Rat-Rig/V-core-3/README.md

# Rat Rig V-Core-3

[Project Page](https://v-core.ratrig.com/)
