Rat-Rig/V-core-3/cad/panels/README.md

# Enclosure & Electronics panels

This subdirectory contains the source files for the various panels used on the V-Core 3.

# Formats
## DXF
For laser cutting, industry standard DXF files are provided. Both metric (millimeters) and imperial (inches) versions are available.

> **Please note:** The dimensions in the DXF files are exact. No provision for laser kerf has been provided as this varies greatly depending on the material being cut, the laser cutter being used, and / or the operator of the machine.

## STEP
For CNC routing, or CAD applications, industry standard STEP files are provided. Both metric (millimeters) and imperial (inches) versions are available.
