Rat-Rig/V-core-3/docs/src/slicer.md

---
title: Slicer
hide:
  - navigation
---

## SuperSlicer
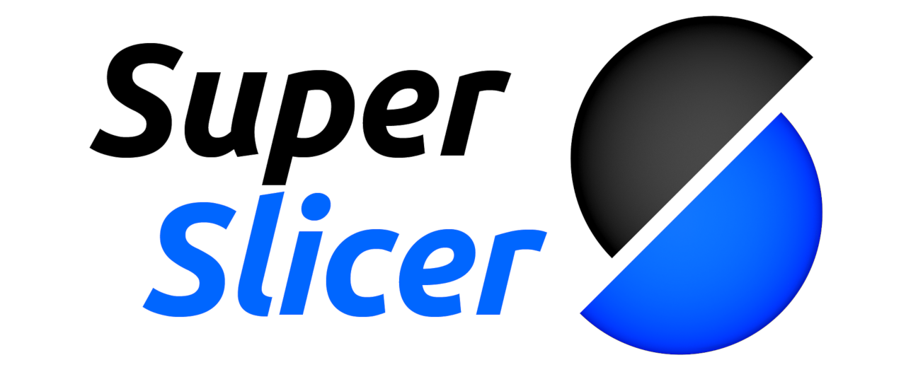
[picture p52: docs/src/assets/superslicer_logo.png]

Detlev Rackow, a member of Rat Rig's Beta/Dev team, provides SuperSlicer profiles for the V-Core 3 when running RatOS. As of version 2.3.57 these profiles are not included with SuperSlicer, and must be installed manually, but are planned to be intergrated in a future version.

### Obtaining SuperSlicer
SuperSlicer is a free and open-source project. It can be obtained directly from their [:material-github: GitHub repository](https://github.com/supermerill/SuperSlicer/releases)

### Installing the profiles in versions v2.3.57 and below
The following video shows how to manually obtain and install the profiles on SuperSlicer v2.3.57 and below:
<center><iframe width="1000" height="600" src="https://www.youtube.com/embed/cL5WGpLS94k" frameborder="0" allow="accelerometer; autoplay; clipboard-write; encrypted-media; gyroscope; picture-in-picture" allowfullscreen></iframe></center>

### Configuring SuperSlicer for the V-Core 3
!!! warning "Please read"

    Although the video shows configuring SuperSlicer for the V-Minion, the process is identical for the V-Core 3. Simply choose the appropriate V-Core 3 profile for your machine size, instead of choosing the V-Minion.

The following video gives an overview on configuring SuperSlicer to connect with your V-Core 3:
<center><iframe width="1000" height="600" src="https://www.youtube.com/embed/5o2UqtdWnn0" frameborder="0" allow="accelerometer; autoplay; clipboard-write; encrypted-media; gyroscope; picture-in-picture" allowfullscreen></iframe></center>
