Rat-Rig/V-core-3/docs/src/videos.md

---
title: Videos
hide:
  - navigation
---

## Teaching tech

Michael from Teaching Tech made a series of videos on his V-Core 3 build:

- [x] **Build volume:** 300x300x300   
- [x] **Main Board:** SKR Pro 1.2   
- [x] **Firmware:** Klipper       
- [x] **EVA:** Orbiter and V6

Michael's build is all about pushing the machine to its limits, and will be particularly appreciated by power users who are more experienced/advanced.

[:material-youtube: Teaching Tech V-Core 3 Youtube Playlist](https://www.youtube.com/watch?v=XoTxFs3BGuk&list=PLGqRUdq5ULsO0oLRZ1wiYvvpbhj4EV-Nf){ .md-button .md-button--primary }

## Vector3D

Adam from Vector3D live streamed his entire V-Core 3 build, from unboxing to first print:

- [x] **Build volume:** 300x300x300   
- [x] **Main Board:** Duet 3 Mini 5+ 
- [x] **Firmware:** RepRap Firmware       
- [x] **EVA:** BMG-M and V6

Adam built the Default Configuration of the V-Core 3, which is our recommended configuration for users who are looking for convenience, user friendliness and ease of set-up.

[:material-youtube: Vector 3D V-Core 3 Youtube Playlist](https://www.youtube.com/watch?v=9vuQLebiiAg&list=PLWL37f39O8e8akqQdy8Pjt2n6UtyTdXjF){ .md-button .md-button--primary }
