Rat-Rig/V-core-3/docs/src/legacy.md

---
title: Legacy V-Core 3.0
hide:
  - navigation
---

# V-Core 3.0
The following information relates to the legacy 3.0 version of the V-Core 3 project and is kept for reference only.

## Build Guide
The archived 3.0 build guide is available via our documentation site: https://ratrig.dozuki.com/c/Rat_Rig_V-Core_3

## CAD Models
| Size | Configuration ||
| ---- | --- ||
| 300x300 | [:fontawesome-solid-folder-open: Without Enclosure](https://a360.co/3uB8XUG){ target="_blank" } | [:fontawesome-solid-folder-open: With Enclosure](https://a360.co/3tMpcPS){ target="_blank" } |
| 400x400 | [:fontawesome-solid-folder-open: Without Enclosure](https://a360.co/3DftKkC){ target="_blank" } | [:fontawesome-solid-folder-open: With Enclosure](https://a360.co/3iESM3c){ target="_blank" } |
| 500x500 | [:fontawesome-solid-folder-open: Without Enclosure](https://a360.co/3uFR1Zo){ target="_blank" } | [:fontawesome-solid-folder-open: With Enclosure](https://a360.co/3IOMKYm){ target="_blank" } |

## Dimensions
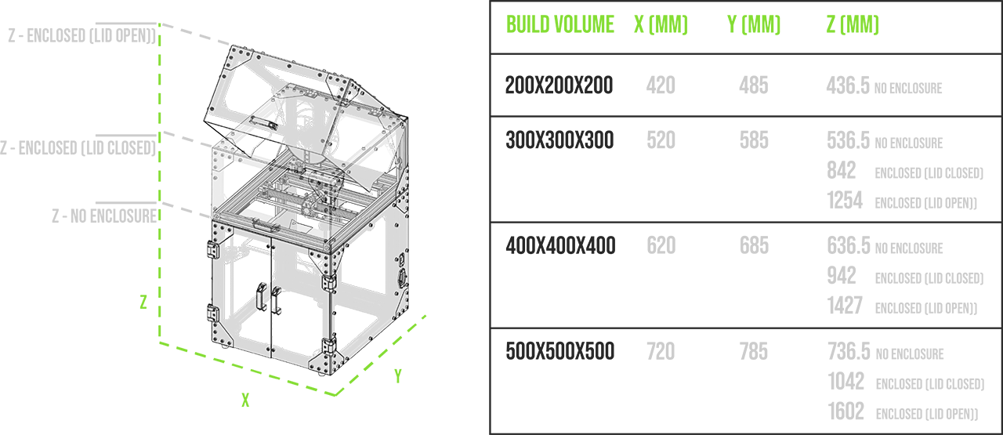
[picture p53: docs/src/assets/dimensions_legacy.png]


## Printed Parts
{{ printed_parts_bom_30("bom/3.0/printed_parts_essentials.csv") }}

{{ printed_parts_bom_30("bom/3.0/printed_parts_accessories.csv") }}

{{ printed_parts_bom_30("bom/3.0/printed_parts_extras.csv") }}

## Panels
STL, STEP and DXF files are neatly organized in the project repository on GitHub, navigate to [:fontawesome-brands-github: project repository](https://github.com/Rat-Rig/V-core-3/tree/1.0.4/cad) to access the files. Alternatively you can download the whole project in a ZIP package [:material-archive-arrow-down: here](https://github.com/Rat-Rig/V-core-3/archive/1.0.4.zip).

## Bill of Materials
{{ hardware_bom("bom/3.0/vcore3_05042022_1602.csv") }}
{{ hardware_bom("bom/3.0/V-Core 3 Enclosure Kit Public BOM.csv") }}
{{ hardware_bom("bom/3.0/V-Core 3 Enclosure Kit Public BOM - spool holder.csv") }}
