Rat-Rig/V-core-3/docs/src/assets/3_point.png

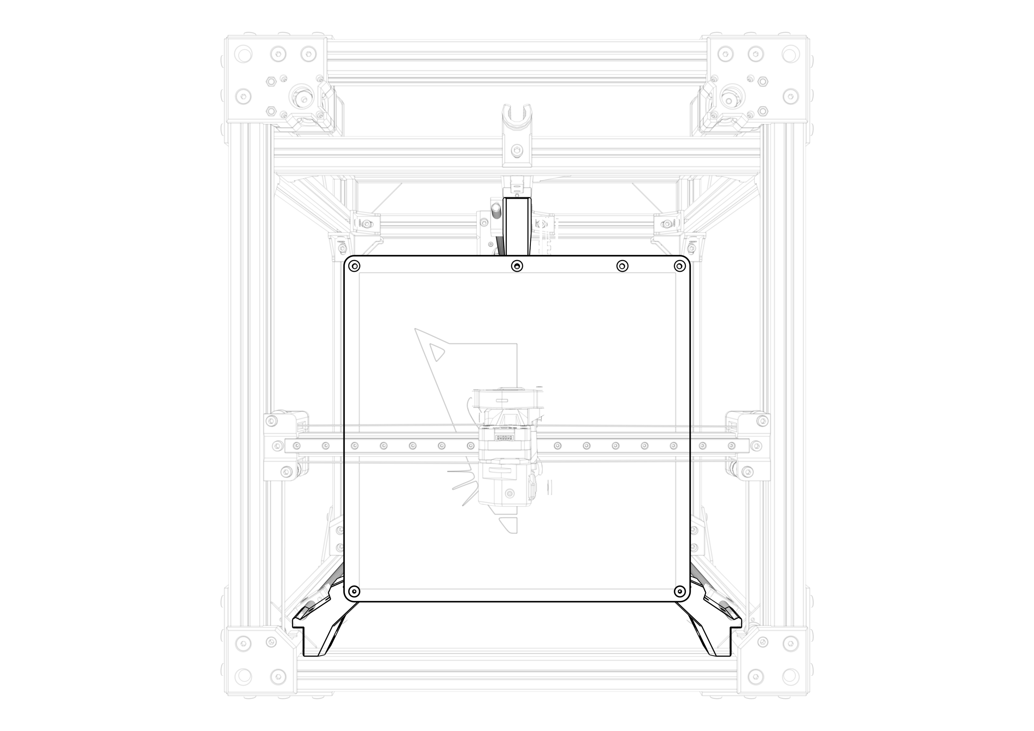
docs/src/assets/3_point.png
