Rat-Rig/V-core-3/docs/src/assets/360/main/V3_12.jpg

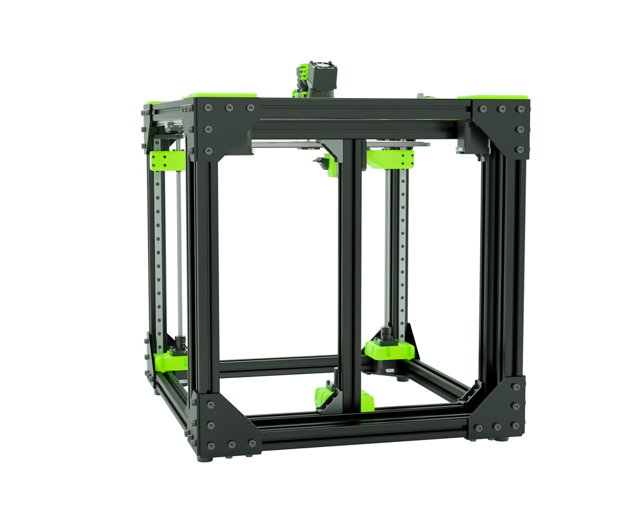
docs/src/assets/360/main/V3_12.jpg
