Rat-Rig/V-core-3/docs/src/assets/3030.png

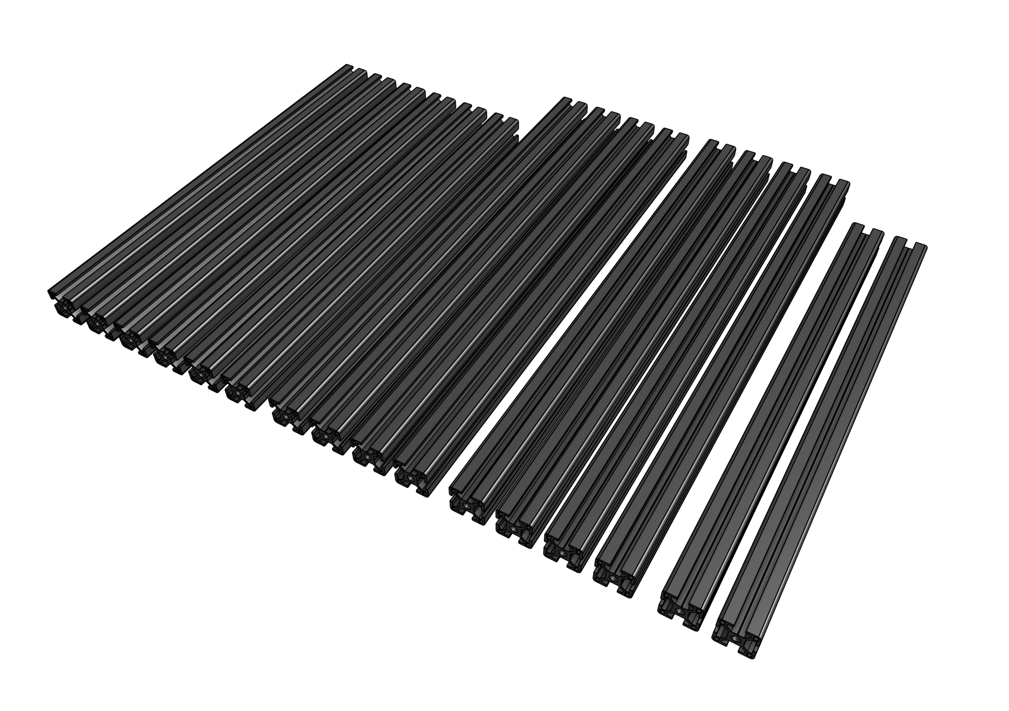
docs/src/assets/3030.png
