Rat-Rig/V-core-3/docs/src/assets/electronics_back.png

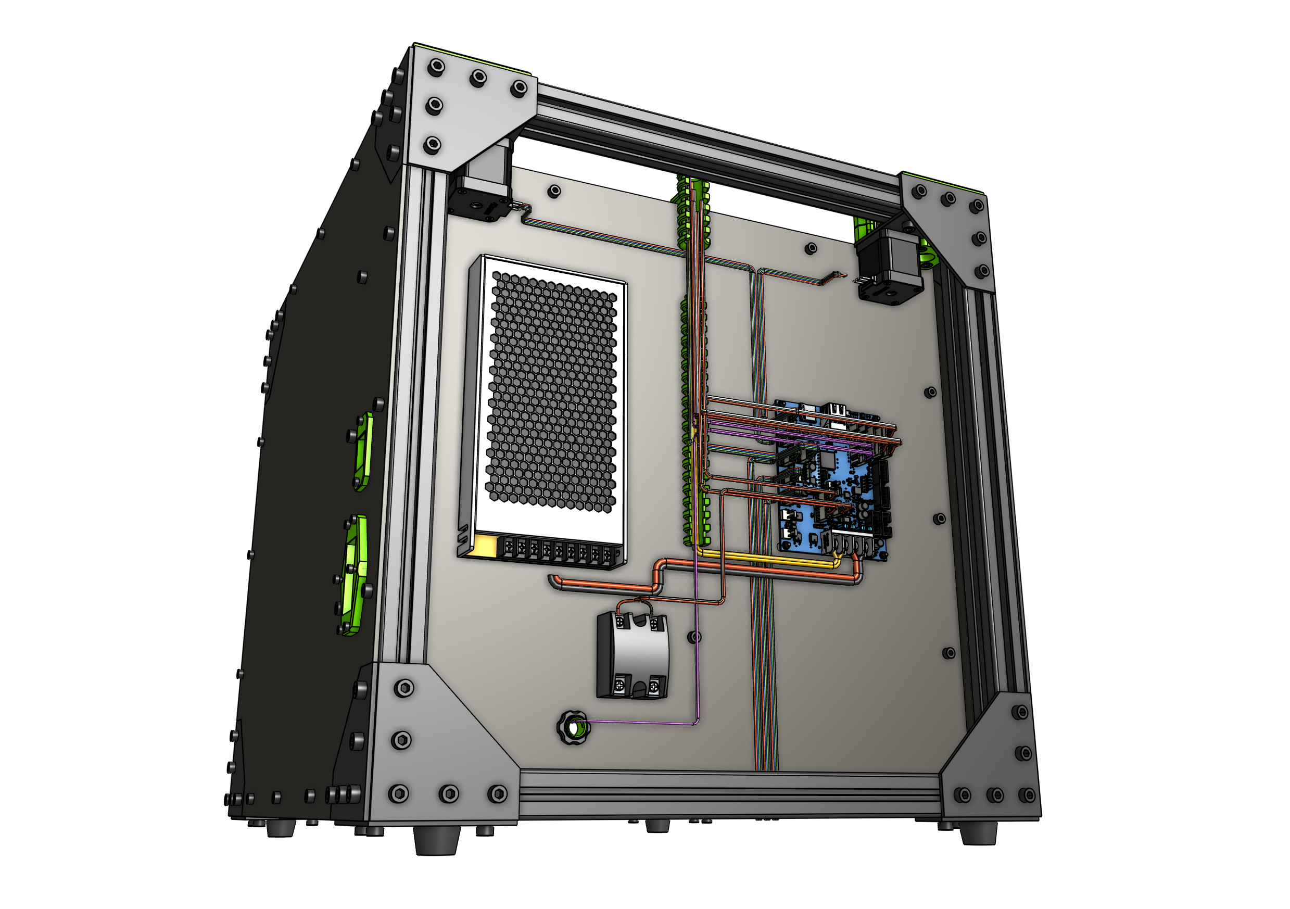
docs/src/assets/electronics_back.png
