Rat-Rig/V-core-3/docs/src/assets/eva/aero.png

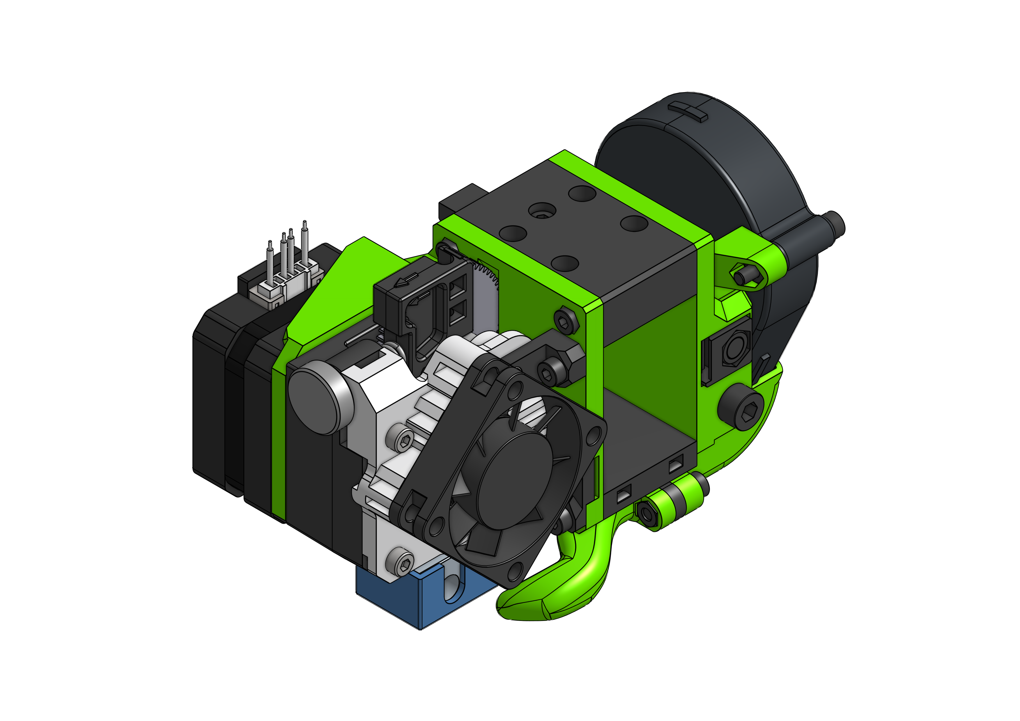
docs/src/assets/eva/aero.png
