Rat-Rig/V-core-3/docs/src/assets/eva/bmg.png

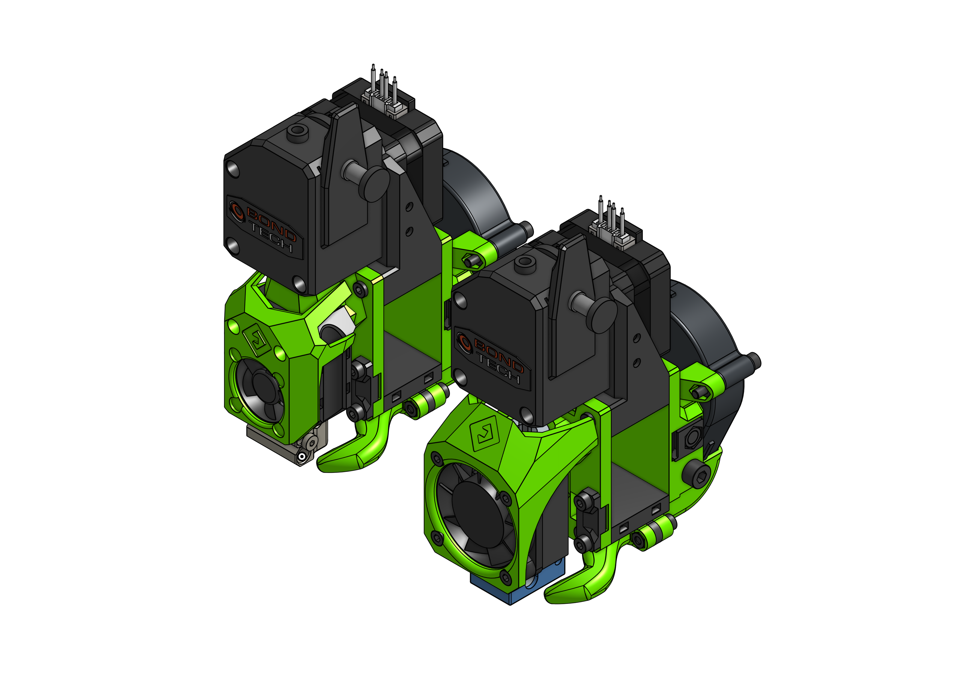
docs/src/assets/eva/bmg.png
