Rat-Rig/V-core-3/docs/src/assets/eva/bowden.png

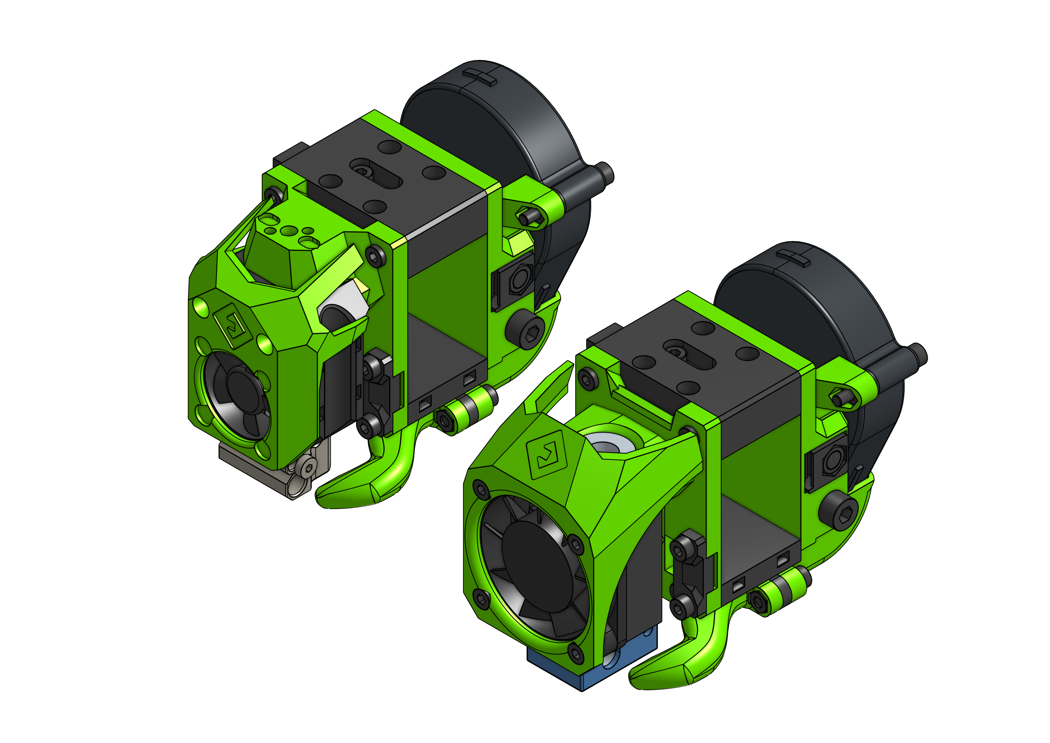
docs/src/assets/eva/bowden.png
