Rat-Rig/V-core-3/docs/src/assets/eva/titan.png

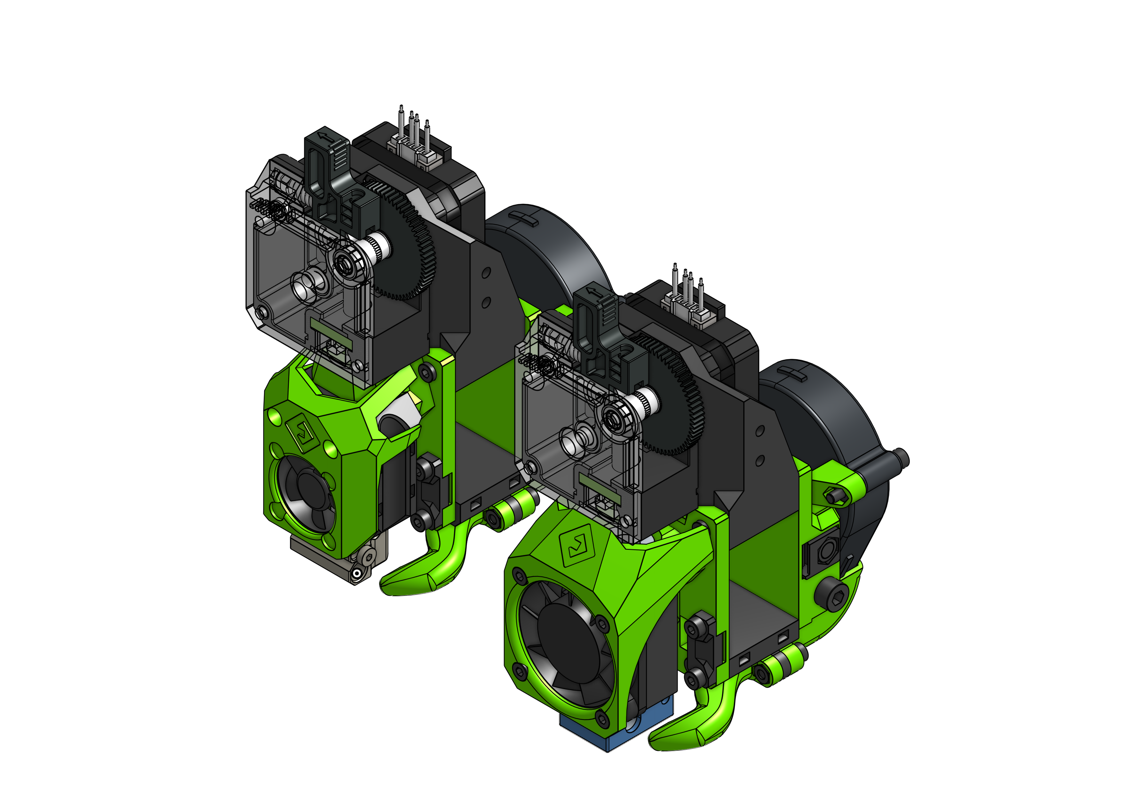
docs/src/assets/eva/titan.png
