Rat-Rig/V-core-3/docs/src/assets/extras.png

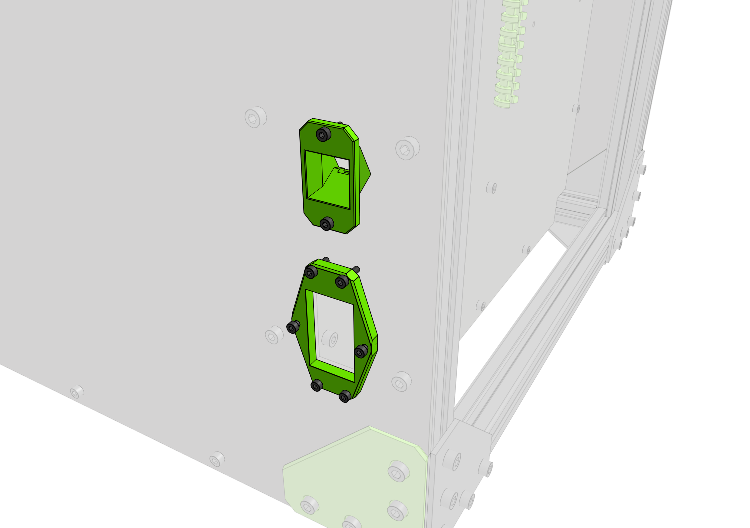
docs/src/assets/extras.png
