Rat-Rig/V-core-3/docs/src/assets/lead.png

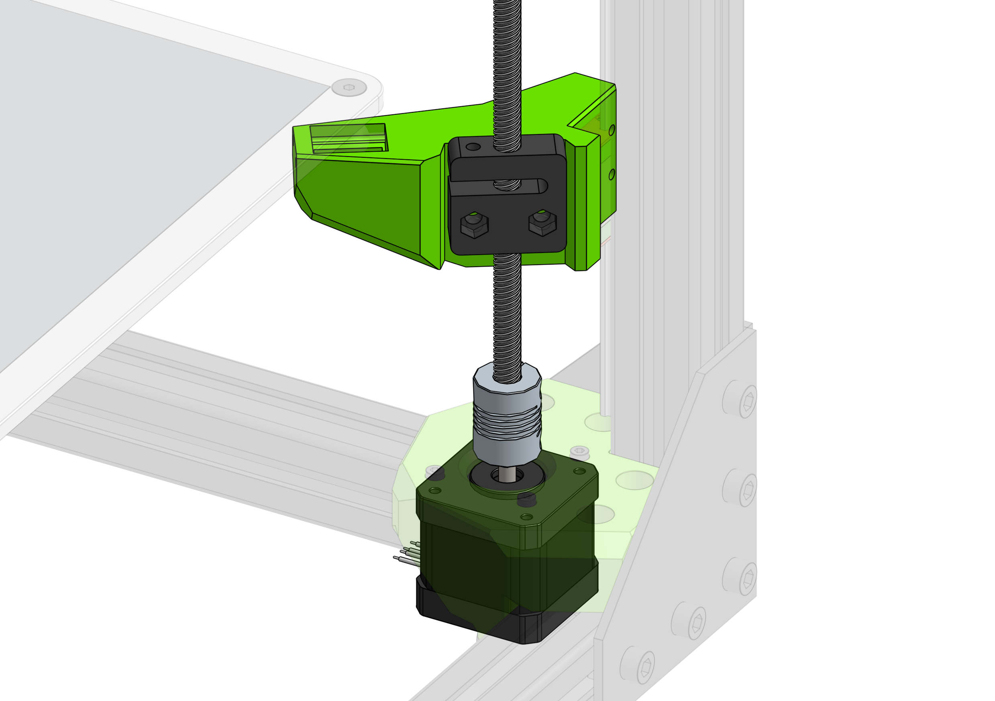
docs/src/assets/lead.png
