Rat-Rig/V-core-3/docs/src/assets/LeadScrew.png

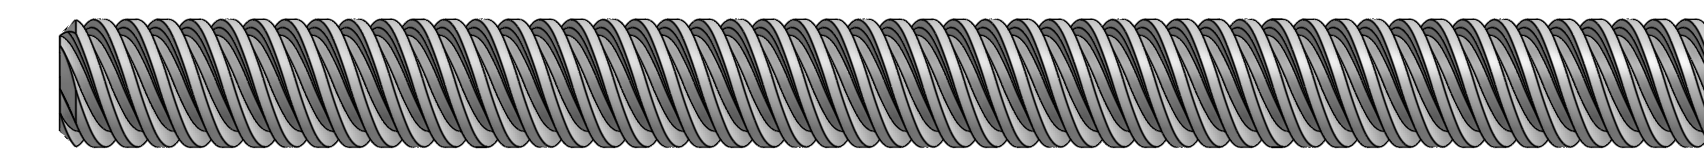
docs/src/assets/LeadScrew.png
