Rat-Rig/V-core-3/docs/src/assets/main.png

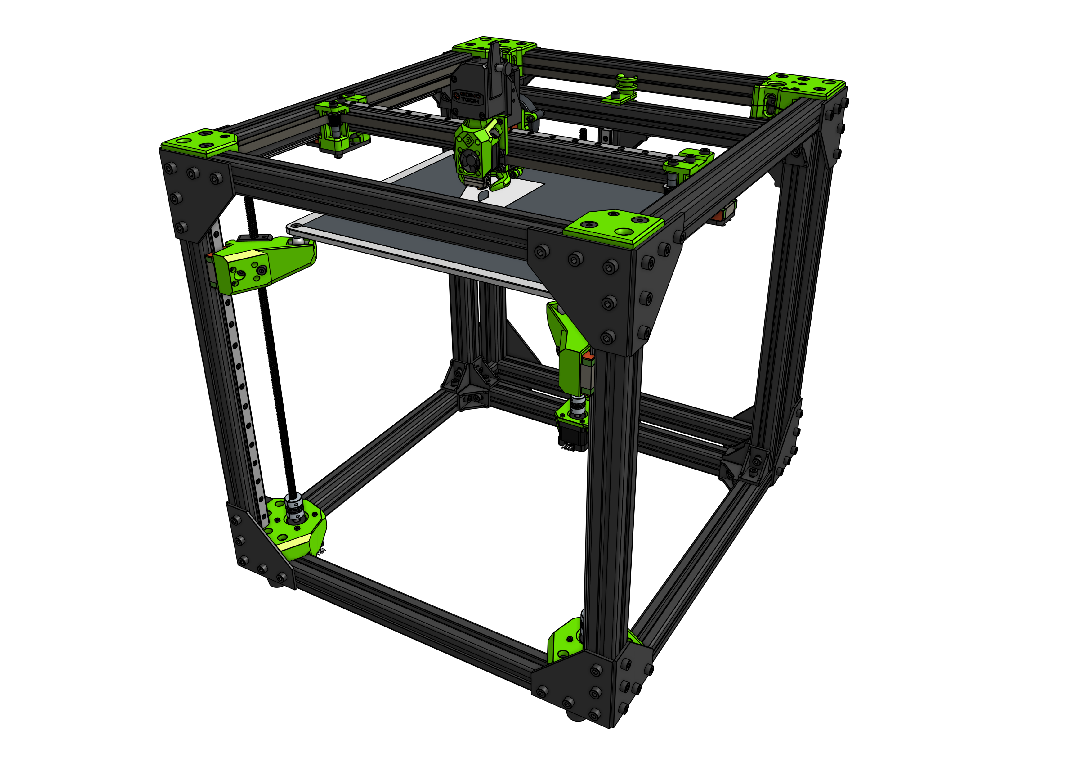
docs/src/assets/main.png
