Rat-Rig/V-core-3/docs/src/assets/MAIN_with_Enclosure.png

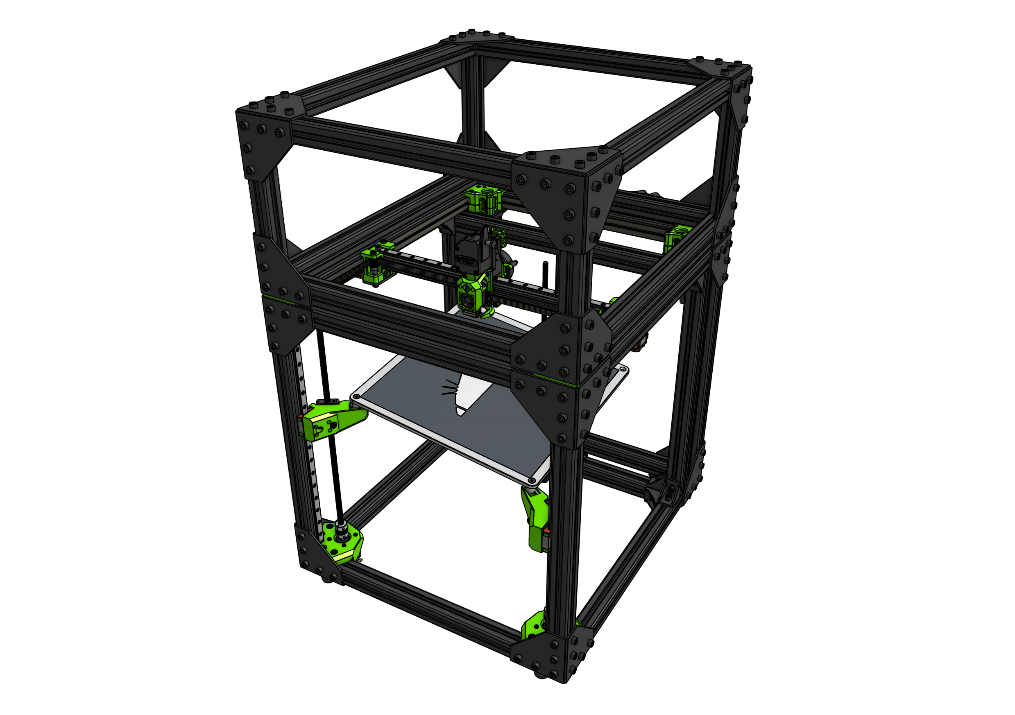
docs/src/assets/MAIN_with_Enclosure.png
