Rat-Rig/V-core-3/docs/src/assets/modding.jpg

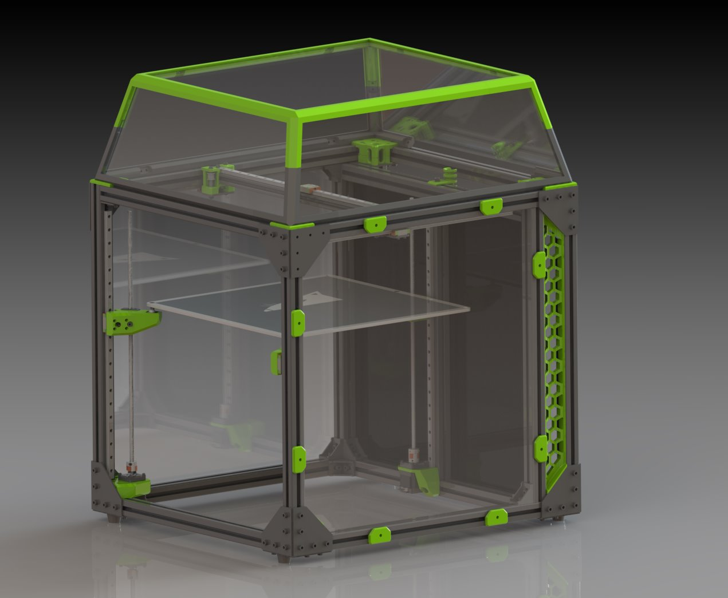
docs/src/assets/modding.jpg
