Rat-Rig/V-core-3/docs/src/assets/samples/02.png

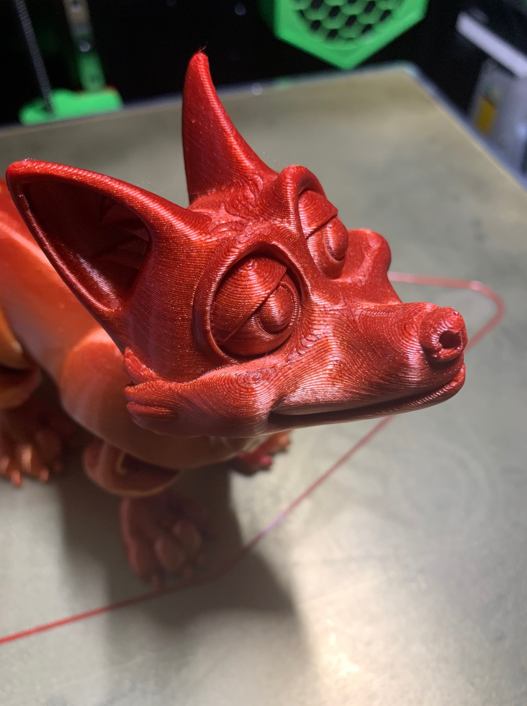
docs/src/assets/samples/02.png
