Rat-Rig/V-core-3/docs/src/bom.md

---
title: BOM
hide:
  - navigation
---

# Bill of Materials

!!! warning "WARNING: Regarding the Raspberry Pi shortage"

    The V-Core 3 requires a Raspberry Pi if you wish to use RatOS. However, due to the worldwide semiconductor shortage, availability of these can vary on a day-to-day basis. The store pages for the V-Core 3 kits now include a customizable option allowing purchase of a Raspberry Pi if required, and if they are currently in stock.

    If the Raspberry Pi you wish to purchase is not currently in stock, the [:material-link-box-variant:Raspberry Pi Locator](https://rpilocator.com/){: target=_blank} website can be of great assistance in sourcing one in your country.

## V-Core 3.1 Core Kits

[:material-table: Download in CSV Format](https://github.com/Rat-Rig/V-core-3/blob/main/docs/src/bom/vcore31_bom.csv){: .md-button .md-button--primary target=_blank}

{{ hardware_bom("bom/vcore31_bom.csv") }}

## V-Core 3.1 Enclosure 2.0 Kits

[:material-table: Download in CSV Format](https://github.com/Rat-Rig/V-core-3/blob/main/docs/src/bom/enclosure2_bom.csv){: .md-button .md-button--primary target=_blank}

{{ hardware_bom("bom/enclosure2_bom.csv") }}
