Rat-Rig/V-core-3/docs/src/bom/vcore3_17022022_1046.csv

 | SKU |  |  | Product Name
 | HW2649GK |  |  | Rat Rig V-Core 3 - 300mm Specific Parts
 | B.O.M.
QTY | SKU | Length (mm) | Tap | Item name
1 | HW306BRC | 420 |  | T-SLOT 3030 - Black Anodized 1000mm
6 | HW306BRC | 440 |  | T-SLOT 3030 - Black Anodized 1000mm
2 | HW306BRC | 450 |  | T-SLOT 3030 - Black Anodized 1000mm
4 | HW306BRC | 505 |  | T-SLOT 3030 - Black Anodized 1000mm
4 | HW306BRC | 510 |  | T-SLOT 3030 - Black Anodized 1000mm
1 | HW201BRC | 422 |  | V-SLOT 2020 - Black Anodized 1000mm
4 | HW2036GC |  |  | Linear Rail - MGN12 400mm + MGN12C carriage
2 | HW2353GC |  |  | Linear Rail - MGN12 350mm + MGN12C carriage
3 | HW2191SC |  |  | Lead Screw - TR8*4 Metric Acme Lead Screw - 380mm
1 | HW2198PC |  |  | Bed Plate - Cast tooling plate - Pre-Machined - 329*329*6mm
1 | HW1653GC | 4200 |  | Timing Belt - 2GT 9mm (By the meter)
 | SKU |  |  | Product Name
 | HW2650GK |  |  | Rat Rig V-Core 3 - 400mm Specific Parts
 | B.O.M.
QTY | SKU | Length (mm) | Tap | Item name
1 | HW306BRC | 520 |  | T-SLOT 3030 - Black Anodized 1000mm
6 | HW306BRC | 540 |  | T-SLOT 3030 - Black Anodized 1000mm
2 | HW306BRC | 550 |  | T-SLOT 3030 - Black Anodized 1000mm
4 | HW306BRC | 605 |  | T-SLOT 3030 - Black Anodized 1000mm
4 | HW306BRC | 610 |  | T-SLOT 3030 - Black Anodized 1000mm
1 | HW201BRC | 522 |  | V-SLOT 2020 - Black Anodized 1000mm
4 | HW2034GC |  |  | Linear Rail - MGN12 500mm + MGN12C carriage
2 | HW2354GC |  |  | Linear Rail - MGN12 450mm + MGN12C carriage
3 | HW2192SC |  |  | Lead Screw - TR8*4 Metric Acme Lead Screw - 480mm
1 | HW2199PC |  |  | Bed Plate - Cast tooling plate - Pre-Machined - 429*429*6mm
1 | HW1653GC | 5000 |  | Timing Belt - 2GT 9mm (By the meter)
4 | HW1502SC |  |  | Cap Head Screw M3 (Single) (Length: 8mm)
20 | HW1292SC |  |  | Cap Head Screw M3 (Single) (Length: 12mm)
20 | HW1821NC |  |  | T-Nut - Drop In for 3030 - M3 (Single)
4 | HW1665NC |  |  | T-Nut - Drop In for 2020 - M3 (Single)
 | SKU |  |  | Product Name
 | HW2651GK |  |  | Rat Rig V-Core 3 - 500mm Specific Parts
 | B.O.M.
QTY | SKU | Length (mm) | Tap | Item name
1 | HW306BRC | 620 |  | T-SLOT 3030 - Black Anodized 1000mm
6 | HW306BRC | 640 |  | T-SLOT 3030 - Black Anodized 1000mm
2 | HW306BRC | 650 |  | T-SLOT 3030 - Black Anodized 1000mm
4 | HW306BRC | 705 |  | T-SLOT 3030 - Black Anodized 1000mm
4 | HW306BRC | 710 |  | T-SLOT 3030 - Black Anodized 1000mm
1 | HW201BRC | 622 |  | V-SLOT 2020 - Black Anodized 1000mm
4 | HW2356GC |  |  | Linear Rail - MGN12 600mm + MGN12C carriage
2 | HW2355GC |  |  | Linear Rail - MGN12 550mm + MGN12C carriage
3 | HW2193SC |  |  | Lead Screw - TR8*4 Metric Acme Lead Screw - 580mm
1 | HW2200PC |  |  | Bed Plate - Cast tooling plate - Pre-Machined - 529*529*6mm
1 | HW1653GC | 5800 |  | Timing Belt - 2GT 9mm (By the meter)
8 | HW1502SC |  |  | Cap Head Screw M3 (Single) (Length: 8mm)
40 | HW1292SC |  |  | Cap Head Screw M3 (Single) (Length: 12mm)
40 | HW1821NC |  |  | T-Nut - Drop In for 3030 - M3 (Single)
8 | HW1665NC |  |  | T-Nut - Drop In for 2020 - M3 (Single)
 | SKU |  |  | Product Name
 | HW2648GK |  |  | Rat Rig V-Core 3 - Base Parts Kit - All Versions
 | B.O.M.
QTY | SKU | Length (mm) | Tap | Item name
20 | HW1915PC |  |  | Joining Plate for 3030 - 90 Degree - Black Anodized
2 | HW2201PC |  |  | V-Core 3.0 - IDLER_PLATE_V1.0
2 | HW2202PC |  |  | V-Core 3.0 - MOTOR_PLATE_V1.0
2 | HW2203PC |  |  | V-Core 3.0 - XY_JOINER_PLATE_V1.0
12 | HW1916BC |  |  | Cast 90 Degree Corner Bracket for 3030 - 6 Slot - Black
2 | HW1505SC |  |  | Cap Head Screw M3 (Single) (Length: 10mm)
76 | HW1292SC |  |  | Cap Head Screw M3 (Single) (Length: 12mm)
12 | HW1866SC |  |  | Cap Head Screw M3 (Single) (Length: 18mm)
12 | HW1504SC |  |  | Cap Head Screw M3 (Single) (Length: 20mm)
2 | HW1227SK |  |  | Cap Head Screw M3 (Single) (Length: 30mm)
8 | HW1868SC |  |  | Cap Head Screw M3 (Single) (Length: 35mm)
24 | HW1502SC |  |  | Cap Head Screw M3 (Single) (Length: 8mm)
4 | HW1285SC |  |  | Cap Head Screw M5 (Single) (Length: 10mm)
4 | HW1202SC |  |  | Cap Head Screw M5 (Single) (Length: 12mm)
4 | HW2110SC |  |  | Cap Head Screw M5 (Single) (Length: 18mm)
6 | HW1060SC |  |  | Cap Head Screw M5 (Single) (Length: 35mm)
6 | HW2138SC |  |  | Cap Head Screw M5 (Single) (Length: 40mm)
4 | HW2140SC |  |  | Cap Head Screw M5 (Single) (Length: 55mm)
151 | HW1836SC |  |  | Cap Head Screw M6 (Single) (Length: 12mm)
10 | HW1870SC |  |  | Cap Head Screw M6 (Single) (Length: 20mm)
6 | HW2137SC |  |  | Countersink Screw M3 (Single) (Length: 20mm)
3 | HW2349SC |  |  | Countersink Screw M5 (Single) (Length: 16mm)
10 | HW2173SC |  |  | Countersink Screw M6 (Single) (Length: 14mm)
16 | HW1665NC |  |  | T-Nut - Drop In for 2020 - M3 (Single)
76 | HW1821NC |  |  | T-Nut - Drop In for 3030 - M3 (Single)
5 | HW1383NC |  |  | T-Nut - Drop In for 3030 - M5 (Single)
171 | HW1361NC |  |  | T-Nut - Drop In for 3030 - M6 (Single)
6 | HW1522NC |  |  | T-Nut - Square for 2020 - M5 (Single)
8 | HW1251NC |  |  | Hex Locking Nut - M3
17 | HW1039NC |  |  | Hex Locking Nut - M5
15 | HW1018NC |  |  | Aluminium Spacer - 6mm
4 | HW2120WC |  |  | Micro Precision Shim - 6.5 x 5 x 1mm
24 | HW1630NC |  |  | Mini Precision Shim - 8 x 5 x 1mm - C
8 | HW2678NC |  |  | Nylon Spacer - 3mm x 7mm x 5mm
38 | HW2746NC |  |  | Washer Simple M6 - Black 12.9 Steel
3 | HW2204GC |  |  | Coupler - Spider/Jaw Type - 5mm*8mm
10 | HW2806WC |  |  | Idler Pulley - Smooth for 2GT-20T - 9mm Belt - 5mm Bore (Compressible)
2 | HW2854WC |  |  | Idler Pulley - Toothed for 2GT-20T - 9mm Belt - 5mm Bore (Compressible)
2 | HW1654WC |  |  | Timing Pulley - 2GT (2mm) - 20 Tooth - For 9mm Belt - 5mm Bore
3 | HW2118WC |  |  | Thrust Bearing F8-16M
6 | HW2126GC |  |  | Dowel Pin - 3.0mm x 35.0mm
3 | HW2127GC |  |  | Magnet - 20 x 10 x 5mm - Two hole (M3 Countersink screws)
4 | HW2125GC |  |  | Rubber foot with metal insert - Heavy Duty - 28*22*16.5mm
3 | HW2128GC |  |  | Steel Ball - 12mm - Threaded M5
3 | HW2205GC |  |  | TR8*4 Anti-Backlash Nut Block
1 | HW2687GK |  |  | V-Core 3 Extra Parts Bag
1 | HW2900GK |  |  | EVA 2.4.2 Hardware Pack
 | SKU |  |  | Product Name
 | HW2687GK |  |  | V-Core 3 Extra Parts Bag
 | B.O.M.
QTY | SKU | Length (mm) | Tap | Item name
4 | HW1502SC |  |  | Cap Head Screw M3 (Single) (Length: 8mm)
8 | HW1292SC |  |  | Cap Head Screw M3 (Single) (Length: 12mm)
8 | HW1836SC |  |  | Cap Head Screw M6 (Single) (Length: 12mm)
8 | HW1821NC |  |  | T-Nut - Drop In for 3030 - M3 (Single)
8 | HW1361NC |  |  | T-Nut - Drop In for 3030 - M6 (Single)
4 | HW1039NC |  |  | Hex Locking Nut - M5
4 | HW1630NC |  |  | Mini Precision Shim - 8 x 5 x 1mm - C
2 | HW2120WC |  |  | Micro Precision Shim - 6.5 x 5 x 1mm
 | SKU |  |  | Product Name
 | HW2658GK |  |  | Rat Rig V-Core 3 - 300mm Standard Kit v1.1
 | B.O.M.
QTY | SKU | Length (mm) | Tap | Item name
1 | HW2642GK |  |  | Rat Rig V-Core 3 - 300mm Mechanical Kit
1 | HW2832EC |  |  | BTT Octopus V1.1 Motherboard (board only - no drivers)
1 | HW2846EC |  |  | BigTreeTech TMC2209 Driver SPI (6 x PACK)
1 | HW2838EC |  |  | RASPBERRY PI 3 B+ (1.4GHz, 1GB RAM, USB 2.0)
1 | HW2847EC |  |  | Phaetus Rapido UHF Hotend - Black
1 | HW2840EC |  |  | LGX Lite Extruder by Bondtech
5 | HW1078EC |  |  | Nema 17 Stepper Motor - 48mm - 1.8degree/step, 76oz-in
4 | HW1698EC |  |  | Nema 17 Stepper Motor Cable - 1mt
2 | HW1699EC |  |  | Nema 17 Stepper Motor Cable - 2mt
1 | HW2346EK |  |  | Heater Bed Pad Kit - Keenovo 280 x 280mm 220V 600W(Thermal fuse) + SSR 40A Relay
1 | HW1895GC |  |  | FlexPlate Set - Powder coated PEI 310 x 310 mm
1 | HW2902EC |  |  | Power Supply Meanwell - 200Watt 24V - LRS-200-24 (Fanless)
1 | HW2815EC |  |  | Fan - 40mm Axial Brushless 24V DC - 1500mm Cable - GDSTime High Quality (Double Ball Bearing)
1 | HW2817EC |  |  | Fan - 50mm Blower Type 24V DC - 1500mm Cable - GDSTime High Quality (Double Ball Bearing)
1 | HW2901EC |  |  | Rat Rig "SuperPinda" probe by Pepperl & Fuchs (Inductive 5VDC Sensor)
2 | HW2685EC |  |  | Endstop Module - Horizontal Limit switch with 1mt cable and connector
1 |  |  |  | Printed parts (LGX Lite + Rapido)
 | SKU |  |  | Product Name
 | HW2659GK |  |  | Rat Rig V-Core 3 - 400mm Standard Kit v1.1
 | B.O.M.
QTY | SKU | Length (mm) | Tap | Item name
1 | HW2643GK |  |  | Rat Rig V-Core 3 - 400mm Mechanical Kit
1 | HW2832EC |  |  | BTT Octopus V1.1 Motherboard (board only - no drivers)
1 | HW2846EC |  |  | BigTreeTech TMC2209 Driver SPI (6 x PACK)
1 | HW2838EC |  |  | RASPBERRY PI 3 B+ (1.4GHz, 1GB RAM, USB 2.0)
1 | HW2847EC |  |  | Phaetus Rapido UHF Hotend - Black
1 | HW2840EC |  |  | LGX Lite Extruder by Bondtech
5 | HW1078EC |  |  | Nema 17 Stepper Motor - 48mm - 1.8degree/step, 76oz-in
4 | HW1698EC |  |  | Nema 17 Stepper Motor Cable - 1mt
2 | HW1699EC |  |  | Nema 17 Stepper Motor Cable - 2mt
1 | HW2347EK |  |  | Heater Bed Pad Kit - Keenovo 380 x 380mm 220V 1000W(Thermal fuse) + SSR 40A Relay
1 | HW1896GC |  |  | FlexPlate Set - Powder coated PEI 410 x 410 mm
1 | HW2902EC |  |  | Power Supply Meanwell - 200Watt 24V - LRS-200-24 (Fanless)
1 | HW2815EC |  |  | Fan - 40mm Axial Brushless 24V DC - 1500mm Cable - GDSTime High Quality (Double Ball Bearing)
1 | HW2817EC |  |  | Fan - 50mm Blower Type 24V DC - 1500mm Cable - GDSTime High Quality (Double Ball Bearing)
1 | HW2901EC |  |  | Rat Rig "SuperPinda" probe by Pepperl & Fuchs (Inductive 5VDC Sensor)
2 | HW2685EC |  |  | Endstop Module - Horizontal Limit switch with 1mt cable and connector
1 |  |  |  | Printed parts (LGX Lite + Rapido)
 | SKU |  |  | Product Name
 | HW2660GK |  |  | Rat Rig V-Core 3 - 500mm Standard Kit v1.1
 | B.O.M.
QTY | SKU | Length (mm) | Tap | Item name
1 | HW2644GK |  |  | Rat Rig V-Core 3 - 500mm Mechanical Kit
1 | HW2832EC |  |  | BTT Octopus V1.1 Motherboard (board only - no drivers)
1 | HW2846EC |  |  | BigTreeTech TMC2209 Driver SPI (6 x PACK)
1 | HW2838EC |  |  | RASPBERRY PI 3 B+ (1.4GHz, 1GB RAM, USB 2.0)
1 | HW2847EC |  |  | Phaetus Rapido UHF Hotend - Black
1 | HW2840EC |  |  | LGX Lite Extruder by Bondtech
5 | HW1078EC |  |  | Nema 17 Stepper Motor - 48mm - 1.8degree/step, 76oz-in
4 | HW1698EC |  |  | Nema 17 Stepper Motor Cable - 1mt
2 | HW1699EC |  |  | Nema 17 Stepper Motor Cable - 2mt
1 | HW2729EK |  |  | Heater Bed Pad Kit - Keenovo 480 x 480mm 220V 1500W(Thermal fuse) + SSR 40A Relay
1 | HW1897GC |  |  | FlexPlate Set - Powder coated PEI 510 x 510 mm
1 | HW2902EC |  |  | Power Supply Meanwell - 200Watt 24V - LRS-200-24 (Fanless)
1 | HW2815EC |  |  | Fan - 40mm Axial Brushless 24V DC - 1500mm Cable - GDSTime High Quality (Double Ball Bearing)
1 | HW2817EC |  |  | Fan - 50mm Blower Type 24V DC - 1500mm Cable - GDSTime High Quality (Double Ball Bearing)
1 | HW2901EC |  |  | Rat Rig "SuperPinda" probe by Pepperl & Fuchs (Inductive 5VDC Sensor)
2 | HW2685EC |  |  | Endstop Module - Horizontal Limit switch with 1mt cable and connector
1 |  |  |  | Printed parts (LGX Lite + Rapido)
