Rat-Rig/V-core-3/cad/panels/DXF/Imperial Units (Inches)/500/panel_electronics_split_500_top_right.dxf

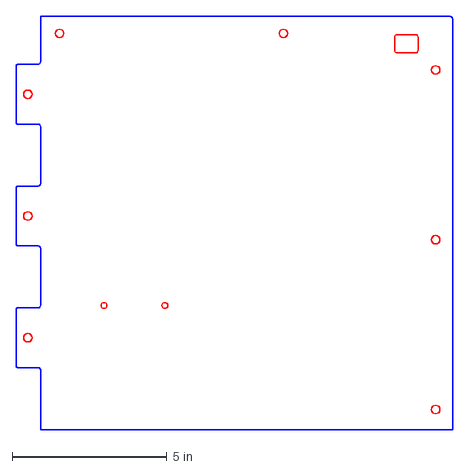
[picture p87: CAD file, 2023-03-22]
cad/panels/DXF/Imperial Units (Inches)/500/panel_electronics_split_500_top_right.dxf
14.1 x 13.4 in
