Rat-Rig/V-core-3/cad/panels/DXF/Metric Units (mm)/300/panel_electronics_split_300_plain_right_left.dxf

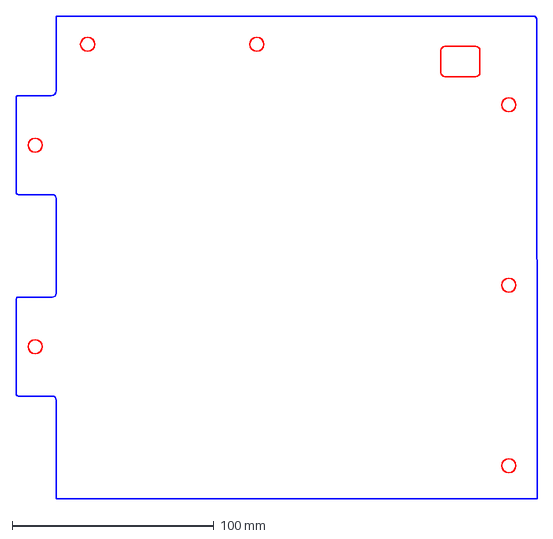
[picture p88: CAD file, 2022-07-04]
cad/panels/DXF/Metric Units (mm)/300/panel_electronics_split_300_plain_right_left.dxf
258.5 x 239.5 mm
