Rat-Rig/V-core-3/cad/panels/STEP/Imperial Units (Inches)/200/panel_electronics_200.step

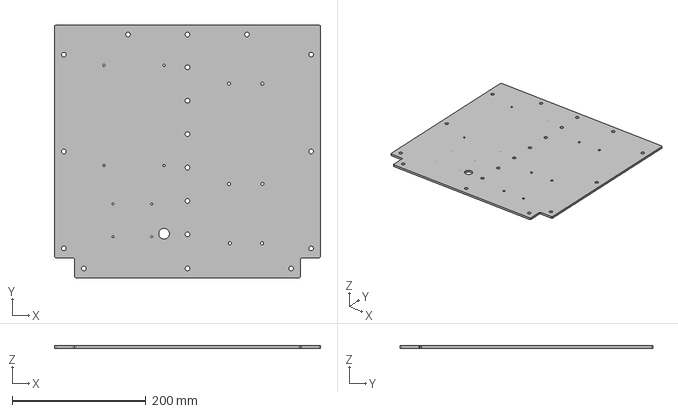
[picture p89: CAD file, 2023-07-17]
cad/panels/STEP/Imperial Units (Inches)/200/panel_electronics_200.step
398.0 x 378.0 x 4.00 mm
