Rat-Rig/V-core-3/cad/panels/STEP/Imperial Units (Inches)/300/panel_electronics_split_300_bottom_left.step

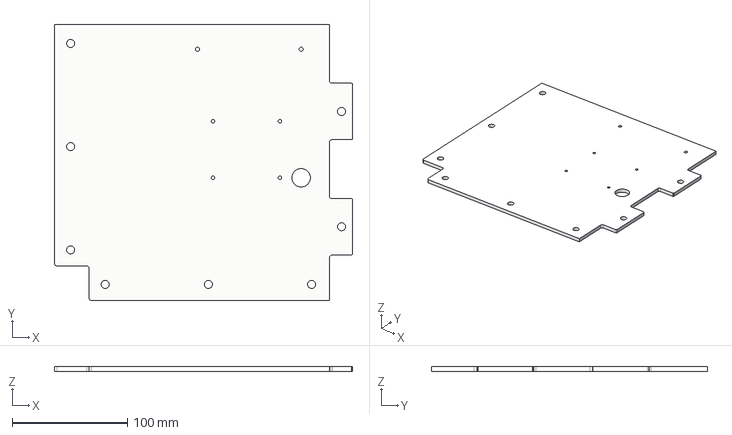
[picture p90: CAD file, 2023-03-22]
cad/panels/STEP/Imperial Units (Inches)/300/panel_electronics_split_300_bottom_left.step
258.5 x 239.5 x 4.00 mm
