Rat-Rig/V-core-3/cad/panels/STEP/Imperial Units (Inches)/400/panel_electronics_split_400_top_right.step

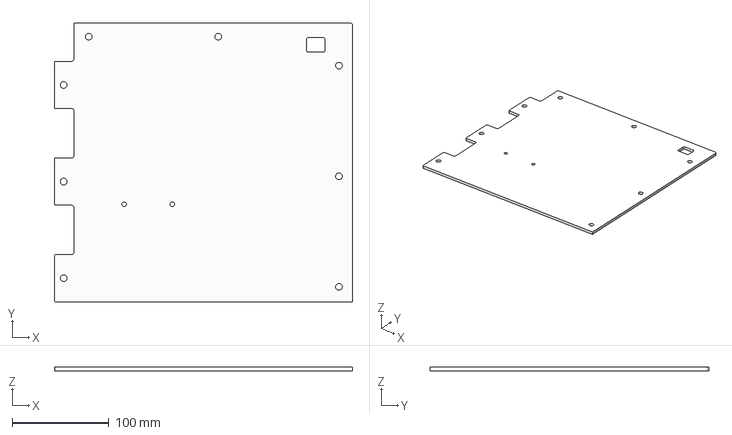
[picture p91: CAD file, 2023-03-22]
cad/panels/STEP/Imperial Units (Inches)/400/panel_electronics_split_400_top_right.step
308.5 x 288.5 x 4.00 mm
