Rat-Rig/V-core-3/cad/panels/STEP/Imperial Units (Inches)/500/panel_electronics_500.step

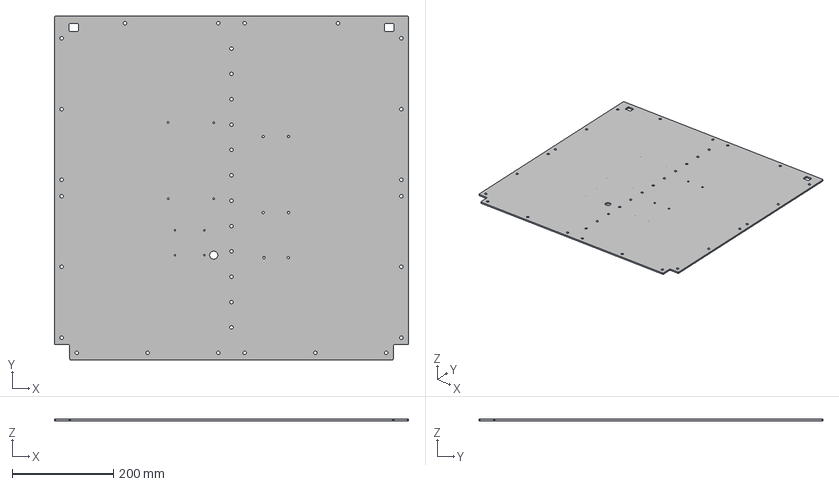
[picture p92: CAD file, 2023-03-22]
cad/panels/STEP/Imperial Units (Inches)/500/panel_electronics_500.step
698.0 x 678.0 x 4.00 mm
