Rat-Rig/V-core-3/cad/panels/STEP/Imperial Units (Inches)/IDEX/panel_enc2_idex_door_300.step

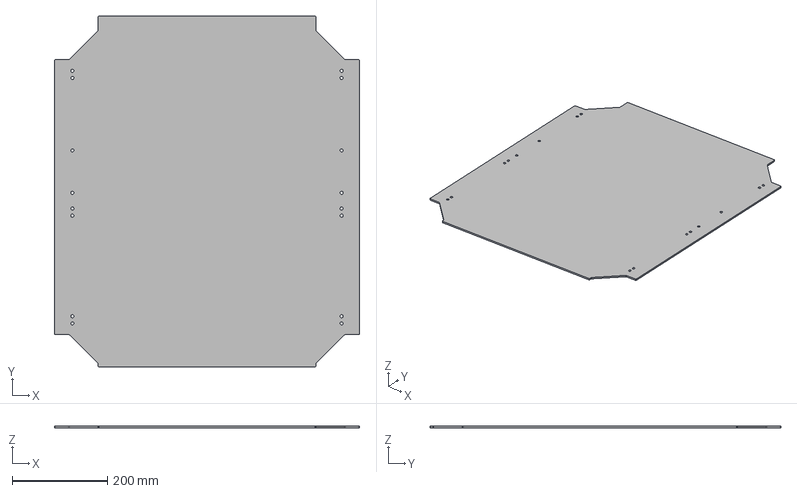
[picture p93: CAD file, 2023-07-25]
cad/panels/STEP/Imperial Units (Inches)/IDEX/panel_enc2_idex_door_300.step
640.0 x 736.5 x 4.00 mm
