Rat-Rig/V-core-3/cad/panels/STEP/Metric Units (mm)/500/panel_electronics_split_500_bottom_right.step

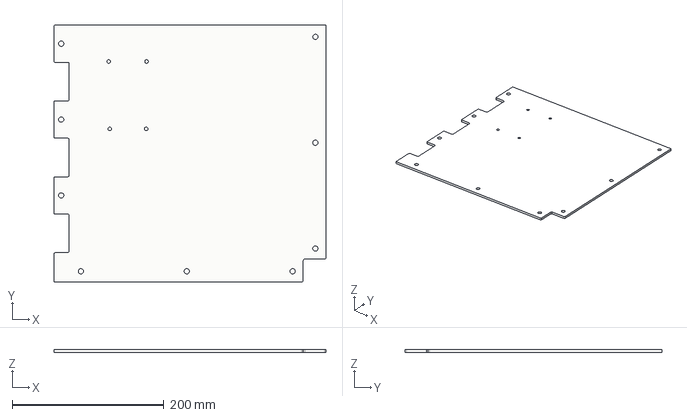
[picture p94: CAD file, 2023-03-22]
cad/panels/STEP/Metric Units (mm)/500/panel_electronics_split_500_bottom_right.step
358.5 x 338.5 x 4.00 mm
