Rat-Rig/V-core-3/cad/panels/STEP/Metric Units (mm)/IDEX/panel_idex_electronics_split_300_top_right.step

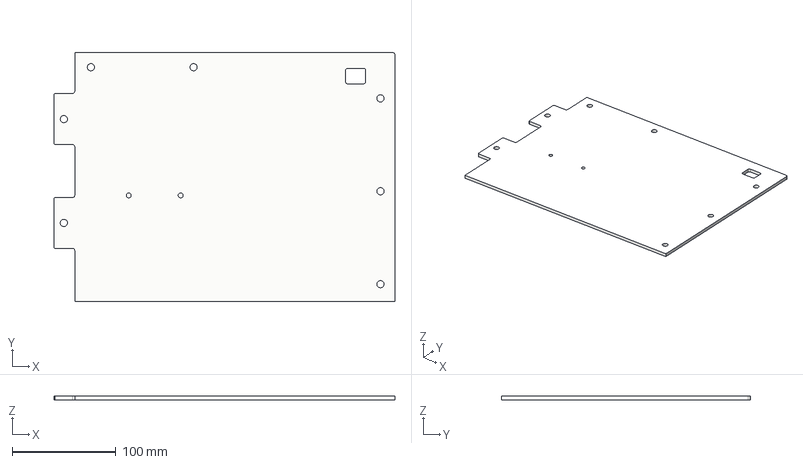
[picture p95: CAD file, 2023-07-25]
cad/panels/STEP/Metric Units (mm)/IDEX/panel_idex_electronics_split_300_top_right.step
328.5 x 239.5 x 4.00 mm
