Rat-Rig/V-core-3/cad/printed_parts/extra/step/spool_holder_guide.step

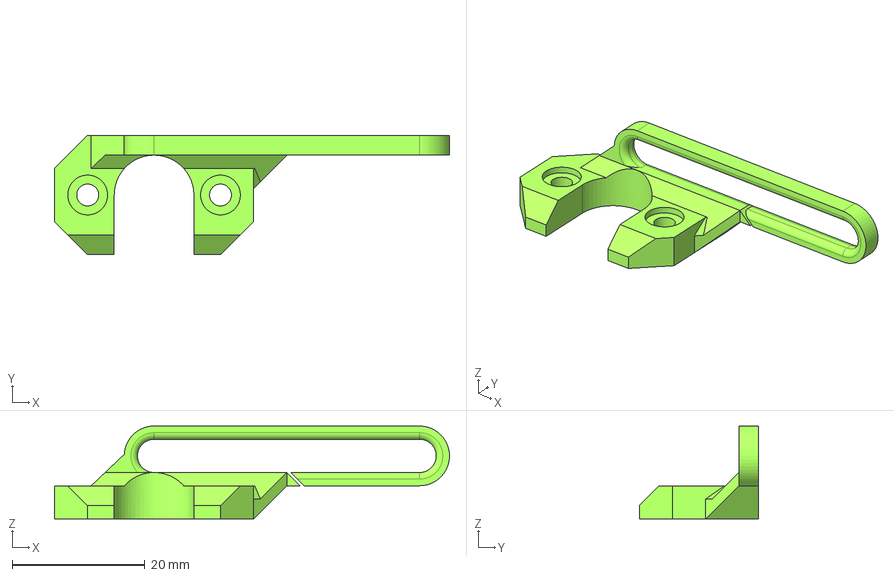
[picture p96: CAD file, 2021-03-19]
cad/printed_parts/extra/step/spool_holder_guide.step
59.5 x 18.0 x 14.0 mm
