Rat-Rig/V-core-3/cad/printed_parts/step/core/enclosure2_bowden_clamp.step

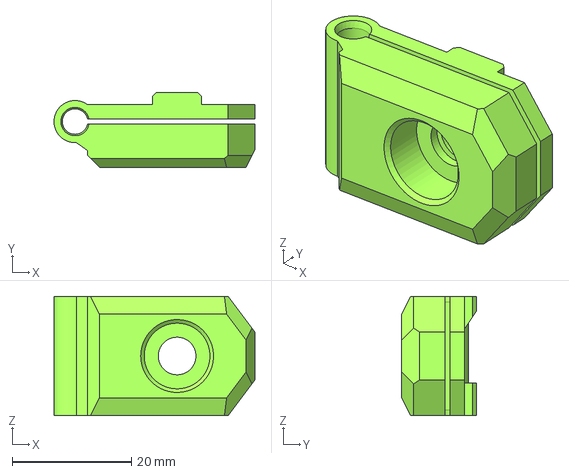
[picture p97: CAD file, 2023-01-12]
cad/printed_parts/step/core/enclosure2_bowden_clamp.step
33.6 x 12.5 x 20.0 mm
