Rat-Rig/V-core-3/cad/printed_parts/step/electronics/electronics_wire_guide_clip.step

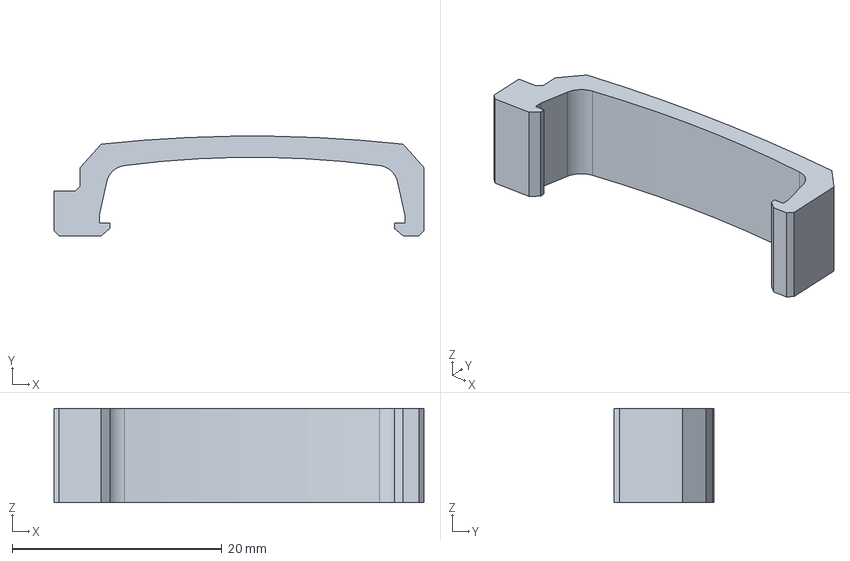
[picture p98: CAD file, 2022-09-23]
cad/printed_parts/step/electronics/electronics_wire_guide_clip.step
35.3 x 9.48 x 9.00 mm
