Rat-Rig/V-core-3/cad/printed_parts/step/enclosure/panel_magnet_holder.step

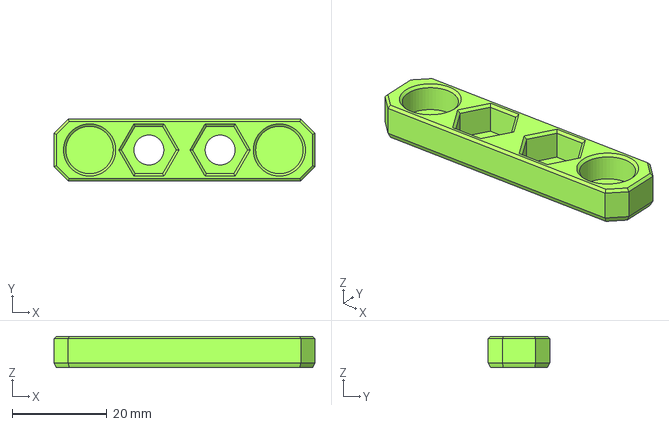
[picture p99: CAD file, 2022-10-13]
cad/printed_parts/step/enclosure/panel_magnet_holder.step
55.0 x 13.0 x 6.60 mm
