Rat-Rig/V-core-3/cad/printed_parts/step/enclosure_optional/enclosure2_spool_holder_4mm.step

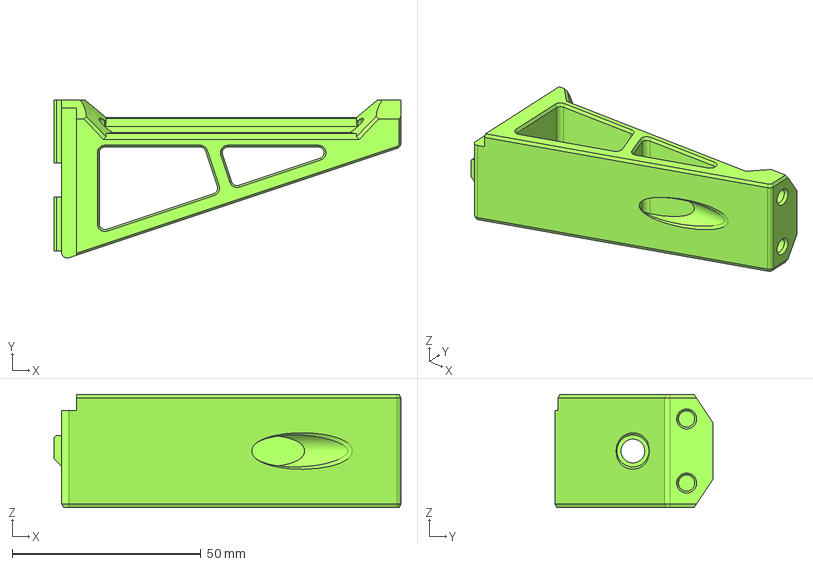
[picture p100: CAD file, 2022-10-10]
cad/printed_parts/step/enclosure_optional/enclosure2_spool_holder_4mm.step
92.0 x 41.9 x 30.0 mm
