Rat-Rig/V-core-3/cad/printed_parts/step/eva3/ratrig_eva3_shroud.step

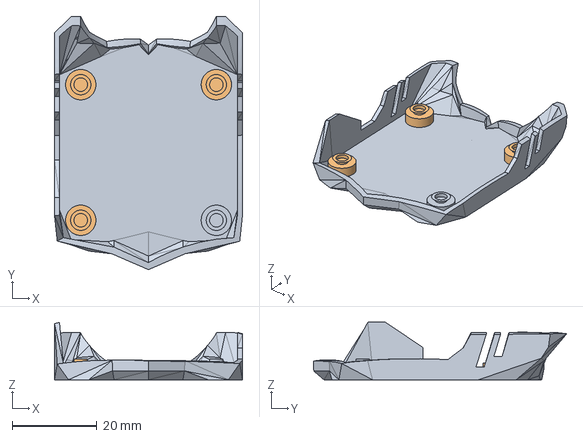
[picture p101: CAD file, 2022-11-29]
cad/printed_parts/step/eva3/ratrig_eva3_shroud.step
44.4 x 59.8 x 13.6 mm
