Rat-Rig/V-core-3/cad/printed_parts/step/spoolholder/3030_spool_holder.step

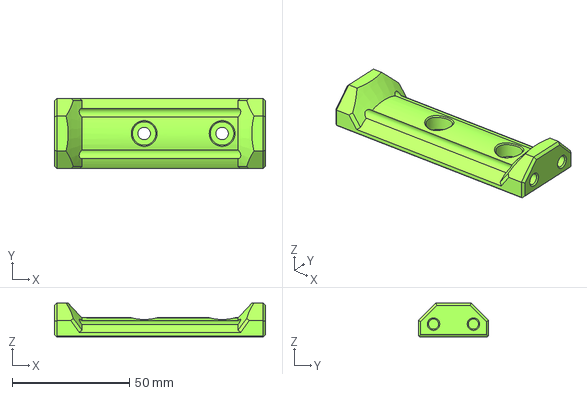
[picture p102: CAD file, 2022-06-30]
cad/printed_parts/step/spoolholder/3030_spool_holder.step
90.0 x 30.0 x 14.5 mm
