Rat-Rig/V-core-3/slicer_profiles/SuperSlicer/ratrig-vcore-bed-500x500.stl

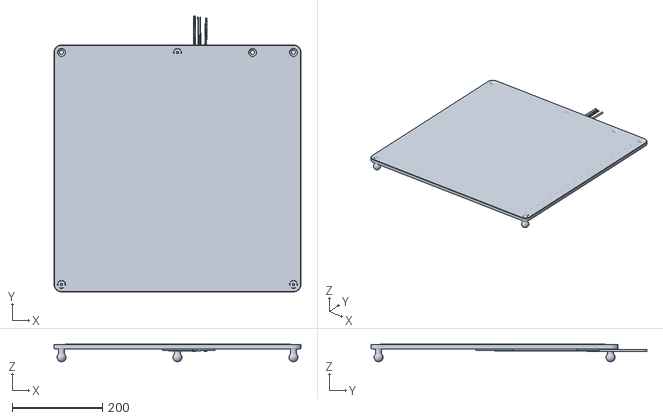
[picture p103: CAD file, 2021-09-15]
slicer_profiles/SuperSlicer/ratrig-vcore-bed-500x500.stl
548.3 x 612.4 x 39.0
