Rat-Rig/V-core-3/cad/panels/DXF/Imperial Units (Inches)/500/panel_electronics_split_500_plain_top_right.dxf

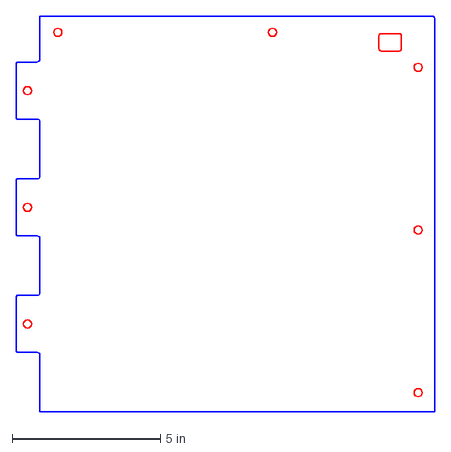
[picture p104: CAD file, 2022-07-04]
cad/panels/DXF/Imperial Units (Inches)/500/panel_electronics_split_500_plain_top_right.dxf
14.1 x 13.4 in
