Rat-Rig/V-core-3/cad/panels/STEP/Imperial Units (Inches)/200/panel_enc2_door_200.step

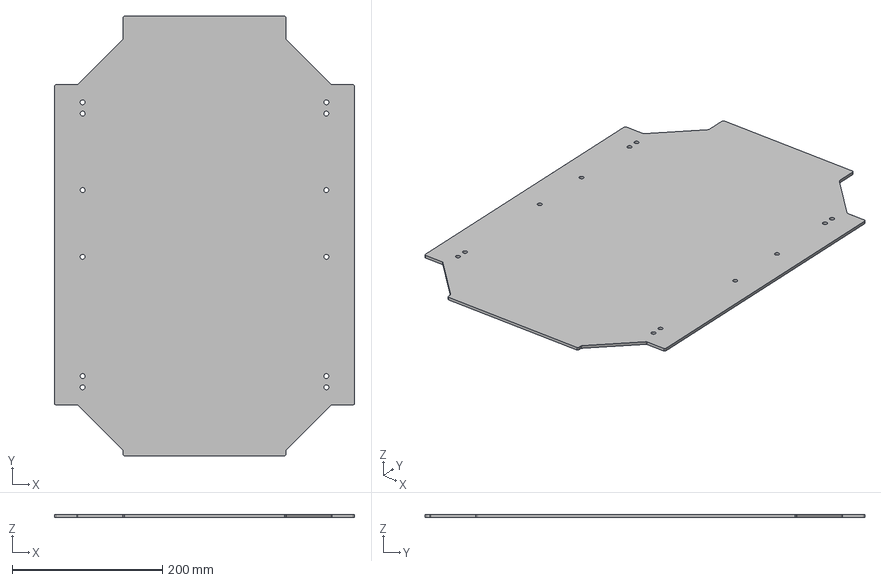
[picture p105: CAD file, 2022-09-23]
cad/panels/STEP/Imperial Units (Inches)/200/panel_enc2_door_200.step
400.0 x 586.5 x 4.00 mm
