Rat-Rig/V-core-3/cad/panels/STEP/Imperial Units (Inches)/300/panel_electronics_300.step

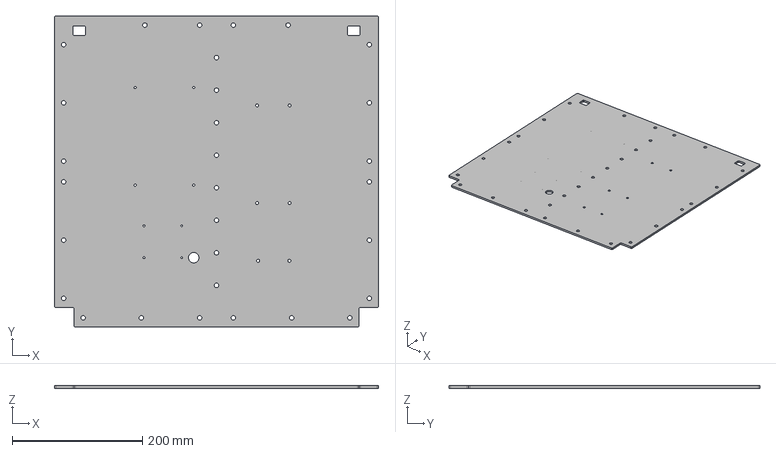
[picture p106: CAD file, 2023-03-22]
cad/panels/STEP/Imperial Units (Inches)/300/panel_electronics_300.step
498.0 x 478.0 x 4.00 mm
