Rat-Rig/V-core-3/cad/panels/STEP/Imperial Units (Inches)/400/panel_electronics_400.step

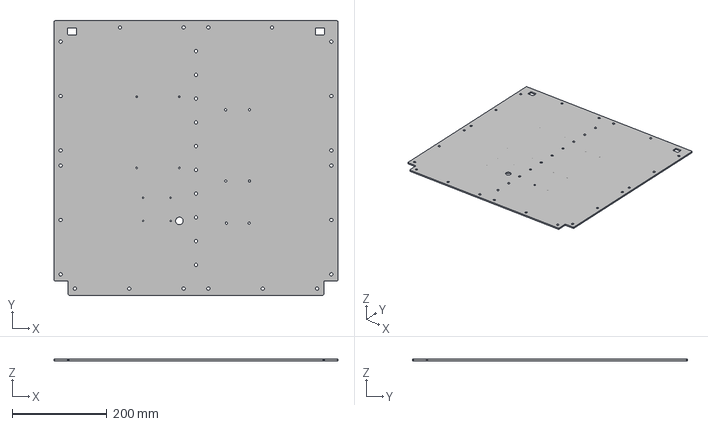
[picture p107: CAD file, 2023-03-22]
cad/panels/STEP/Imperial Units (Inches)/400/panel_electronics_400.step
598.0 x 578.0 x 4.00 mm
