Rat-Rig/V-core-3/cad/panels/STEP/Imperial Units (Inches)/IDEX/panel_idex_electronics_split_500_top_left.step

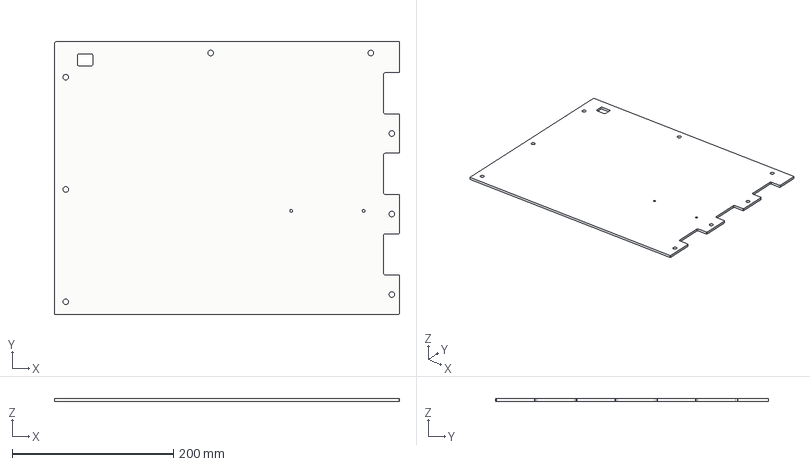
[picture p108: CAD file, 2023-07-25]
cad/panels/STEP/Imperial Units (Inches)/IDEX/panel_idex_electronics_split_500_top_left.step
428.5 x 338.5 x 4.00 mm
