Rat-Rig/V-core-3/cad/printed_parts/step/electronics/electronics_wire_guide.step

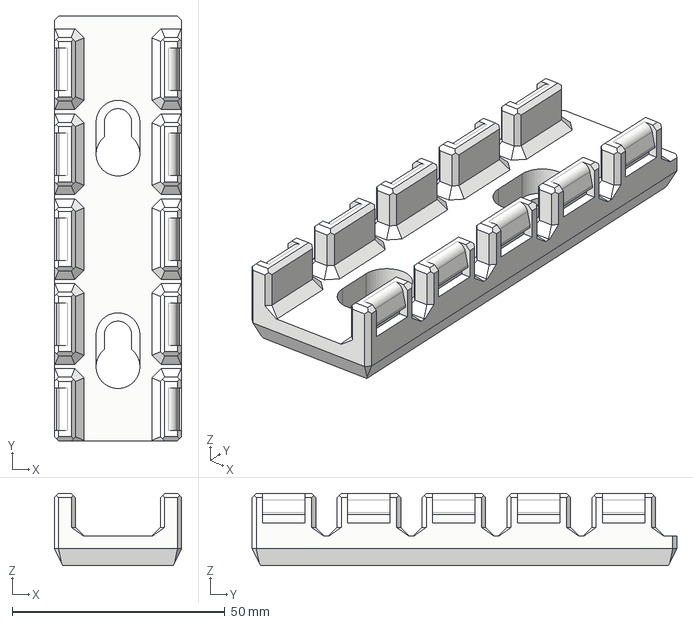
[picture p111: CAD file, 2022-09-23]
cad/printed_parts/step/electronics/electronics_wire_guide.step
30.0 x 100.0 x 17.0 mm
