Rat-Rig/V-core-3/cad/printed_parts/step/enclosure/panel_magnet_mount.step

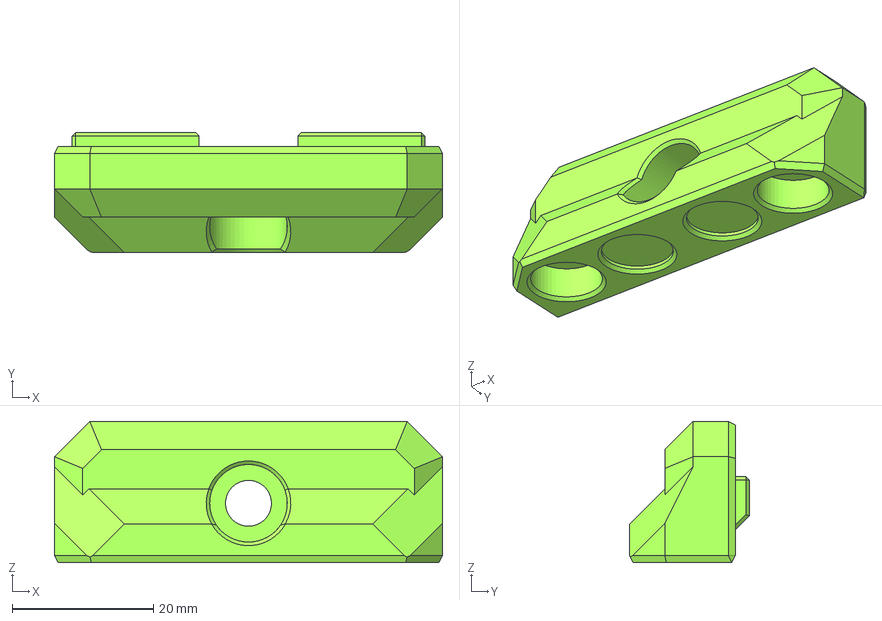
[picture p112: CAD file, 2022-10-13]
cad/printed_parts/step/enclosure/panel_magnet_mount.step
55.0 x 17.0 x 20.0 mm
