Rat-Rig/V-core-3/cad/printed_parts/step/spoolholder/3030_spool_holder_guide.step

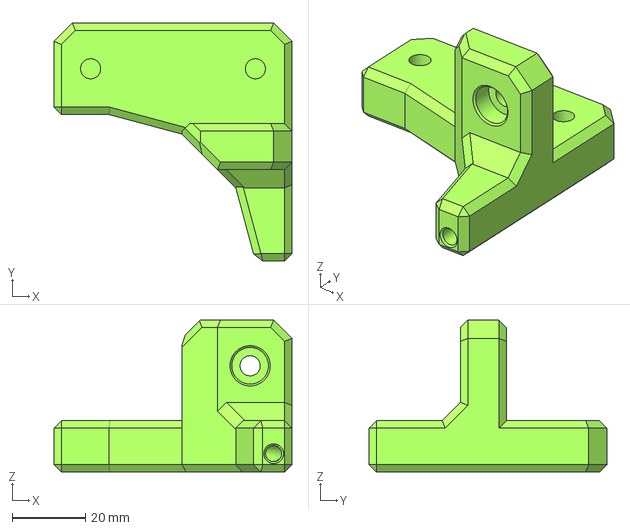
[picture p114: CAD file, 2022-06-30]
cad/printed_parts/step/spoolholder/3030_spool_holder_guide.step
65.0 x 65.0 x 41.5 mm
