Rat-Rig/V-core-3/slicer_profiles/SuperSlicer/ratrig-vcore-bed-400x400.stl

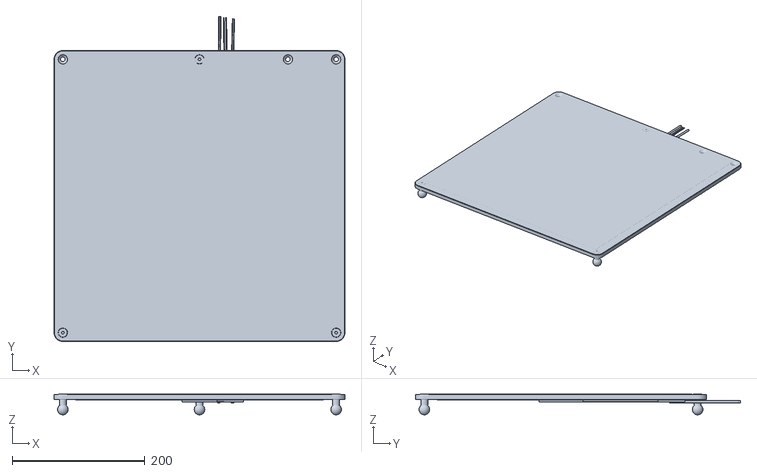
[picture p115: CAD file, 2021-09-15]
slicer_profiles/SuperSlicer/ratrig-vcore-bed-400x400.stl
438.7 x 489.9 x 31.2
