Rat-Rig/V-core-3/cad/panels/STEP/Imperial Units (Inches)/200/panel_enc2_top_200.step

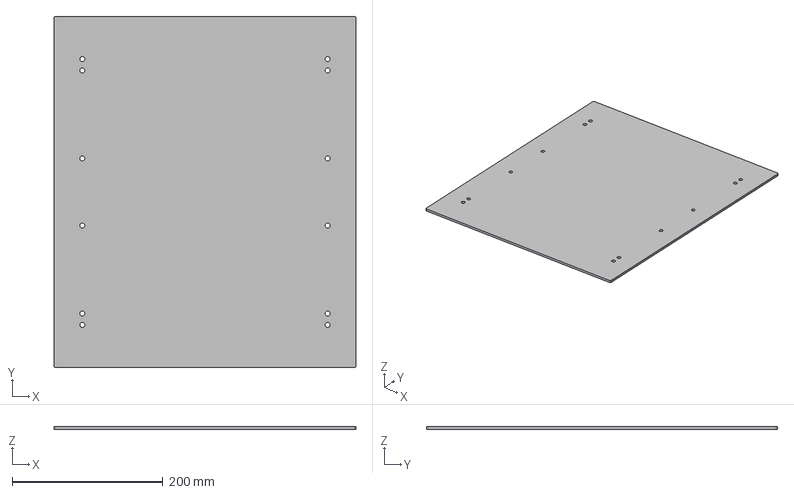
[picture p116: CAD file, 2022-09-23]
cad/panels/STEP/Imperial Units (Inches)/200/panel_enc2_top_200.step
400.0 x 465.0 x 4.00 mm
