Rat-Rig/V-core-3/cad/panels/STEP/Imperial Units (Inches)/IDEX/panel_enc2_idex_base_300.step

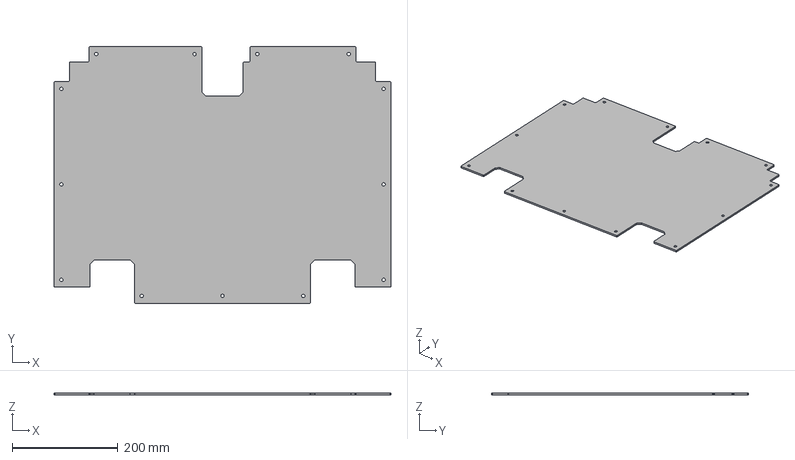
[picture p117: CAD file, 2023-07-25]
cad/panels/STEP/Imperial Units (Inches)/IDEX/panel_enc2_idex_base_300.step
638.0 x 486.0 x 4.00 mm
