Rat-Rig/V-core-3/cad/panels/STEP/Metric Units (mm)/200/panel_enc2_back_200.step

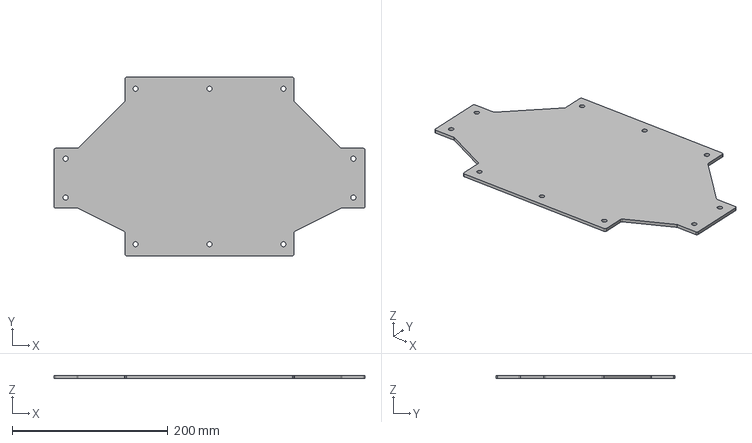
[picture p118: CAD file, 2022-09-23]
cad/panels/STEP/Metric Units (mm)/200/panel_enc2_back_200.step
400.0 x 230.0 x 4.00 mm
