Rat-Rig/V-core-3/cad/panels/STEP/Metric Units (mm)/IDEX/panel_idex_electronics_split_400_top_left.step

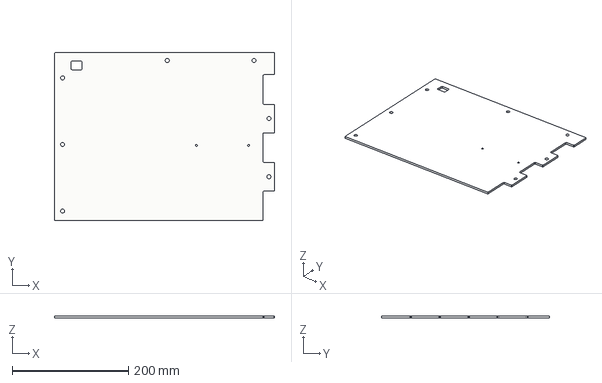
[picture p119: CAD file, 2023-07-25]
cad/panels/STEP/Metric Units (mm)/IDEX/panel_idex_electronics_split_400_top_left.step
378.5 x 289.5 x 4.00 mm
