Rat-Rig/V-core-3/cad/printed_parts/extra/step/spool_holder_3030_arm_v2_rr.step

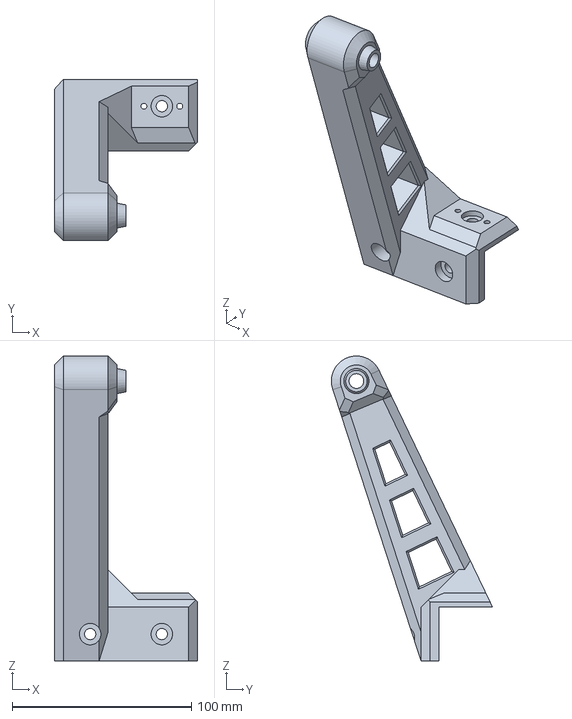
[picture p120: CAD file, 2021-03-19]
cad/printed_parts/extra/step/spool_holder_3030_arm_v2_rr.step
80.0 x 90.0 x 170.2 mm
