Rat-Rig/V-core-3/cad/printed_parts/step/enclosure/xy_motor_cage_top_right_3.1_cutout.step

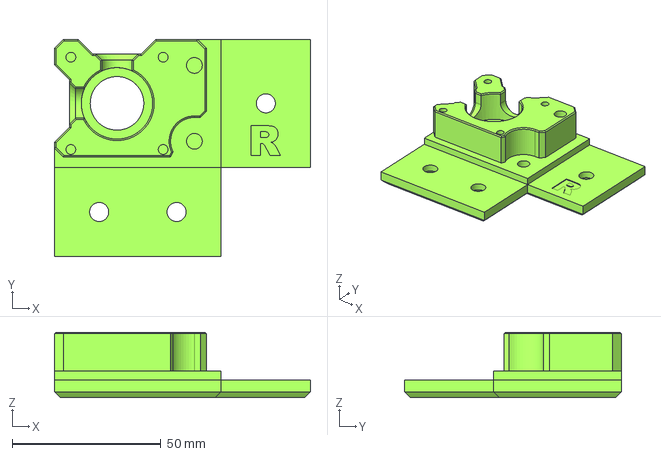
[picture p121: CAD file, 2022-09-23]
cad/printed_parts/step/enclosure/xy_motor_cage_top_right_3.1_cutout.step
86.0 x 73.0 x 22.0 mm
