Rat-Rig/V-core-3/cad/printed_parts/step/eva3/bl_touch_mount.step

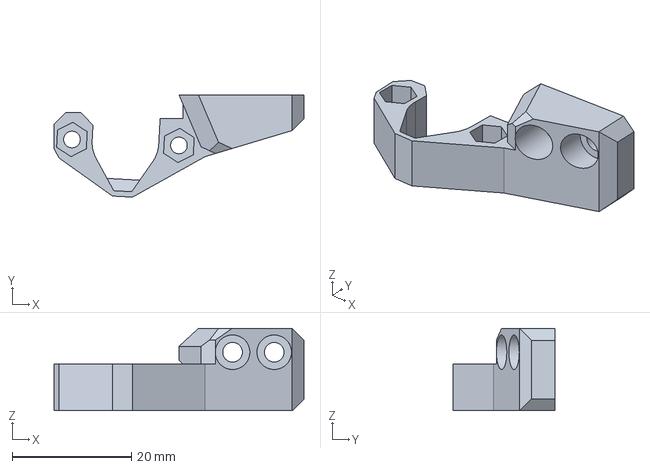
[picture p122: CAD file, 2022-07-06]
cad/printed_parts/step/eva3/bl_touch_mount.step
42.0 x 17.2 x 13.8 mm
