Rat-Rig/V-core-3/slicer_profiles/SuperSlicer/ratrig-vcore-bed-300x300.stl

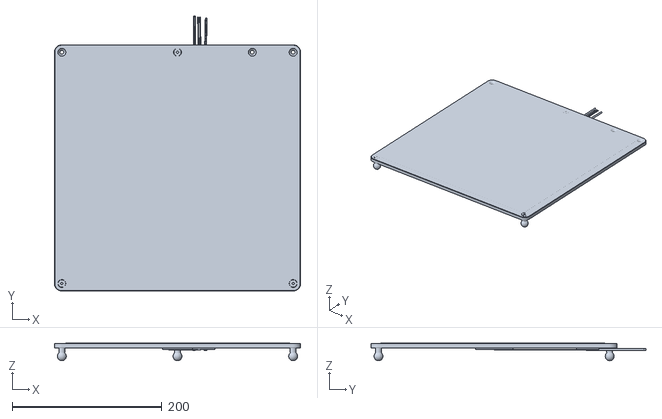
[picture p123: CAD file, 2021-09-15]
slicer_profiles/SuperSlicer/ratrig-vcore-bed-300x300.stl
329.0 x 367.5 x 23.4
