Rat-Rig/V-core-3/cad/panels/STEP/Imperial Units (Inches)/200/panel_enc2_side_split_bottom_200.step

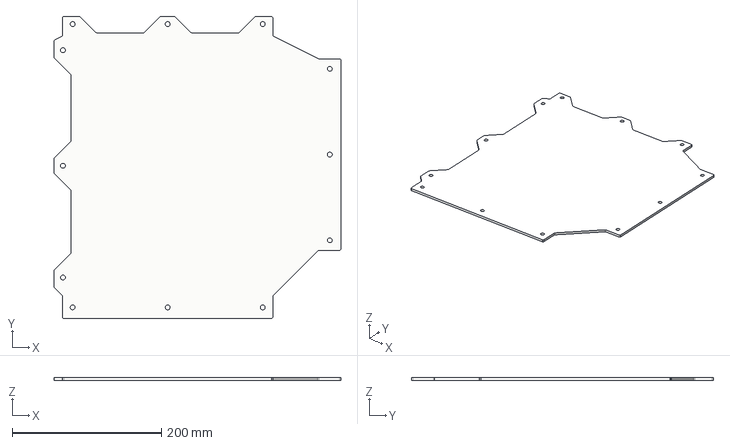
[picture p124: CAD file, 2022-09-23]
cad/panels/STEP/Imperial Units (Inches)/200/panel_enc2_side_split_bottom_200.step
385.0 x 405.2 x 4.00 mm
