Rat-Rig/V-core-3/cad/panels/STEP/Imperial Units (Inches)/IDEX/panel_enc2_idex_door_400.step

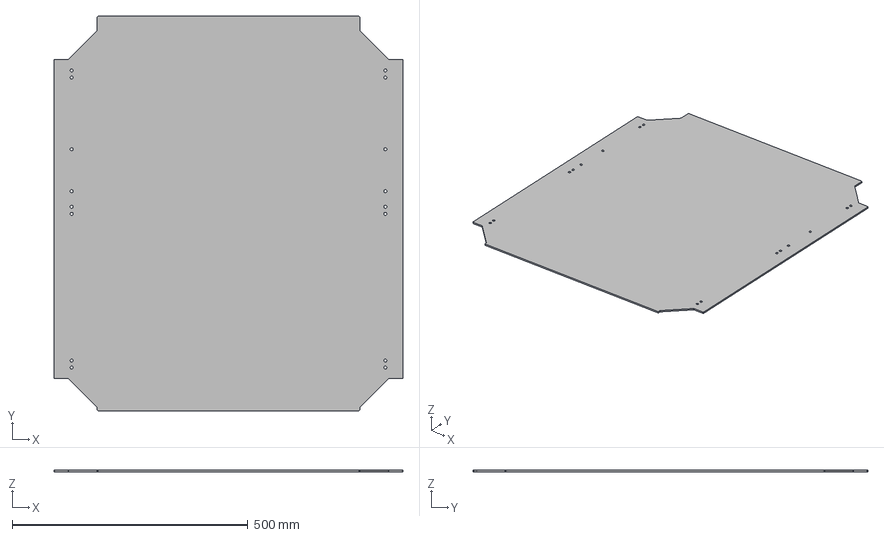
[picture p125: CAD file, 2023-07-25]
cad/panels/STEP/Imperial Units (Inches)/IDEX/panel_enc2_idex_door_400.step
740.0 x 836.5 x 4.00 mm
