Rat-Rig/V-core-3/cad/printed_parts/extra/step/spool_holder_knob.step

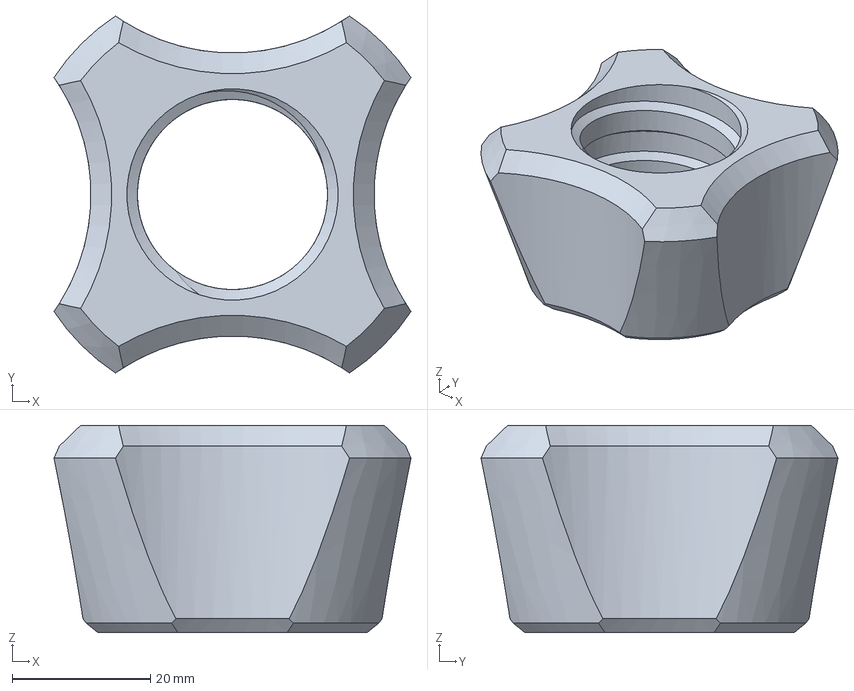
[picture p126: CAD file, 2021-03-19]
cad/printed_parts/extra/step/spool_holder_knob.step
51.7 x 51.7 x 30.0 mm
