Rat-Rig/V-core-3/cad/printed_parts/step/electronics/panel_collar.step

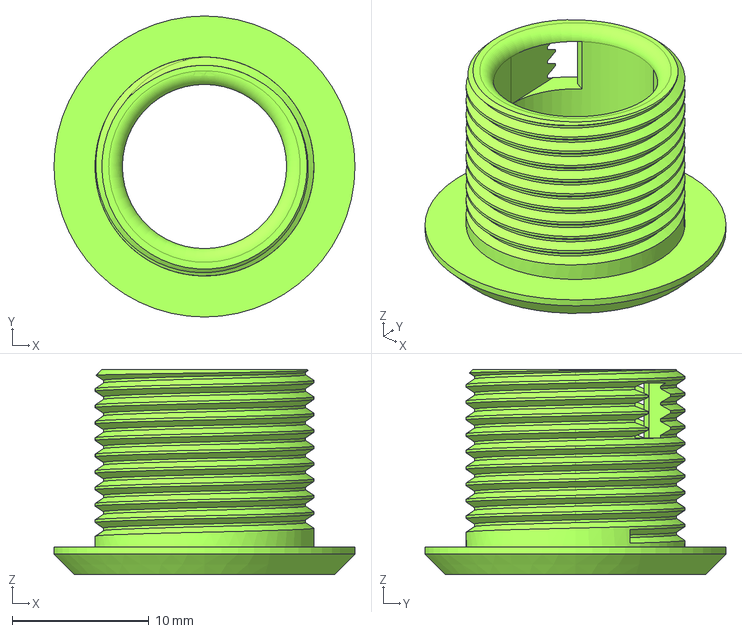
[picture p127: CAD file, 2022-06-30]
cad/printed_parts/step/electronics/panel_collar.step
22.0 x 22.0 x 15.0 mm
