Rat-Rig/V-core-3/cad/printed_parts/step/enclosure/y_min_bumper.step

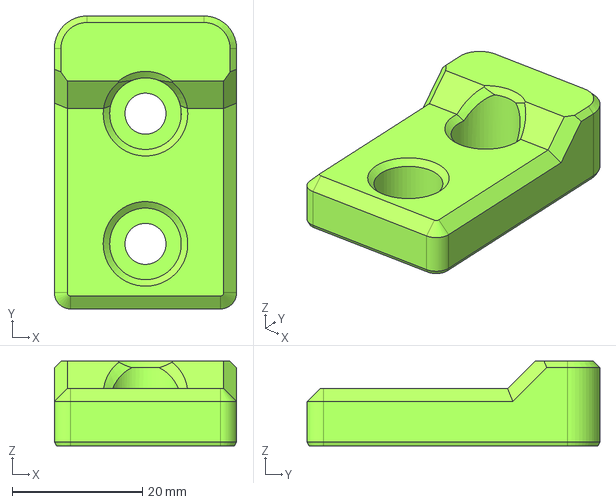
[picture p128: CAD file, 2022-09-23]
cad/printed_parts/step/enclosure/y_min_bumper.step
28.0 x 45.0 x 13.0 mm
