Rat-Rig/V-core-3/cad/printed_parts/step/enclosure_optional/enclosure2_base_panel_filler.step

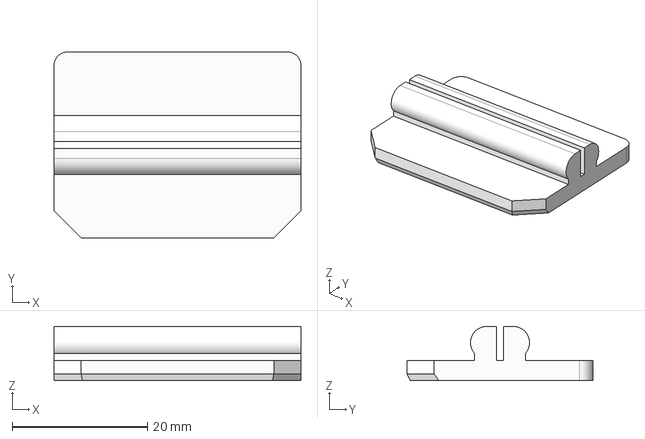
[picture p129: CAD file, 2022-09-26]
cad/printed_parts/step/enclosure_optional/enclosure2_base_panel_filler.step
36.5 x 27.5 x 8.00 mm
