Rat-Rig/V-core-3/cad/printed_parts/step/eva3/bottom_horns.step

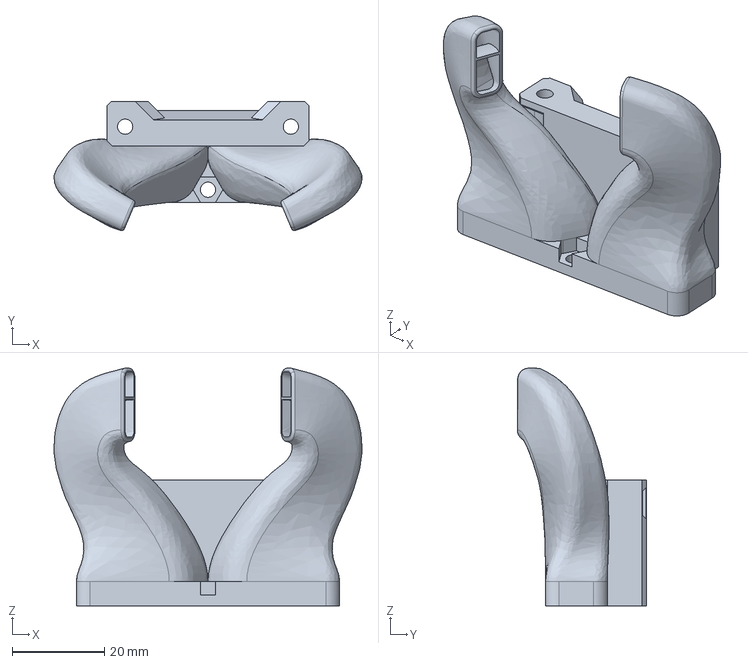
[picture p130: CAD file, 2022-06-30]
cad/printed_parts/step/eva3/bottom_horns.step
66.9 x 28.1 x 51.6 mm
