Rat-Rig/V-core-3/cad/printed_parts/step/core/y_max_endstop_block_3.1.step

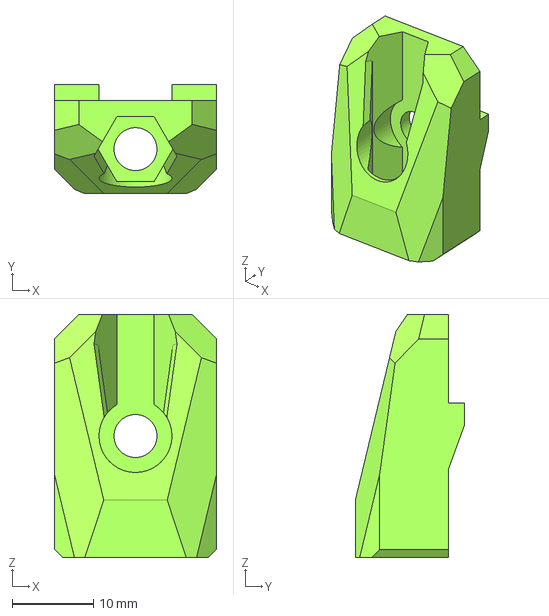
[picture p131: CAD file, 2022-08-01]
cad/printed_parts/step/core/y_max_endstop_block_3.1.step
20.0 x 13.5 x 30.0 mm
