Rat-Rig/V-core-3/cad/printed_parts/step/enclosure/3030_panel_mount_vertical.step

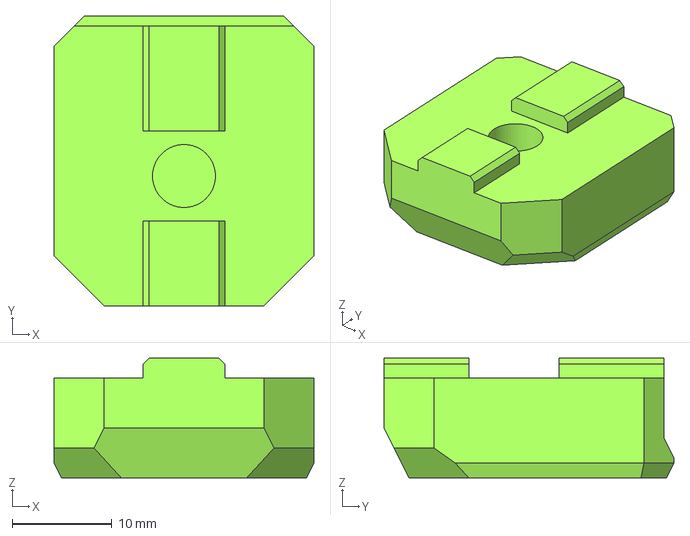
[picture p132: CAD file, 2022-09-23]
cad/printed_parts/step/enclosure/3030_panel_mount_vertical.step
26.0 x 29.0 x 12.0 mm
