Rat-Rig/V-core-3/cad/printed_parts/step/enclosure_optional/enclosure2_corner_trim_4mm.step

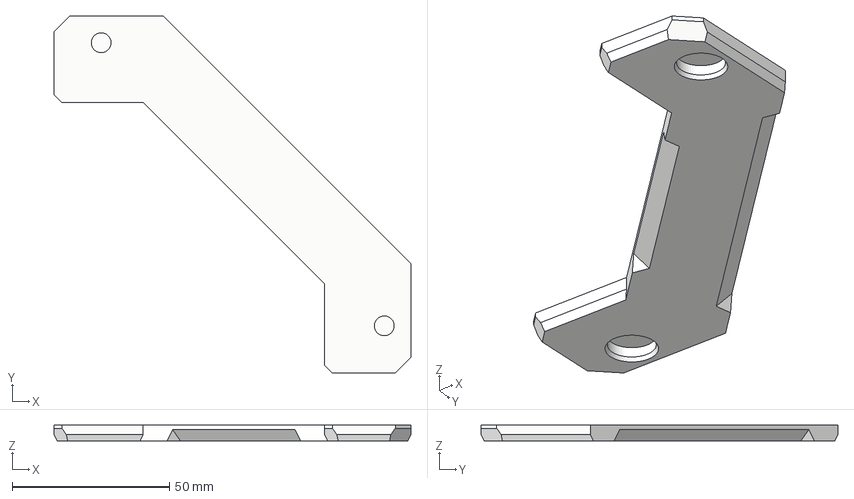
[picture p133: CAD file, 2022-09-23]
cad/printed_parts/step/enclosure_optional/enclosure2_corner_trim_4mm.step
113.5 x 113.5 x 5.00 mm
