Rat-Rig/V-core-3/cad/printed_parts/step/eva3/hotend_mosquito.step

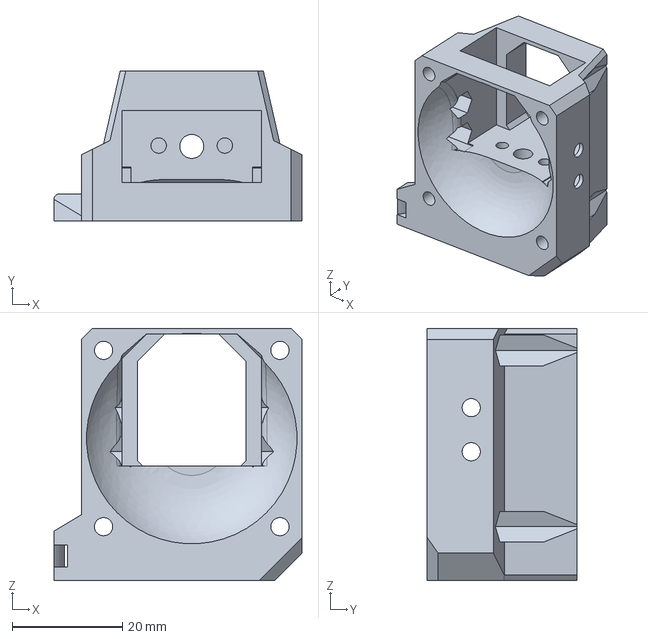
[picture p134: CAD file, 2022-06-30]
cad/printed_parts/step/eva3/hotend_mosquito.step
45.0 x 27.2 x 45.8 mm
