Rat-Rig/V-core-3/cad/panels/STEP/Imperial Units (Inches)/300/panel_enc2_door_300.step

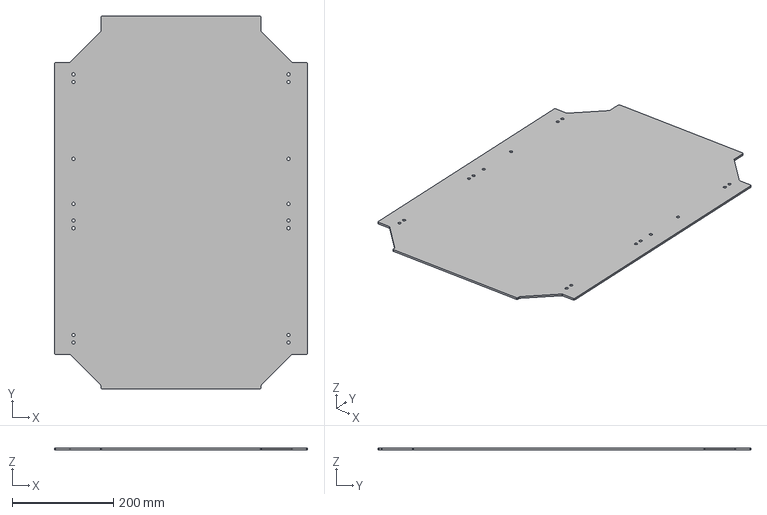
[picture p135: CAD file, 2022-09-26]
cad/panels/STEP/Imperial Units (Inches)/300/panel_enc2_door_300.step
500.0 x 736.5 x 4.00 mm
