Rat-Rig/V-core-3/cad/panels/STEP/Imperial Units (Inches)/400/panel_enc2_door_400.step

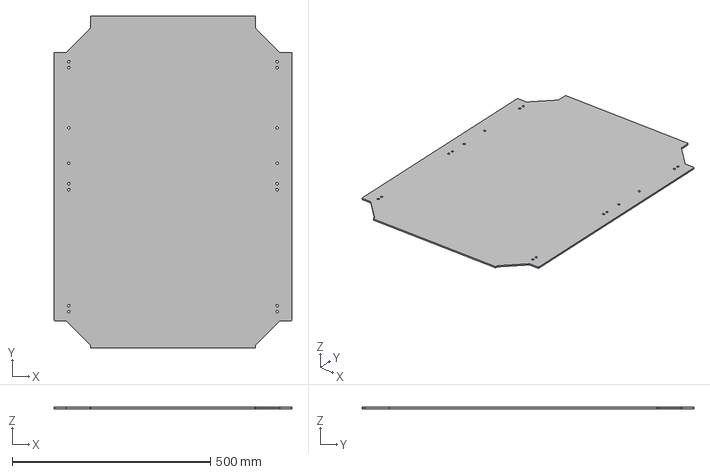
[picture p136: CAD file, 2022-09-26]
cad/panels/STEP/Imperial Units (Inches)/400/panel_enc2_door_400.step
600.0 x 836.5 x 4.00 mm
