Rat-Rig/V-core-3/cad/panels/STEP/Imperial Units (Inches)/500/panel_enc2_door_500.step

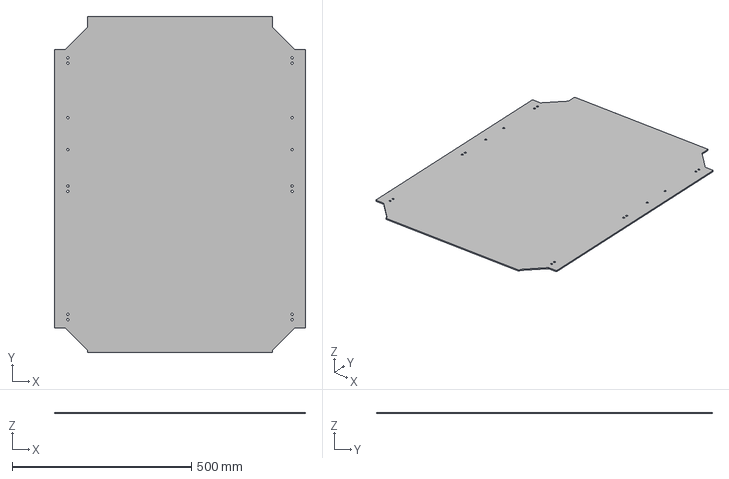
[picture p137: CAD file, 2022-09-26]
cad/panels/STEP/Imperial Units (Inches)/500/panel_enc2_door_500.step
700.0 x 936.5 x 4.00 mm
