Rat-Rig/V-core-3/cad/panels/STEP/Metric Units (mm)/200/panel_enc2_side_split_top_200.step

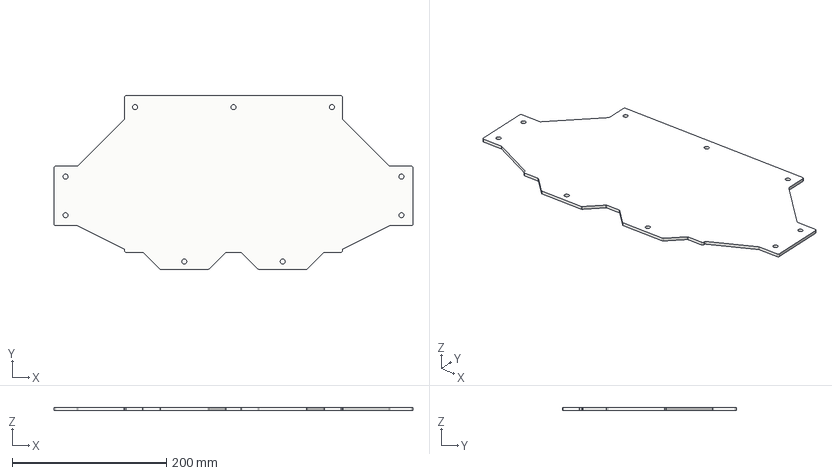
[picture p139: CAD file, 2022-09-23]
cad/panels/STEP/Metric Units (mm)/200/panel_enc2_side_split_top_200.step
465.0 x 225.3 x 4.00 mm
