Rat-Rig/V-core-3/cad/panels/STEP/Metric Units (mm)/IDEX/panel_enc2_idex_back_500.step

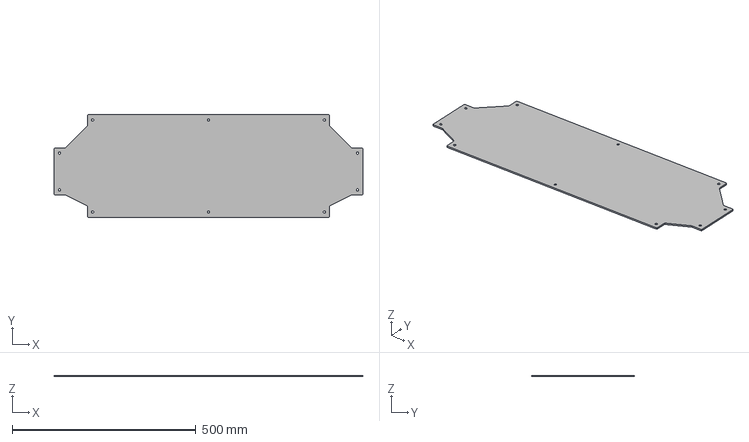
[picture p140: CAD file, 2023-07-25]
cad/panels/STEP/Metric Units (mm)/IDEX/panel_enc2_idex_back_500.step
840.0 x 280.0 x 4.00 mm
