Rat-Rig/V-core-3/cad/printed_parts/step/core/y_max_endstop_slider_3.1.step

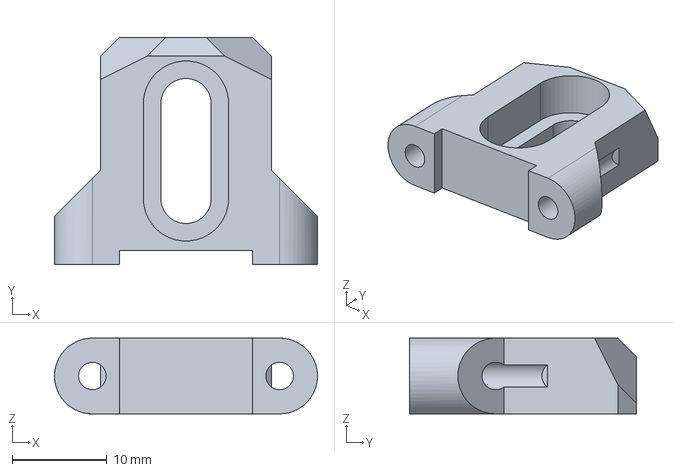
[picture p141: CAD file, 2022-08-01]
cad/printed_parts/step/core/y_max_endstop_slider_3.1.step
27.7 x 24.0 x 8.00 mm
