Rat-Rig/V-core-3/cad/printed_parts/step/enclosure_optional/enclosure2_corner_trim_3mm.step

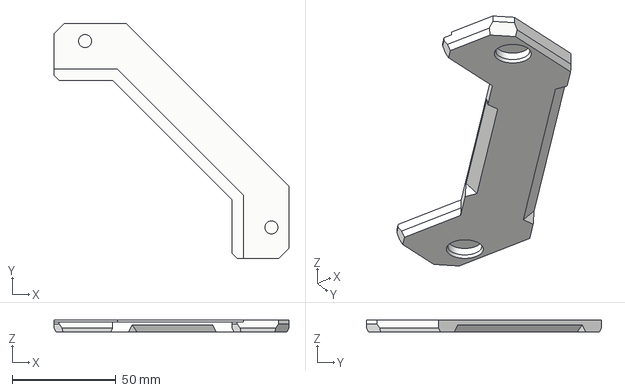
[picture p142: CAD file, 2022-09-23]
cad/printed_parts/step/enclosure_optional/enclosure2_corner_trim_3mm.step
113.5 x 113.5 x 6.00 mm
