Rat-Rig/V-core-3/cad/printed_parts/step/eva3/top_endstop_mgn12c.step

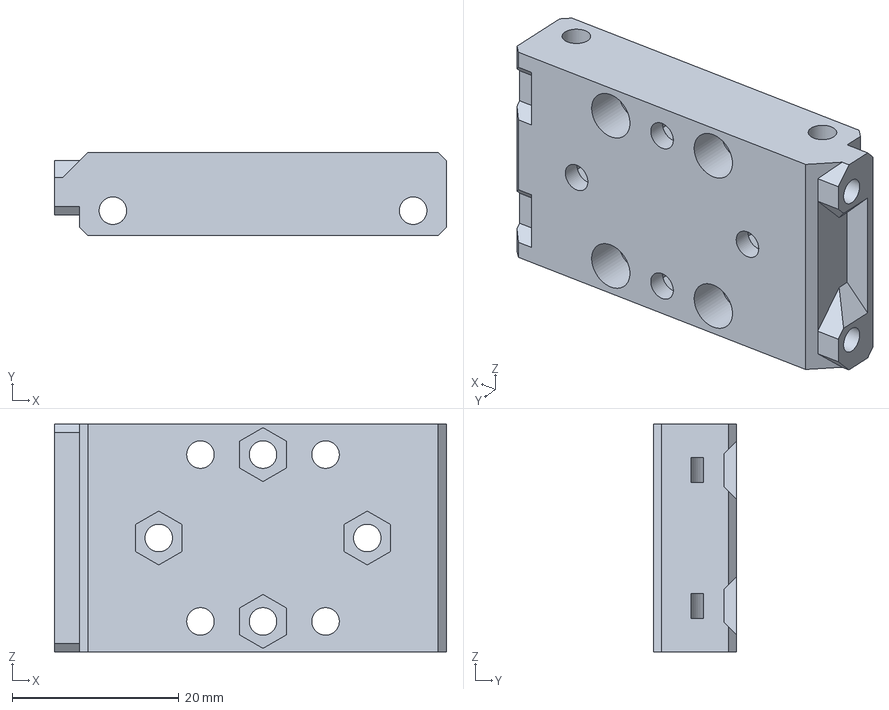
[picture p143: CAD file, 2022-06-30]
cad/printed_parts/step/eva3/top_endstop_mgn12c.step
47.0 x 10.0 x 27.3 mm
