Rat-Rig/V-core-3/cad/panels/STEP/Imperial Units (Inches)/500/panel_enc2_side_split_top_500.step

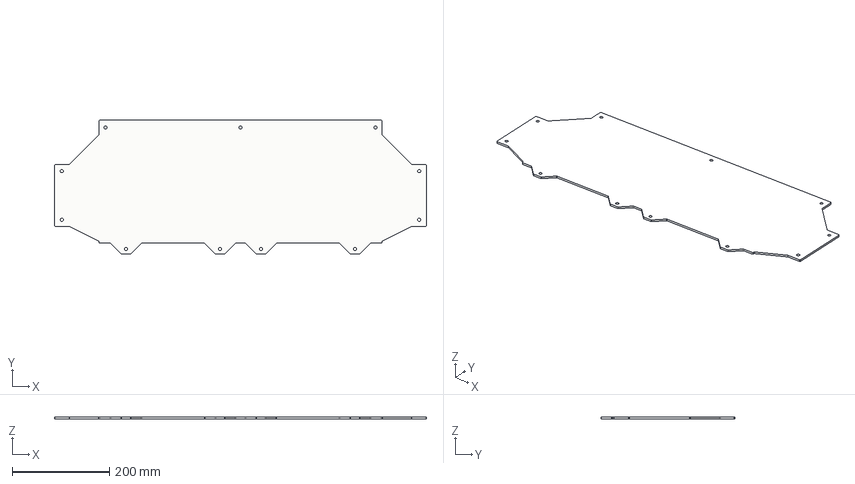
[picture p146: CAD file, 2022-09-23]
cad/panels/STEP/Imperial Units (Inches)/500/panel_enc2_side_split_top_500.step
765.0 x 275.2 x 4.00 mm
