Rat-Rig/V-core-3/cad/panels/STEP/Metric Units (mm)/400/panel_enc2_door_split_top_400.step

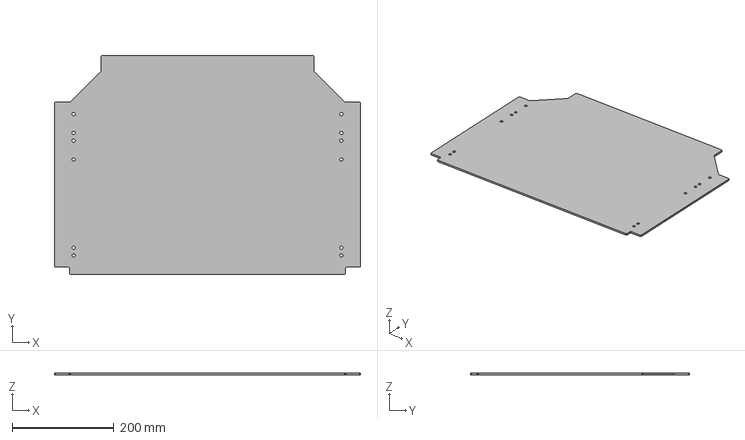
[picture p148: CAD file, 2022-09-23]
cad/panels/STEP/Metric Units (mm)/400/panel_enc2_door_split_top_400.step
600.0 x 429.5 x 4.00 mm
