Rat-Rig/V-core-3/cad/printed_parts/step/core/xy_joiner_right_3.1.step

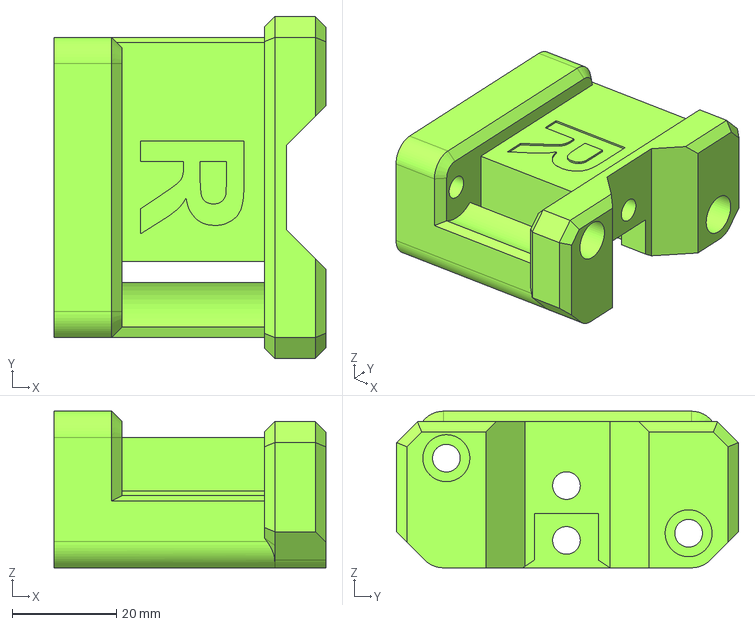
[picture p149: CAD file, 2022-07-05]
cad/printed_parts/step/core/xy_joiner_right_3.1.step
52.0 x 65.5 x 30.0 mm
