Rat-Rig/V-core-3/cad/printed_parts/step/enclosure/3030_panel_mount_horizontal.step

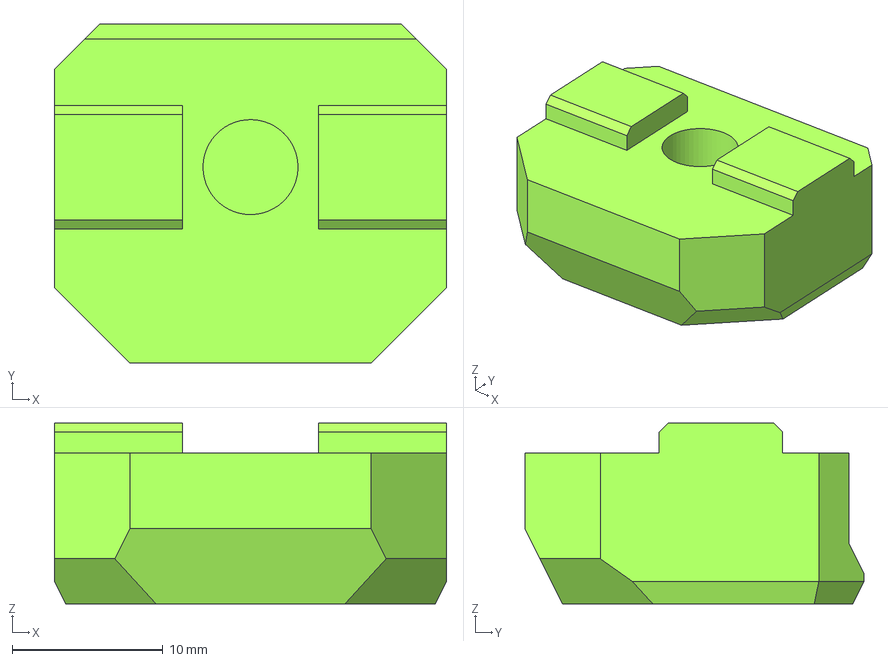
[picture p150: CAD file, 2022-09-23]
cad/printed_parts/step/enclosure/3030_panel_mount_horizontal.step
26.0 x 22.5 x 12.0 mm
