Rat-Rig/V-core-3/cad/printed_parts/step/enclosure_optional/enclosure2_t-plate_half-trim_B_3mm.step

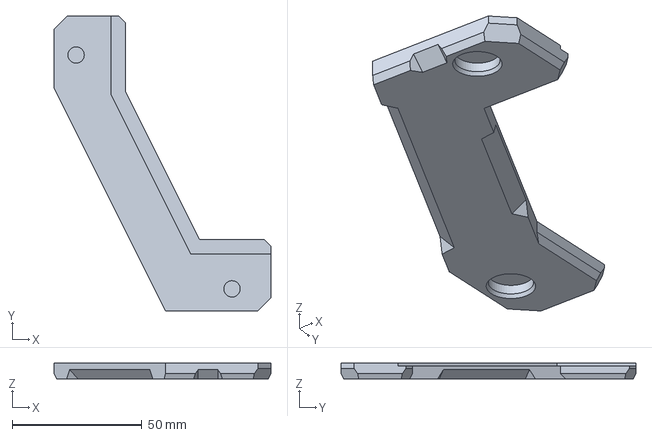
[picture p151: CAD file, 2022-09-23]
cad/printed_parts/step/enclosure_optional/enclosure2_t-plate_half-trim_B_3mm.step
83.5 x 113.5 x 6.00 mm
