Rat-Rig/V-core-3/cad/printed_parts/step/eva3/back_core_xy.step

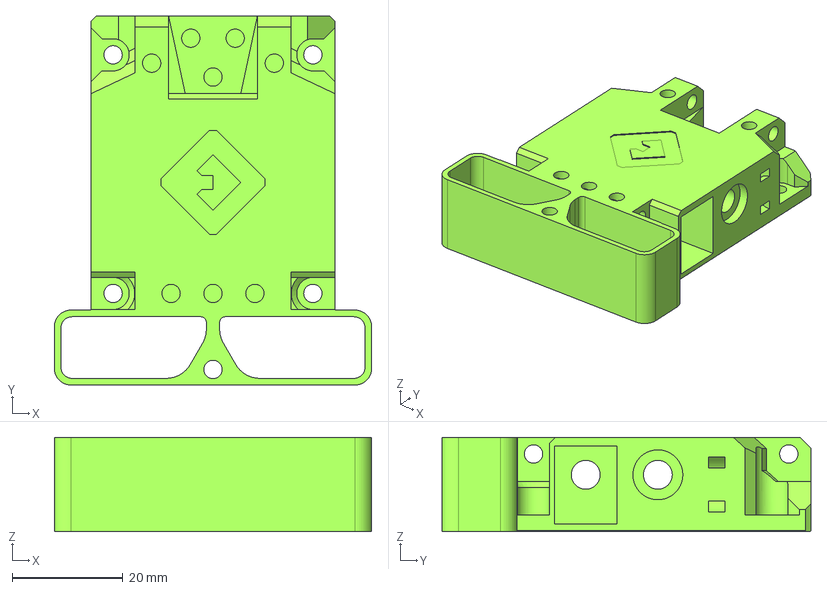
[picture p152: CAD file, 2022-06-30]
cad/printed_parts/step/eva3/back_core_xy.step
57.2 x 66.5 x 17.0 mm
