Rat-Rig/V-core-3/cad/panels/STEP/Imperial Units (Inches)/200/panel_base_200_3.1.step

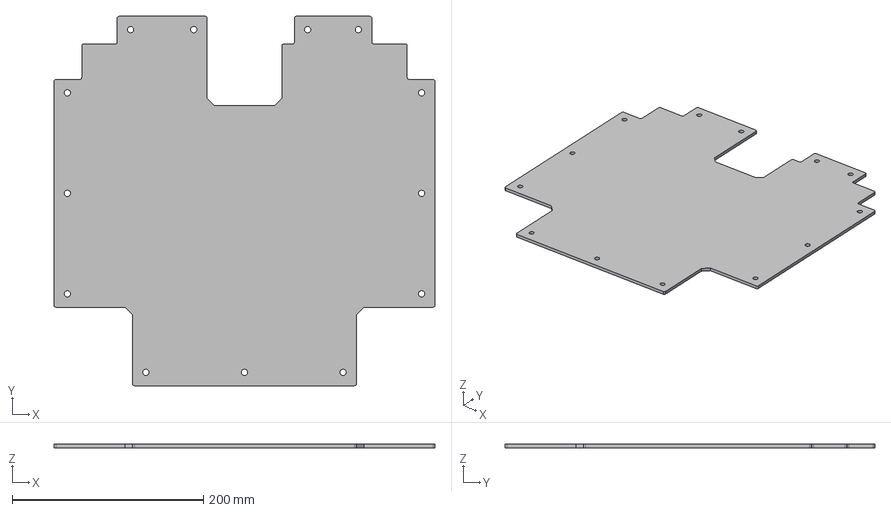
[picture p153: CAD file, 2022-09-23]
cad/panels/STEP/Imperial Units (Inches)/200/panel_base_200_3.1.step
398.0 x 386.0 x 4.00 mm
