Rat-Rig/V-core-3/cad/panels/STEP/Imperial Units (Inches)/300/panel_enc2_side_split_bottom_300.step

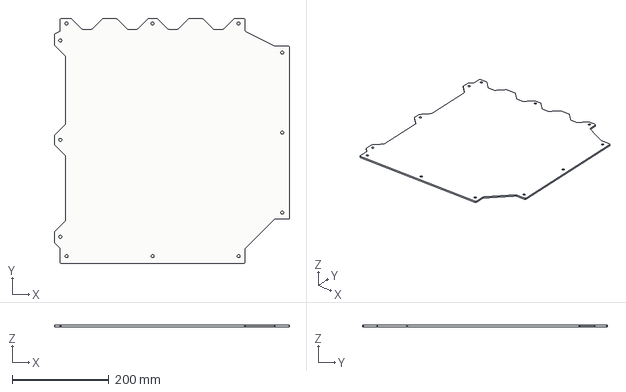
[picture p154: CAD file, 2022-09-23]
cad/panels/STEP/Imperial Units (Inches)/300/panel_enc2_side_split_bottom_300.step
485.0 x 505.3 x 4.00 mm
