Rat-Rig/V-core-3/cad/panels/STEP/Imperial Units (Inches)/400/panel_enc2_back_400.step

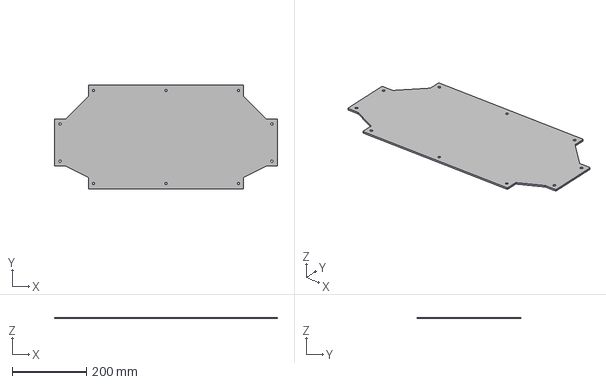
[picture p155: CAD file, 2022-09-23]
cad/panels/STEP/Imperial Units (Inches)/400/panel_enc2_back_400.step
600.0 x 280.0 x 4.00 mm
