Rat-Rig/V-core-3/cad/panels/STEP/Imperial Units (Inches)/500/panel_enc2_door_split_top_500.step

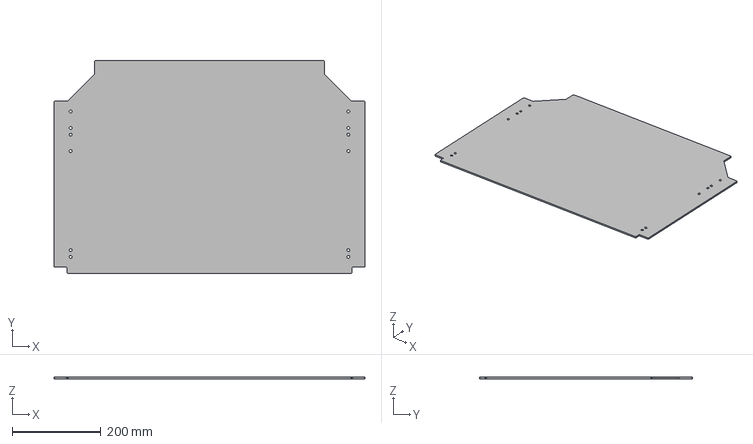
[picture p156: CAD file, 2022-09-23]
cad/panels/STEP/Imperial Units (Inches)/500/panel_enc2_door_split_top_500.step
700.0 x 479.5 x 4.00 mm
