Rat-Rig/V-core-3/cad/panels/STEP/Imperial Units (Inches)/IDEX/panel_enc2_idex_top_500.step

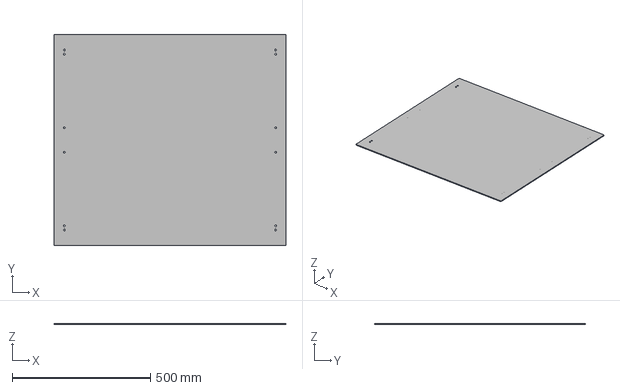
[picture p157: CAD file, 2023-07-25]
cad/panels/STEP/Imperial Units (Inches)/IDEX/panel_enc2_idex_top_500.step
840.0 x 765.0 x 4.00 mm
