Rat-Rig/V-core-3/cad/panels/STEP/Metric Units (mm)/400/panel_enc2_side_split_bottom_400.step

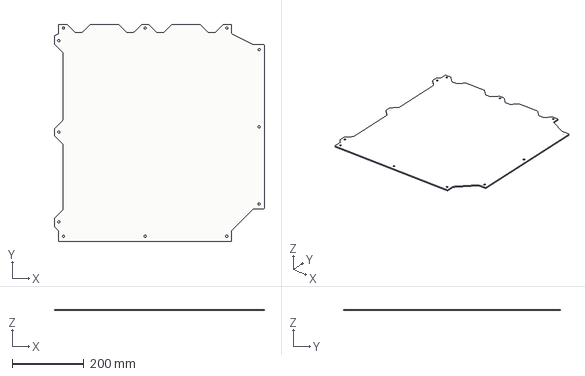
[picture p159: CAD file, 2022-09-23]
cad/panels/STEP/Metric Units (mm)/400/panel_enc2_side_split_bottom_400.step
585.0 x 605.3 x 4.00 mm
