Rat-Rig/V-core-3/cad/panels/STEP/Metric Units (mm)/500/panel_enc2_back_500.step

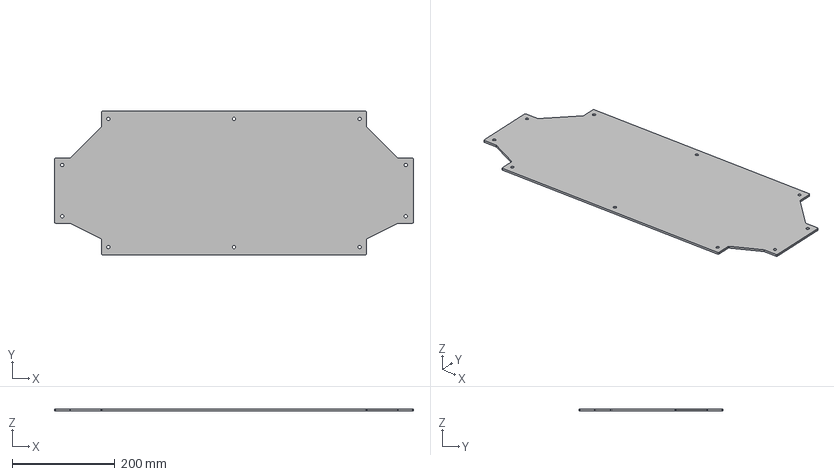
[picture p160: CAD file, 2022-09-23]
cad/panels/STEP/Metric Units (mm)/500/panel_enc2_back_500.step
700.0 x 280.0 x 4.00 mm
