Rat-Rig/V-core-3/cad/panels/STEP/Metric Units (mm)/IDEX/panel_enc2_idex_top_400.step

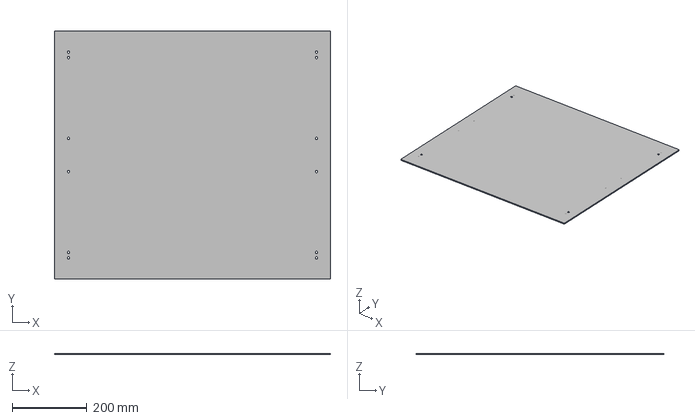
[picture p161: CAD file, 2023-07-25]
cad/panels/STEP/Metric Units (mm)/IDEX/panel_enc2_idex_top_400.step
740.0 x 665.0 x 4.00 mm
