Rat-Rig/V-core-3/cad/printed_parts/step/eva3/hotend_rapido.step

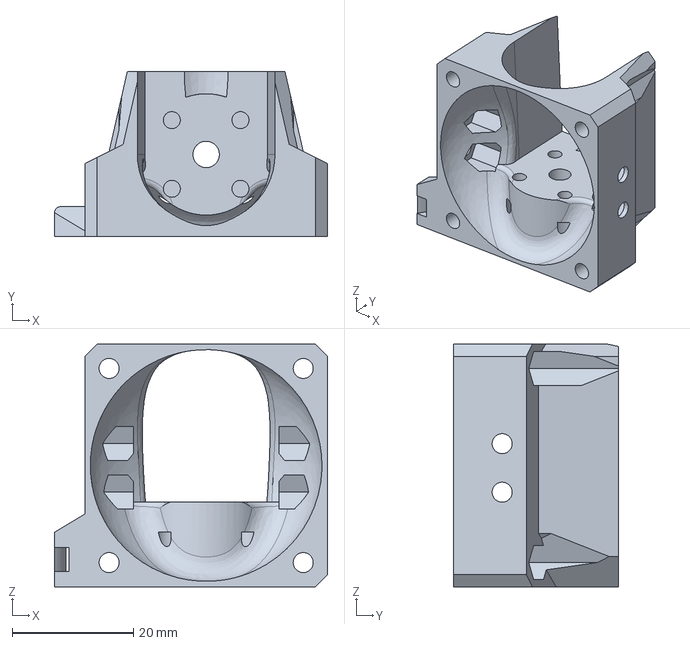
[picture p162: CAD file, 2022-06-30]
cad/printed_parts/step/eva3/hotend_rapido.step
45.0 x 27.2 x 40.0 mm
