Rat-Rig/V-core-3/cad/panels/STEP/Imperial Units (Inches)/300/panel_enc2_side_300.step

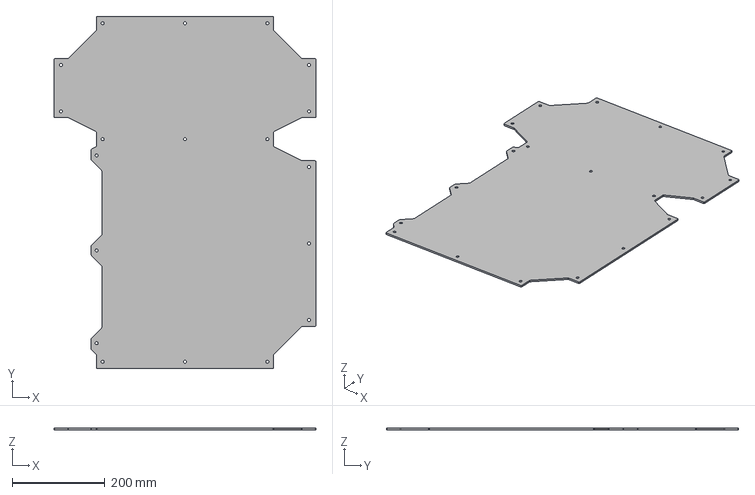
[picture p163: CAD file, 2022-09-23]
cad/panels/STEP/Imperial Units (Inches)/300/panel_enc2_side_300.step
565.0 x 760.0 x 4.00 mm
