Rat-Rig/V-core-3/cad/panels/STEP/Metric Units (mm)/300/panel_enc2_back_300.step

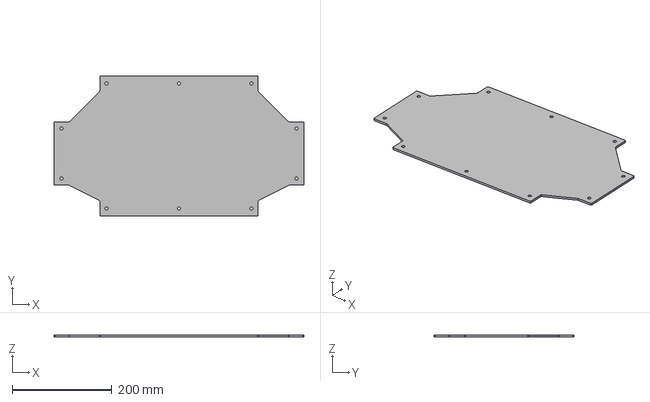
[picture p165: CAD file, 2022-09-23]
cad/panels/STEP/Metric Units (mm)/300/panel_enc2_back_300.step
500.0 x 280.0 x 4.00 mm
