Rat-Rig/V-core-3/cad/panels/STEP/Metric Units (mm)/400/panel_enc2_side_400.step

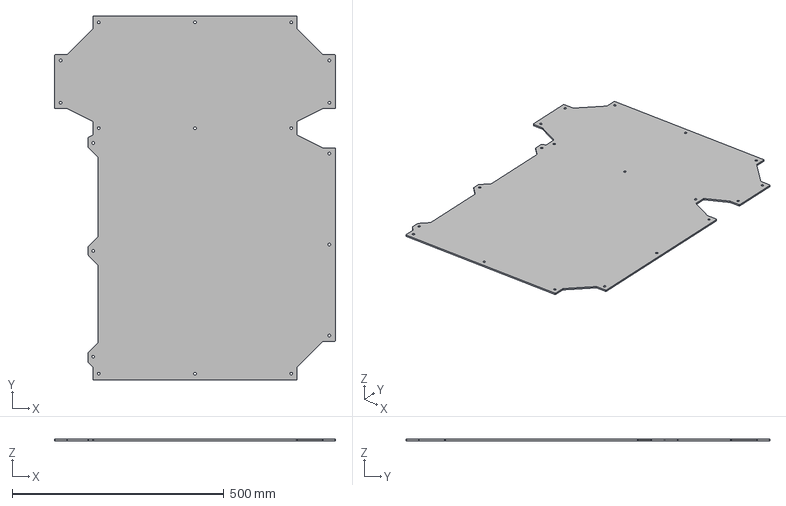
[picture p166: CAD file, 2022-09-23]
cad/panels/STEP/Metric Units (mm)/400/panel_enc2_side_400.step
665.0 x 860.0 x 4.00 mm
