Rat-Rig/V-core-3/cad/panels/STEP/Metric Units (mm)/500/panel_enc2_side_500.step

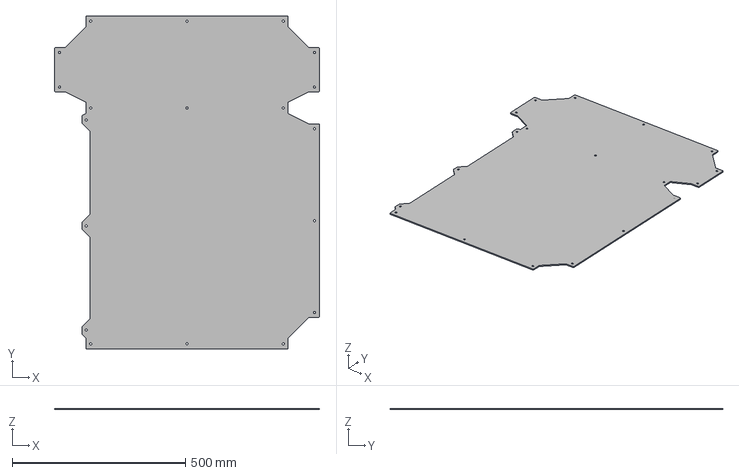
[picture p167: CAD file, 2022-09-23]
cad/panels/STEP/Metric Units (mm)/500/panel_enc2_side_500.step
765.0 x 960.0 x 4.00 mm
