Rat-Rig/V-core-3/cad/panels/STEP/Metric Units (mm)/IDEX/panel_enc2_idex_top_300.step

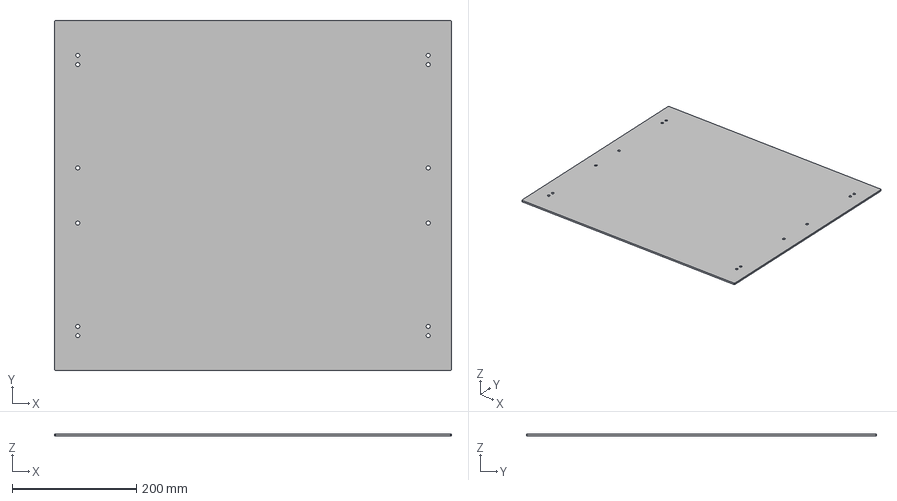
[picture p168: CAD file, 2023-07-25]
cad/panels/STEP/Metric Units (mm)/IDEX/panel_enc2_idex_top_300.step
640.0 x 565.0 x 4.00 mm
