Rat-Rig/V-core-3/cad/printed_parts/step/core/MGN12-3030-Centering-Tool-V1.0.step

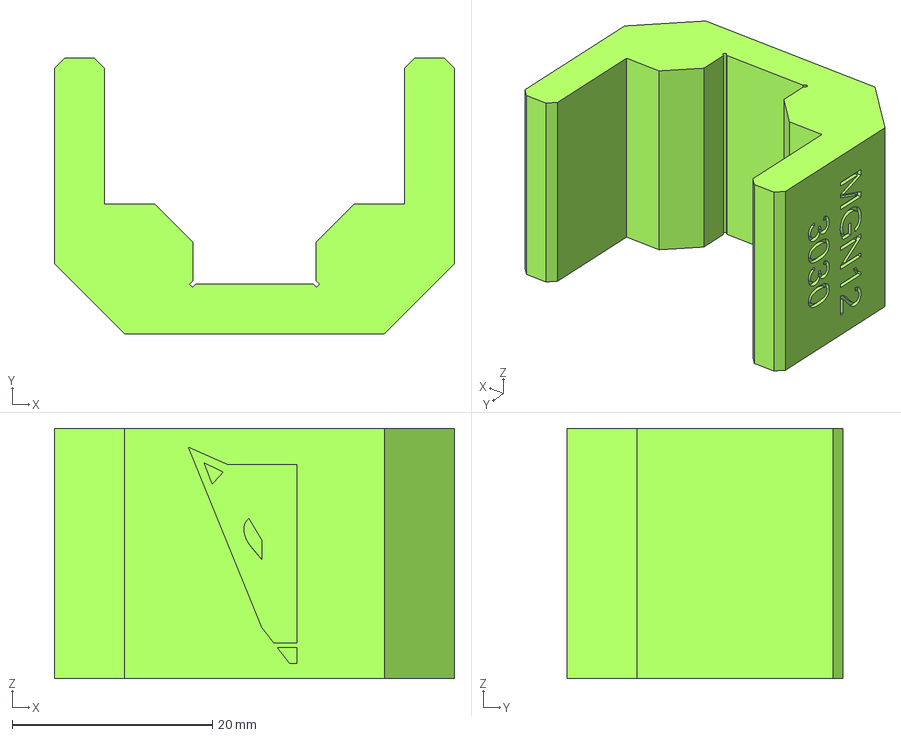
[picture p169: CAD file, 2022-06-30]
cad/printed_parts/step/core/MGN12-3030-Centering-Tool-V1.0.step
40.0 x 27.6 x 25.0 mm
