Rat-Rig/V-core-3/cad/printed_parts/step/enclosure/shelf_left_300_3.1.step

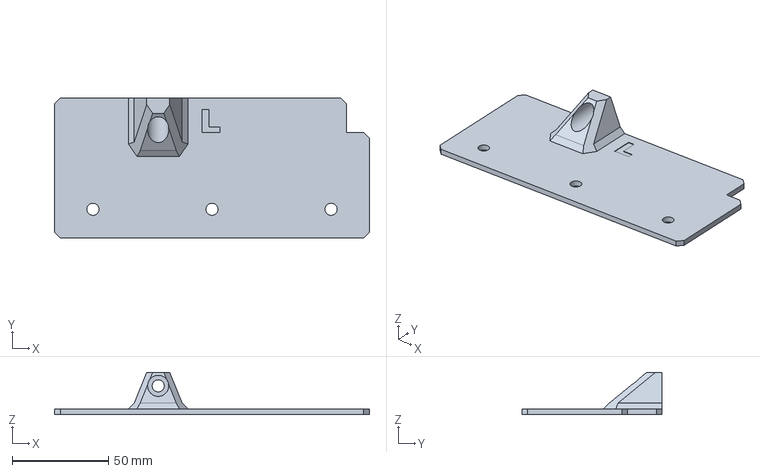
[picture p170: CAD file, 2022-06-30]
cad/printed_parts/step/enclosure/shelf_left_300_3.1.step
164.0 x 73.0 x 22.0 mm
