Rat-Rig/V-core-3/cad/printed_parts/step/enclosure_optional/enclosure2_t-plate_half-trim_A_4mm.step

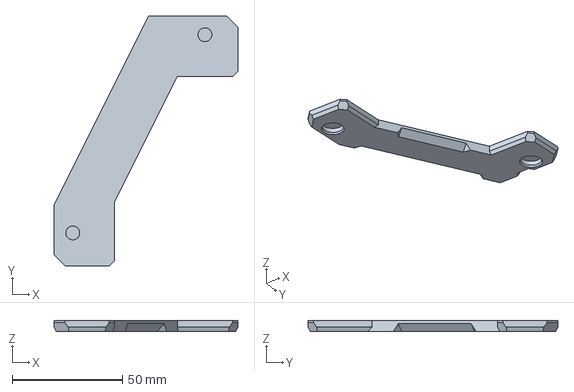
[picture p171: CAD file, 2022-09-23]
cad/printed_parts/step/enclosure_optional/enclosure2_t-plate_half-trim_A_4mm.step
83.5 x 113.5 x 5.00 mm
