Rat-Rig/V-core-3/cad/printed_parts/step/eva3/bottom_horns_volcano.step

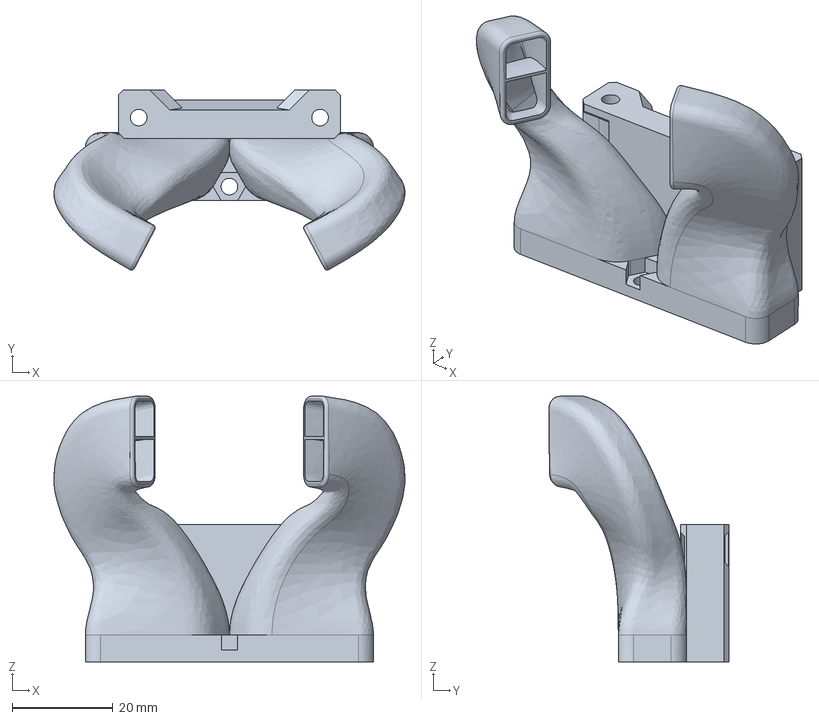
[picture p172: CAD file, 2022-06-30]
cad/printed_parts/step/eva3/bottom_horns_volcano.step
69.7 x 35.8 x 52.7 mm
