Rat-Rig/V-core-3/cad/panels/STEP/Imperial Units (Inches)/400/panel_enc2_side_split_top_400.step

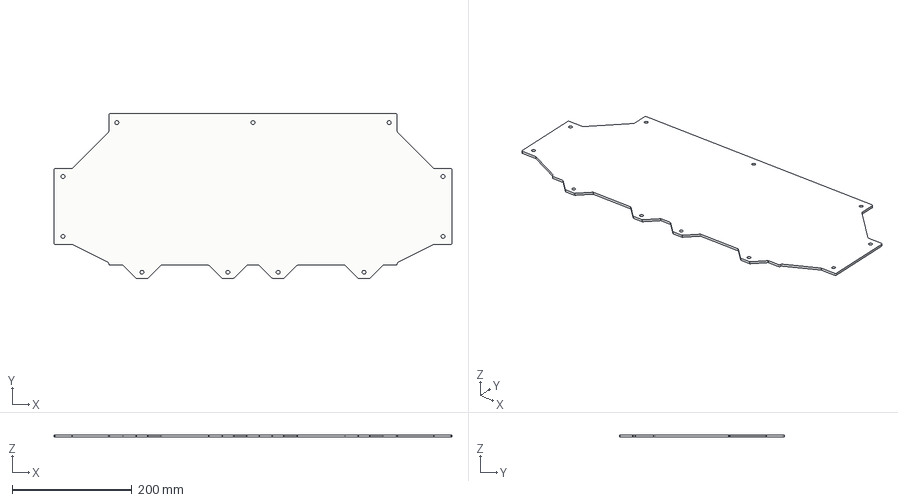
[picture p173: CAD file, 2022-09-23]
cad/panels/STEP/Imperial Units (Inches)/400/panel_enc2_side_split_top_400.step
665.0 x 275.2 x 4.00 mm
