Rat-Rig/V-core-3/cad/panels/STEP/Imperial Units (Inches)/500/panel_enc2_side_split_bottom_500.step

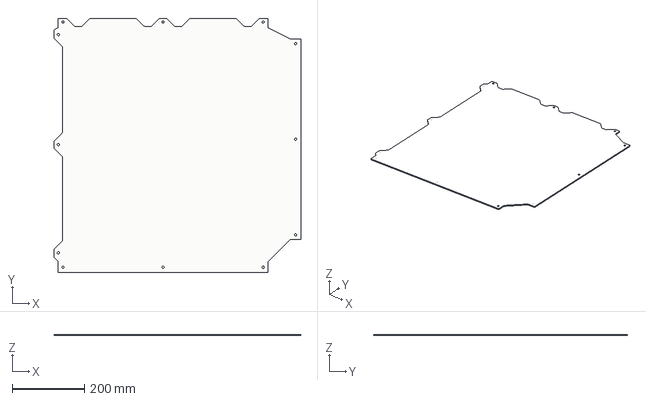
[picture p174: CAD file, 2022-09-23]
cad/panels/STEP/Imperial Units (Inches)/500/panel_enc2_side_split_bottom_500.step
685.0 x 705.2 x 4.00 mm
