Rat-Rig/V-core-3/cad/panels/STEP/Metric Units (mm)/300/panel_enc2_side_split_top_300.step

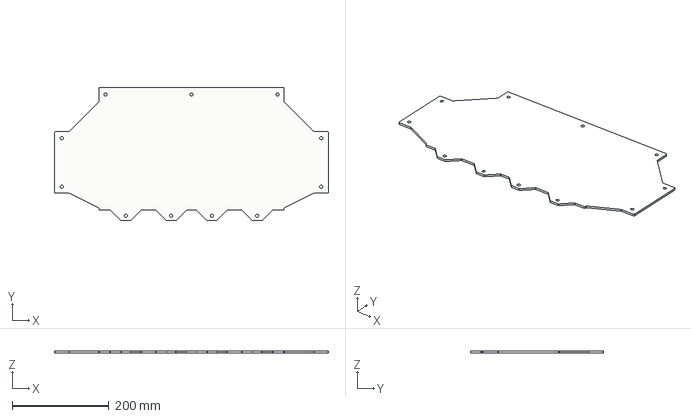
[picture p175: CAD file, 2022-09-23]
cad/panels/STEP/Metric Units (mm)/300/panel_enc2_side_split_top_300.step
565.0 x 275.2 x 4.00 mm
