Rat-Rig/V-core-3/cad/printed_parts/step/core/xy_motor_suport_right_3.1.step

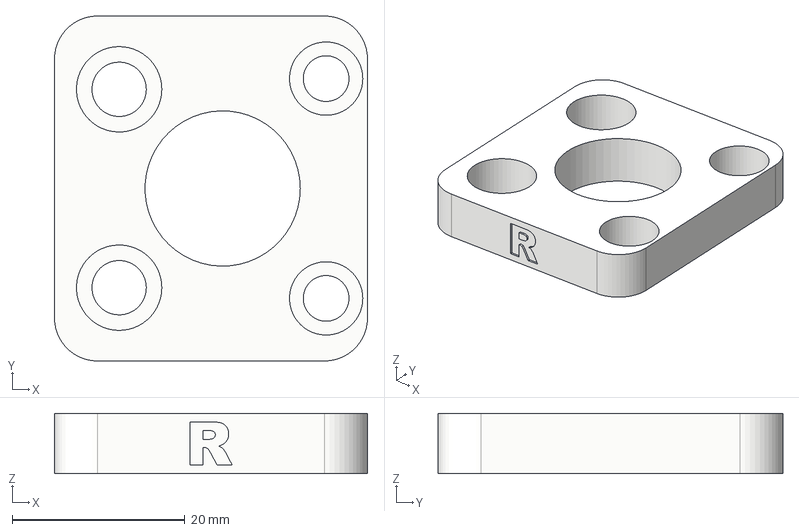
[picture p176: CAD file, 2022-06-30]
cad/printed_parts/step/core/xy_motor_suport_right_3.1.step
36.3 x 40.0 x 7.00 mm
