Rat-Rig/V-core-3/cad/printed_parts/step/enclosure_optional/enclosure2_t-plate_trim_5mm.step

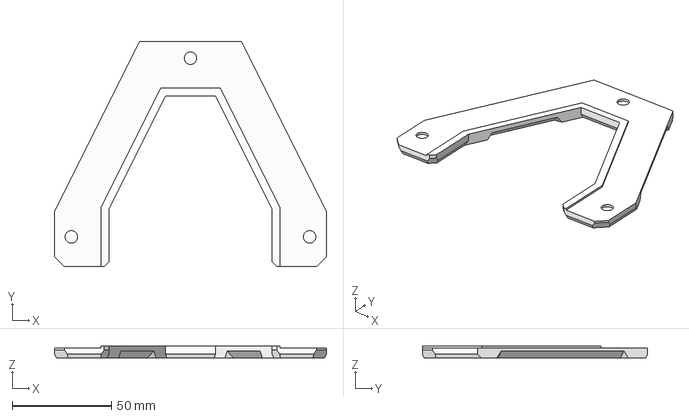
[picture p177: CAD file, 2022-09-23]
cad/printed_parts/step/enclosure_optional/enclosure2_t-plate_trim_5mm.step
137.0 x 113.5 x 6.00 mm
