Rat-Rig/V-core-3/cad/printed_parts/step/eva3/40mm_fan_inlet.step

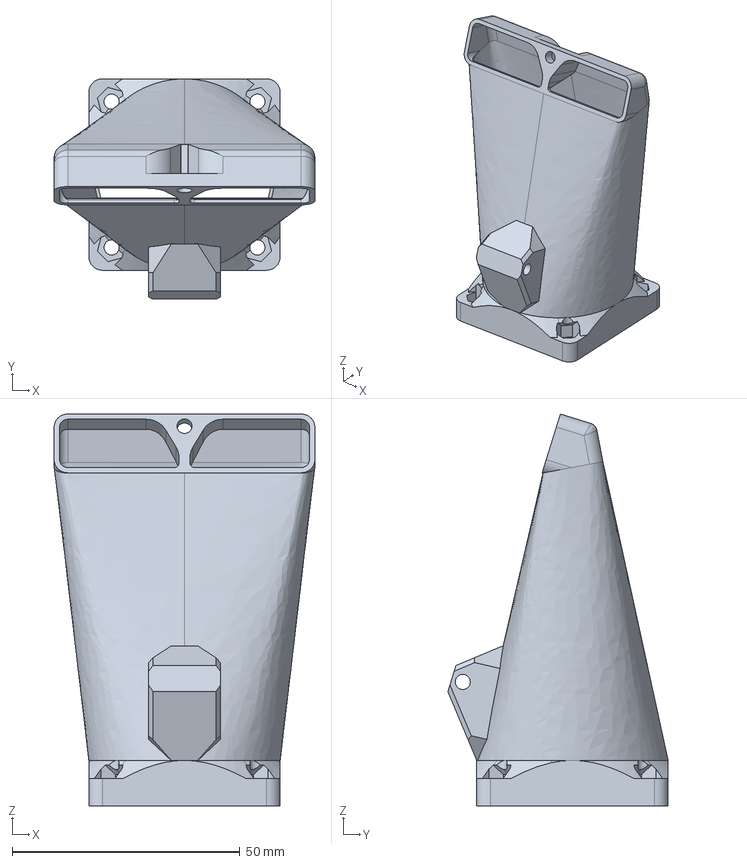
[picture p178: CAD file, 2022-06-30]
cad/printed_parts/step/eva3/40mm_fan_inlet.step
57.2 x 48.3 x 86.0 mm
