Rat-Rig/V-core-3/cad/panels/STEP/Imperial Units (Inches)/400/panel_enc2_top_400.step

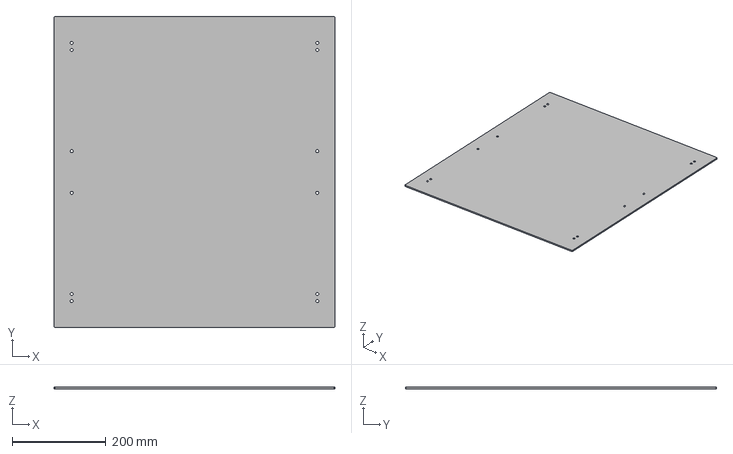
[picture p180: CAD file, 2022-09-23]
cad/panels/STEP/Imperial Units (Inches)/400/panel_enc2_top_400.step
600.0 x 665.0 x 4.00 mm
