Rat-Rig/V-core-3/(list of files, cad)

Other CAD files:
cad/panels/STEP/Metric Units (mm)/200/panel_electronics_200.step
cad/panels/STEP/Metric Units (mm)/300/panel_electronics_split_300_bottom_left.step
cad/panels/STEP/Metric Units (mm)/400/panel_electronics_split_400_bottom_right.step
cad/panels/STEP/Imperial Units (Inches)/500/panel_electronics_split_500_bottom_left.step
cad/panels/STEP/Metric Units (mm)/300/panel_electronics_split_300_bottom_right.step
cad/panels/STEP/Metric Units (mm)/400/panel_electronics_400.step
cad/panels/STEP/Metric Units (mm)/500/panel_electronics_split_500_bottom_left.step
cad/printed_parts/step/core/enclosure2_spool_holder_4mm.step
cad/printed_parts/step/enclosure_optional/enclosure2_spool_holder_3mm.step
cad/panels/STEP/Imperial Units (Inches)/300/panel_electronics_split_300_top_right.step
cad/panels/STEP/Imperial Units (Inches)/400/panel_electronics_split_400_bottom_right.step
cad/panels/STEP/Imperial Units (Inches)/500/panel_electronics_split_500_top_lright.step
cad/panels/STEP/Metric Units (mm)/300/panel_electronics_split_300_top_left.step
cad/panels/STEP/Metric Units (mm)/400/panel_electronics_split_400_top_left.step
cad/panels/STEP/Metric Units (mm)/500/panel_electronics_500.step
cad/printed_parts/step/enclosure_optional/enclosure2_spool_holder_5mm.step
cad/panels/STEP/Imperial Units (Inches)/300/panel_electronics_split_300_top_left.step
cad/panels/STEP/Imperial Units (Inches)/400/panel_electronics_split_400_bottom_left.step
cad/panels/STEP/Imperial Units (Inches)/500/panel_electronics_split_500_top_left.step
cad/panels/STEP/Metric Units (mm)/200/panel_enc2_side_split_bottom_200.step
cad/panels/STEP/Metric Units (mm)/300/panel_electronics_split_300_top_right.step
cad/panels/STEP/Metric Units (mm)/400/panel_electronics_split_400_bottom_left.step
cad/panels/STEP/Metric Units (mm)/500/panel_electronics_split_500_top_left.step
cad/panels/STEP/Metric Units (mm)/IDEX/panel_idex_electronics_split_400_top_right.step
cad/panels/STEP/Imperial Units (Inches)/200/panel_enc2_side_200.step
cad/panels/STEP/Imperial Units (Inches)/300/panel_electronics_split_300_bottom_right.step
cad/panels/STEP/Imperial Units (Inches)/400/panel_electronics_split_400_top_left.step
cad/panels/STEP/Imperial Units (Inches)/500/panel_electronics_split_500_bottom_right.step
cad/panels/STEP/Imperial Units (Inches)/IDEX/panel_enc2_idex_back_400.step
cad/panels/STEP/Metric Units (mm)/200/panel_enc2_top_200.step
cad/panels/STEP/Metric Units (mm)/300/panel_electronics_300.step
cad/panels/STEP/Metric Units (mm)/400/panel_electronics_split_400_top_right.step
cad/panels/STEP/Metric Units (mm)/500/panel_electronics_split_500_top_right.step
cad/panels/STEP/Metric Units (mm)/IDEX/panel_enc2_idex_door_400.step
cad/panels/STEP/Imperial Units (Inches)/200/panel_enc2_back_200.step
cad/panels/STEP/Metric Units (mm)/300/panel_enc2_door_300.step
cad/panels/STEP/Metric Units (mm)/400/panel_enc2_door_400.step
cad/panels/STEP/Metric Units (mm)/500/panel_enc2_door_500.step
cad/printed_parts/step/enclosure/xy_motor_cage_top_left_3.1_cutout.step
cad/panels/STEP/Imperial Units (Inches)/200/panel_enc2_side_split_top_200.step
cad/panels/STEP/Imperial Units (Inches)/IDEX/panel_idex_electronics_split_400_bottom_left.step
cad/panels/STEP/Metric Units (mm)/200/panel_enc2_door_200.step
cad/panels/STEP/Metric Units (mm)/500/panel_enc2_side_split_top_500.step
cad/panels/STEP/Metric Units (mm)/IDEX/panel_enc2_idex_door_300.step
cad/panels/STEP/Metric Units (mm)/200/panel_base_200_3.1.step
cad/printed_parts/step/core/xy_joiner_left_3.1.step
cad/printed_parts/step/enclosure_optional/enclosure2_t-plate_half-trim_A_3mm.step
cad/panels/STEP/Imperial Units (Inches)/200/panel_electronics_200_plain.step
cad/panels/STEP/Imperial Units (Inches)/400/panel_enc2_door_split_top_400.step
cad/panels/STEP/Imperial Units (Inches)/500/panel_enc2_back_500.step
cad/panels/STEP/Metric Units (mm)/200/panel_electronics_200_plain.step
cad/panels/STEP/Imperial Units (Inches)/300/panel_enc2_back_300.step
cad/panels/STEP/Imperial Units (Inches)/IDEX/panel_idex_electronics_split_500_bottom_left.step
cad/panels/STEP/Metric Units (mm)/400/panel_enc2_back_400.step
cad/panels/STEP/Metric Units (mm)/500/panel_enc2_door_split_top_500.step
cad/panels/STEP/Metric Units (mm)/IDEX/panel_idex_electronics_split_500_top_right.step
cad/panels/DXF/Imperial Units (Inches)/200/panel_base_200_3.1.dxf
cad/panels/DXF/Imperial Units (Inches)/200/panel_electronics_200.dxf
cad/panels/DXF/Imperial Units (Inches)/200/panel_electronics_200_plain.dxf
cad/panels/DXF/Imperial Units (Inches)/200/panel_enc2_back_200.dxf
cad/panels/DXF/Imperial Units (Inches)/200/panel_enc2_door_200.dxf
cad/panels/DXF/Imperial Units (Inches)/200/panel_enc2_side_200.dxf
cad/panels/DXF/Imperial Units (Inches)/200/panel_enc2_side_split_bottom_200.dxf
cad/panels/DXF/Imperial Units (Inches)/200/panel_enc2_side_split_top_200.dxf
cad/panels/DXF/Imperial Units (Inches)/200/panel_enc2_top_200.dxf
cad/panels/DXF/Imperial Units (Inches)/300/panel_base_300_3.1.dxf
cad/panels/DXF/Imperial Units (Inches)/300/panel_electronics_300.dxf
cad/panels/DXF/Imperial Units (Inches)/300/panel_electronics_300_plain.dxf
cad/panels/DXF/Imperial Units (Inches)/300/panel_electronics_split_300_bottom_left.dxf
cad/panels/DXF/Imperial Units (Inches)/300/panel_electronics_split_300_bottom_right.dxf
cad/panels/DXF/Imperial Units (Inches)/300/panel_electronics_split_300_plain_bottom_left.dxf
cad/panels/DXF/Imperial Units (Inches)/300/panel_electronics_split_300_plain_bottom_right.dxf
cad/panels/DXF/Imperial Units (Inches)/300/panel_electronics_split_300_plain_top_left.dxf
cad/panels/DXF/Imperial Units (Inches)/300/panel_electronics_split_300_plain_top_right.dxf
cad/panels/DXF/Imperial Units (Inches)/300/panel_electronics_split_300_top_left.dxf
cad/panels/DXF/Imperial Units (Inches)/300/panel_electronics_split_300_top_right.dxf
cad/panels/DXF/Imperial Units (Inches)/300/panel_enc2_back_300.dxf
cad/panels/DXF/Imperial Units (Inches)/300/panel_enc2_door_300.dxf
cad/panels/DXF/Imperial Units (Inches)/300/panel_enc2_side_300.dxf
cad/panels/DXF/Imperial Units (Inches)/300/panel_enc2_side_split_bottom_300.dxf
cad/panels/DXF/Imperial Units (Inches)/300/panel_enc2_side_split_top_300.dxf
cad/panels/DXF/Imperial Units (Inches)/300/panel_enc2_top_300.dxf
cad/panels/DXF/Imperial Units (Inches)/400/panel_base_400_3.1.dxf
cad/panels/DXF/Imperial Units (Inches)/400/panel_electronics_400.dxf
cad/panels/DXF/Imperial Units (Inches)/400/panel_electronics_400_plain.dxf
cad/panels/DXF/Imperial Units (Inches)/400/panel_electronics_split_400_bottom_left.dxf
cad/panels/DXF/Imperial Units (Inches)/400/panel_electronics_split_400_bottom_right.dxf
cad/panels/DXF/Imperial Units (Inches)/400/panel_electronics_split_400_plain_bottom_left.dxf
cad/panels/DXF/Imperial Units (Inches)/400/panel_electronics_split_400_plain_bottom_right.dxf
cad/panels/DXF/Imperial Units (Inches)/400/panel_electronics_split_400_plain_top_left.dxf
cad/panels/DXF/Imperial Units (Inches)/400/panel_electronics_split_400_plain_top_right.dxf
cad/panels/DXF/Imperial Units (Inches)/400/panel_electronics_split_400_top_left.dxf
cad/panels/DXF/Imperial Units (Inches)/400/panel_electronics_split_400_top_right.dxf
cad/panels/DXF/Imperial Units (Inches)/400/panel_enc2_back_400.dxf
cad/panels/DXF/Imperial Units (Inches)/400/panel_enc2_door_400.dxf
cad/panels/DXF/Imperial Units (Inches)/400/panel_enc2_door_split_bottom_400.dxf
cad/panels/DXF/Imperial Units (Inches)/400/panel_enc2_door_split_top_400.dxf
cad/panels/DXF/Imperial Units (Inches)/400/panel_enc2_side_400.dxf
cad/panels/DXF/Imperial Units (Inches)/400/panel_enc2_side_split_bottom_400.dxf
cad/panels/DXF/Imperial Units (Inches)/400/panel_enc2_side_split_top_400.dxf
cad/panels/DXF/Imperial Units (Inches)/400/panel_enc2_top_400.dxf
cad/panels/DXF/Imperial Units (Inches)/500/panel_base_500_3.1.dxf
cad/panels/DXF/Imperial Units (Inches)/500/panel_electronics_500.dxf
cad/panels/DXF/Imperial Units (Inches)/500/panel_electronics_500_plain.dxf
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
