Rat-Rig/V-core-3/docs/src/assets/360/print/0007.png

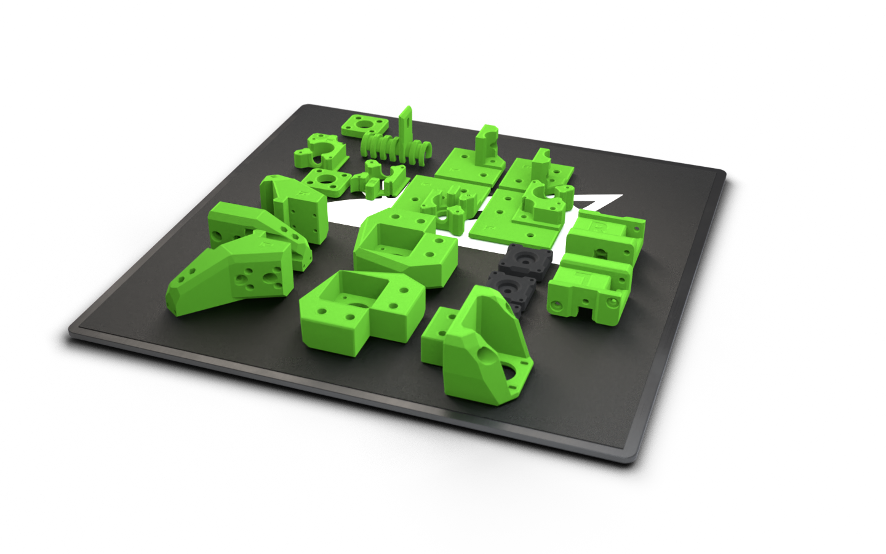
docs/src/assets/360/print/0007.png
