Rat-Rig/V-core-3/docs/src/assets/360/print/0020.png

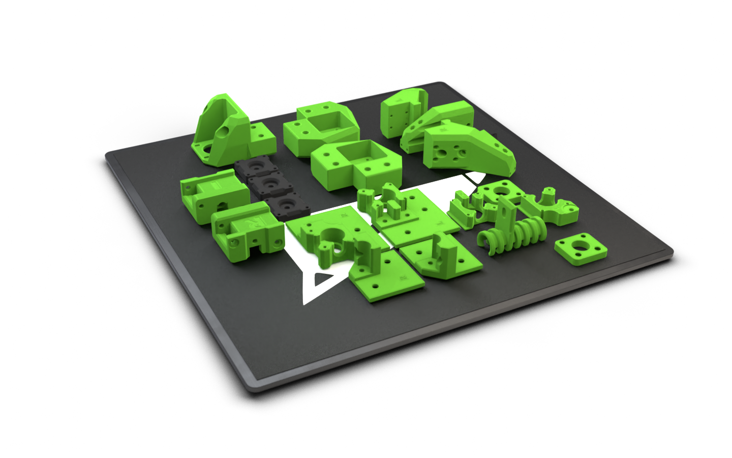
docs/src/assets/360/print/0020.png
