Rat-Rig/V-core-3/docs/src/assets/360/print/0029.png

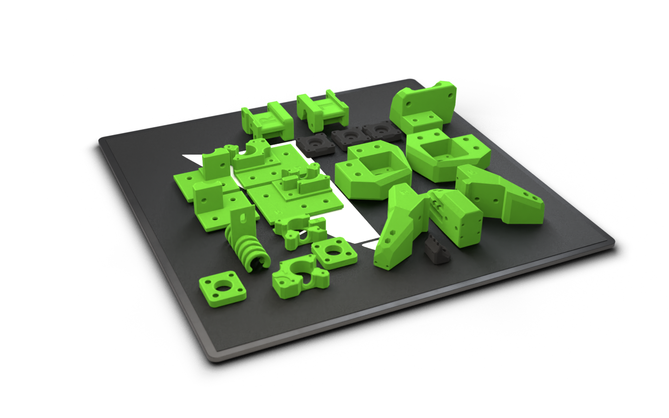
docs/src/assets/360/print/0029.png
