Rat-Rig/V-core-3/docs/src/assets/guide.png

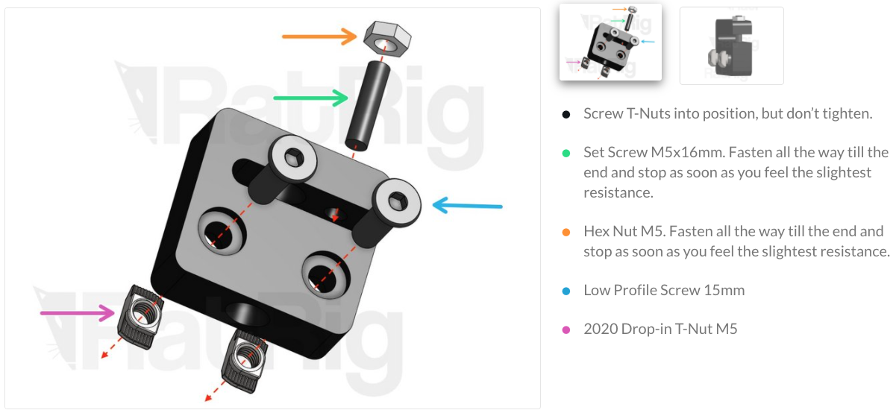
docs/src/assets/guide.png
