Rat-Rig/V-core-3/docs/src/assets/prints.jpg

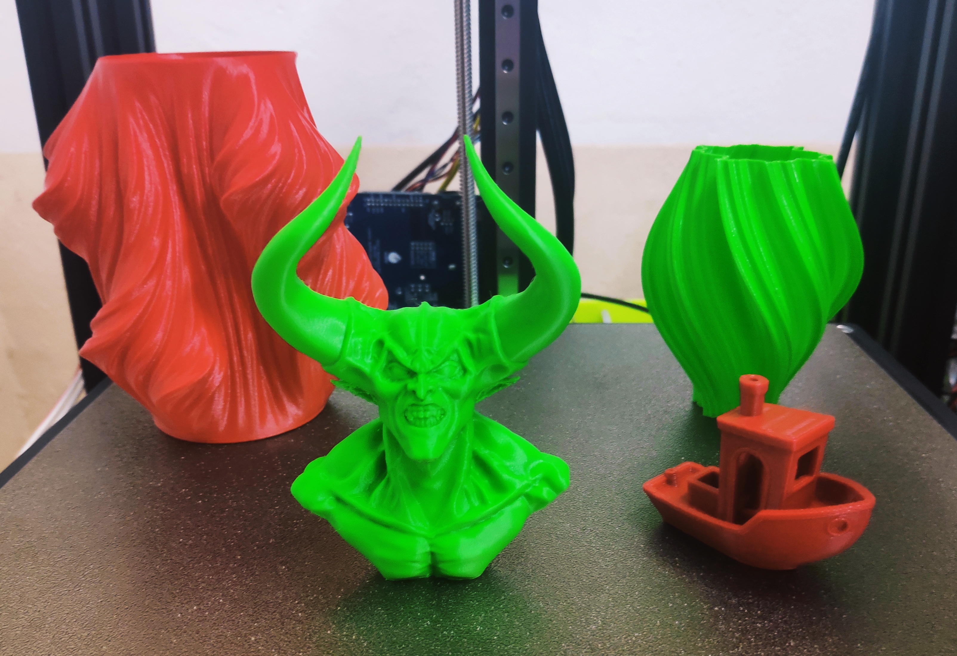
docs/src/assets/prints.jpg
