Rat-Rig/V-core-3/docs/src/assets/SKR Pro V1.2 Wiring Diagram V1.0.png

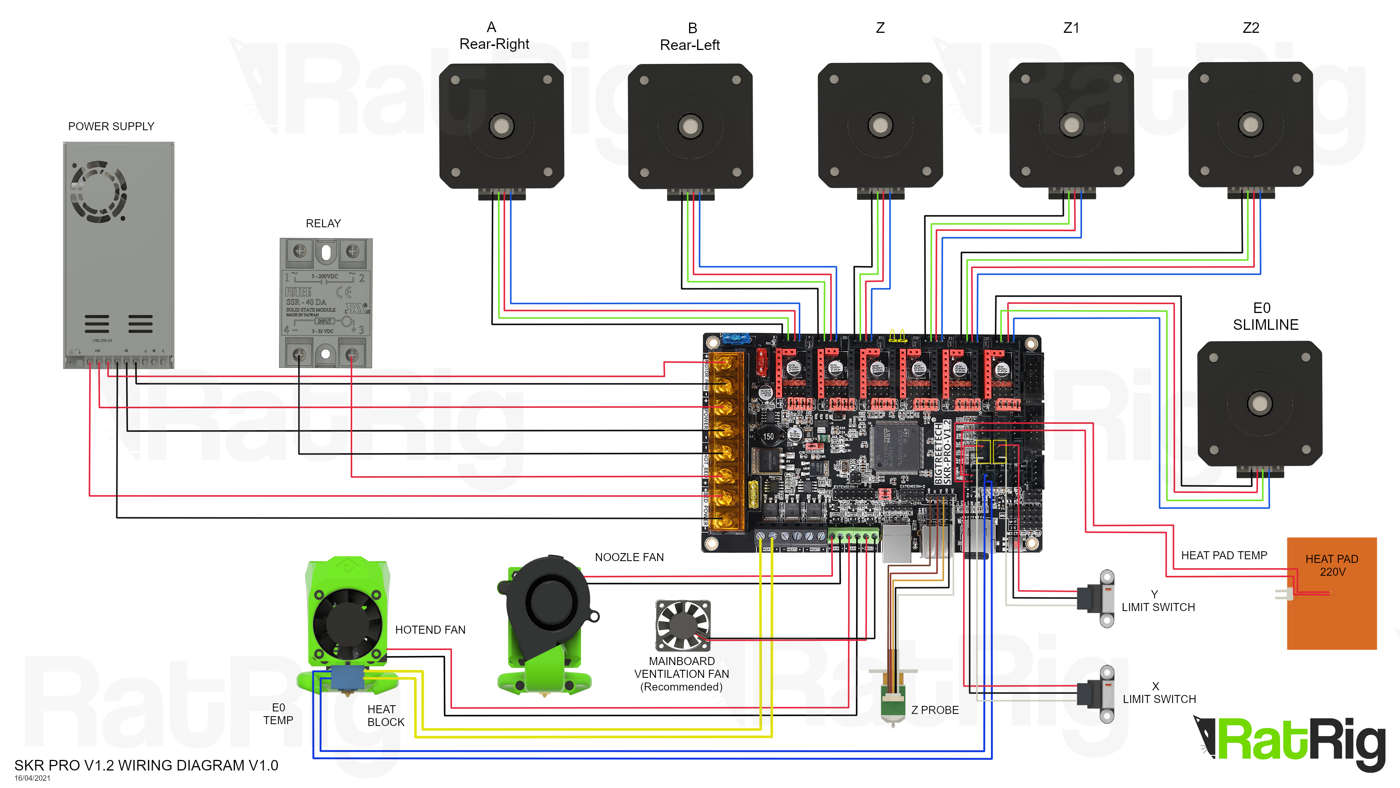
docs/src/assets/SKR Pro V1.2 Wiring Diagram V1.0.png
