Rat-Rig/V-core-3/(threads)

Thread 29 (2021-07-29):

motor_support_l and motor_support_r wrong hole dimension

Mitsuma, 2021-07-29:
Today while assembling my V-Core 3 I noticed that the CAD for the motor_support_l and motor_support_r pars have a small issue.

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

In the CAD the bigger diameter for the head of the screw shows 9.9mm for the M6 screw and 8.5mm for the M5 screw.
A DIN912 M6 screw has a diameter head of 10mm and 8.5mm for the M5 screw head.

So the bigger hole should be at least 10.2mm and 8.7mm diameter for the other for 0.2mm tolerance. (Maybe 10.3 and 8.8mm if 0.3mm tolerance was used.)

Im not comfortable in my CAD skills to make a pull request of my own changes, so I just post this issue here.

Thread 33 (2021-08-29):

Duplicate lines in panel DXF

elcojacobs, 2021-08-29:
The DXF files for the panels seem to have some issues.

- Almost all lines are duplicated.
- The file has about 20 layers, but they seem empty except for one
- Not all lines are joined well.

When I use the DXF file to get a quote, the quote is 25 euros higher compared to a cleaned-up file.

First I fixed the files by deleting all the extra stuff in Inkscape, but a good DXF can actually be exported form the 3D model on Onshape directly.
Open the linked document for the panels.
Right-click a panel and choose 'export DXF'.

I don't know if there is a good reason for the current DXFs to be like they are. But it would be easy to export the panels from Onshape and commit them to the repo instead of the current files.

pkucmus, 2021-08-29:
Hi, thanks for letting us know. I assume you checked the metric ones only? Or maybe all of them?

Onshape has a nasty bug of exporting every DXF in inches instead of the set document unit. That combined with how DXF is designed results in exports that are 450 inch where they should be 450mm (quite drastic). Plenty of software asks about the unit on import and then all is fine but a lot of shops around the world were defaulting to inch (or whatever the reason there was) and people were reporting that those are impossible to cut.
It's a constant battle with those.

elcojacobs, 2021-08-29:
That doesn't seem to happen when I export them. But that's probably because my default units in Onshape are set to metric?
I attached a file that I exported from Onshape. I had to rename it for github.
[panes-left-onshape.dxf.txt](https://github.com/Rat-Rig/V-core-3/files/7072663/panes-left-onshape.dxf.txt)

pkucmus, 2021-08-29:
So apparently you exported in the 1998 version of DXF (`AC1014` in line 8). As far as I understand DXF your `INSUNITS` is referencing a object `100000B7` (line 4228) and that object defines `1` which is Inch in line 6594

from https://images.autodesk.com/adsk/files/autocad_2012_pdf_dxf-reference_enu.pdf page 20:
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

The V-Core 3 document is set to milimeters so is my workspace but still Onshape returns `1` under `$INSUNITS` which tricks many readers into thinking it's in inches. Inkscape apparently ignores `$INSUNITS`, same goes for FreeCAD but apparently it's not the case for all of the readers (as users reported)

Inkscape on a direct export from Onshape:
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

elcojacobs, 2021-08-29:
All I can tell you is that the DXF's that are provided by RatRig cause problems with automated systems at shops that cut sheets due to duplicate lines. Tried them at both kunststofplatenshop.nl and 247tailorsteel.

The DXF created by right-clicking a panel on Onshape and choosing 'DXF/DWG export' creates no problems.
Onshape DXF (from panel, not from DXF in tree):
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
File attached, just to be sure I gave you the right one last time.
[400-left.dxf.txt](https://github.com/Rat-Rig/V-core-3/files/7073108/400-left.dxf.txt)

Github DXF:
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

weust1979, 2021-09-25:
When using the same website as @elcojacobs and using the panel_side_left_400.dxf  file from github, it shows me 56,53 Euro incl. BTW (tax).
All I did was a git clone and uploaded the file to the site.

nexx, 2021-09-26:
All of the DXF files have been updated to correct this issue.

Closed 2021-09-26.

Thread 34 (2021-09-03):

Back panel should be slightly smaller to have tolerance between the extrusions

elcojacobs, 2021-09-03:
The back panel width is exactly the same width as the x extrusions (54cm on the 400).
This leaves no room for error when the panel is made and there is no good reason to have it this tight.

The extrusions should be tightly pressed against each other, not against the panel.
If the panel would be 538mm, it creates fewer problems during assembly.

We discussed this on discord and Runeeh provided this photo:
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

The height is also best reduced by 1-2 mm.
Mistuma provided this photo of the top extrusions being pushed up by the panel:
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

Thread 41 (2021-09-16):

Wrong Fan default config for Duet 3 Mini

HelgeKeck, 2021-09-16:
maybe a good idea to change

M106 P1 C"Layer Fan" S0 H-1 L255
to
M106 P1 C"Layer Fan" S0 H-1

on the firmware documentation page.

The L255 option tells RRF to run the Fan with full power, even if you set it to just 1%

Thread 45 (2021-09-24):

Base Panel 400 front X-axis distance larger than distance between profiles

Angznugen, 2021-09-24:
Base panel Front X-axis edges are 540.150mm while the distance between profiles are 540mm
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

nexx, 2021-09-26:
This was due to the DXF files accounting for laser kerf.

#46 updates all DXF files to be exact dimensions, leaving the compensation of laser kerf down to the operator of the laser cutter. Further, STEP files are now available for all panels which can be directly imported into CAD software.

Closed 2021-09-26.

Thread 52 (2021-10-01):

Changed to printed parts

raymondjstone, 2021-10-01:
When you are changing a printed part could you consider either adding in a version number or better still indicating if the change is critical enough to require a reprint. I, like I would assume others have been printing parts waiting for the machine kit to arrive and making it clear if parts were wrong enough to require a reprint would be helpful

Thread 59 (2021-10-29):

lead_screw_motor_cage_back doesn't allow motor repositioning

ShuttleworthM, 2021-10-29:
In the previous version of the lead_screw_motor_cage_back part, the rear z-axis motor could be slid back and forth in its mount to allow for leadscrew alignment. In the latest version, the slots to allow this sliding action and the build guide indicate that the motor should be able to move; however, the material that has been added to the mount prevents this.

I am not sure if this is a problem or just a leftover from the previous iteration, please advise.

pkucmus, 2021-11-06:
It's fixed now. Thanks!

Closed 2021-11-06.

Thread 60 (2021-11-02):

[FR] Change orientation of front Z-rails

top-gun, 2021-11-02:
The position of the front Z-rails makes it easy to accidentally touch the rails. This rubs the oil or grase from the rail, causing dry spots where the rail will eventually corrode.

Suggested solution: Re-orient the rails 90° to the rear face of the vertical extrusion. The rails are now out of the way while operating the printer. The grease or oil won't stain hands or clothes, and the rails won't be accidentally rubbed dry, and the surfaces stay protected.

Thread 65 (2021-12-01):

Typo in BOMfor 500mm Variant

bhannawa, 2021-12-01:
Check the link here to see the problem for yourself. Two sections are titled "400mm panel set." The second title should say "500mm panel set."

oneredstar, 2021-12-02:
I found this issue as well as I was prepping to make the panels. Raised a PR for convenience.

#66

Thread 69 (2021-12-24):

No 2.85mm/3mm filament filament guide available

billyd60, 2021-12-24:
Hi

I am one of the few who will be using 2.85mm filament on my vcore 3. So I developed a filament guide based off the existing enc_3030_spool_holder_guide which was designed for 1.75mm.

I have no idea how to get it into the contrib file section so I figured I would upload it here and if someone cares to put it in to help others that would be great. If not just close this issue and ignore it.

Regards
Bil
[enc_3030_spool_holder_guide_3mm.zip](https://github.com/Rat-Rig/V-core-3/files/7774853/enc_3030_spool_holder_guide_3mm.zip)
l

Thread 71 (2022-01-04):

A printable electronics mounting solution?

mikejwaters, 2022-01-04:
Hi, sourcing laser or waterjet cut panels is annoying at the moment due to the supply chain and Covid.

So, I wrote an OpenSCAD script for making printable electronics mounts. The nice thing is that each board gets it's own mount. With this modularity, and I can rearrange the electronics later if I want to. Here are some pictures:

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
The green part represents the Duet3 Mini 5+ PCB and the black is the rail.

Is this reasonable? Are there more elegant designs around? Is this a worthwhile contribution?

Thanks,
-Mike

mikejwaters, 2022-01-10:
I moved the slots to make them easier to install and made the ribs into triangles to reduce waste.

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

Thread 75 (2022-03-27):

Enclosure lid hinged tie down needs a longer base

billyd60, 2022-03-27:
The printed hinged tie down needs 2mm more clearance between the base center hole and the inside vertical wall. The existing print does not provide adequate clearance and as a result the lower 3030 rail of the lid assembly must be moved outward 4mm (2 mm for front and back tie down clearance). I have attached a step and stl file which corrects the model by making the base 2mm longer than the existing design
[enc_lid_hinged_tiedown.zip](https://github.com/Rat-Rig/V-core-3/files/8356612/enc_lid_hinged_tiedown.zip)

billyd60, 2022-03-27:
Also while we're on the subject, at least for the 500 size, the top lid (hinged portion only) is too deep by 4mm. Specifically the 3030 rails that are cut to 704mm should be 700mm. (These are the two top side rails of the lid) This way the (hinged portion) lid forward base rail is flush with the frame of the printer in the front. As it is now, the hinged portion of the lid sticks out 4mm, even with the correction above (which only impacts the non hinged base of the lid). The base of the lid which is made up of 752mm side rails, is actually correct and the front of the base of the lid is flush with the printer.

billyd60, 2022-03-28:
Of course if you reduce the side rails from 704 to 700mm you'll also need to modify the top and side panel dxf's so the are 4mm shorter in depth to match.

billyd60, 2022-05-24:
Actually I've noticed the side panel dxf's are actually correct as is as they are 4mm short on my enclosure. The top panel would have to still be reduced by 4mm in depth however. Sorry for the scattered information.

Thread 77 (2022-05-07):

Door Hinge Frame does not work with 6mm panels

Spotigus, 2022-05-07:
Need to extend hinge by 3mm. Will create pull request.

Thread 83 (2022-07-03):

Default orientation of 3.1 XY joiners is wrong

etotheipi, 2022-07-03:
With the release of 3.1, one of the pages mentions that all .STL files should be oriented correctly by default.  However, that does not appear to be the case for the XY joiner pieces, which are now shown standing tall.  It's an awkward piece, so it's tough to tell what the best orientation should actually be.   But I seem to remember in the previous version of the docs, and now also shown on the purchase page, that it should be flat with the embossed letters facing up:

https://www.ratrig.com/3d-printing-cnc/v-core-3-printed-parts-bundle-petg-1409.html

I just tried it in the default orientation and it's not a disaster but it's not great.  Should probably still be updating (assuming I am correct).

Thread 86 (2022-08-09):

Can't find Bracket board

cloud604, 2022-08-09:
Divided into three, it is difficult to buy domestic, I want to use the print to play up with, and aluminum plate processing diagram (specific which distance to open the hole), I hope you can upload the DXF file, thank you!

V-Core 3.0 - IDLER_PLATE_V1.0
V-Core 3.0 - MOTOR_PLATE_V1.0
V-Core 3.1 - XY_JOINER_PLATE_V1.1
Bed Plate - Cast tooling plate - Pre-Machined

Closed 2022-08-09.

Thread 87 (2022-08-25):

[DANGER] Grounding issues

olivbd, 2022-08-25:
I noticed that:

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

Means the bed IS NOT isolated. What happens if the heat pad is defective and the user touches the bed?

All metal parts must be grounded to an earth wire.

StefanIGit, 2022-08-25:
Hi, sorry but rtfm man... Step 9 red text and 3rd image
https://ratrig.dozuki.com/Guide/07.+Bed+Assembly/77#s462

ptegler, 2022-08-25:
not the RED text but three lines below that
If your heat pad faults, and shorts to the bed plate, it 'should' blow your fuse.

olivbd, 2022-08-25:
> Hi, sorry but rtfm man... Step 9 red text and 3rd image https://ratrig.dozuki.com/Guide/07.+Bed+Assembly/77#s462

Ok thanks, I didn't noticed that but it should be clearly mentionned that the ground wire MUST be wired in that case.

> not the RED text but three lines below that If your heat pad faults, and shorts to the bed plate, it 'should' blow your fuse. And yes, ANYTHING AC line powered, your frame should be earth grounded as well, even if not using AC mains for the bed heater.

We agree: frame and bed should be earth grounded.

StefanIGit, 2022-08-25:
Ah ja, my bad the text with the RED dot :)
And yes it could be more clear, not a lawyer,  but as the red text says  `This is a mains voltage element, you should consult an electrician when dealing with it`

Resonanz, 2022-09-11:
Um, if using mains voltage, ALL metal should be earthed/grounded. Especially the frame and the build plate. It would be wise to use an earth leakage breaker to cut power in case of mains leakage or fault.

Thread 88 (2022-08-29):

no mounting holes for the specific electronics listed on the cad.

lordanime83, 2022-08-29:
when I was uploading the dxf files to get the electronic panels made I noticed that the panels don't have a mounting holes for the electronics and no specification so you could use the correct ones they were there before so why were they removed?

Thread 93 (2023-03-26):

lead_screw_motor_cage_back_trim_3.1.stl is mirrored

Kaelum, 2023-03-26:
The part at https://github.com/Rat-Rig/V-core-3/blob/main/cad/printed_parts/stl/enclosure/lead_screw_motor_cage_back_trim_3.1.stl is mirrored, and can't be used as-is.  The longer leg needs to be on the right, when looking at the frame from the front.
