Rat-Rig/V-core-3/cad/panel_base_30_to_31_cutout_template.pdf

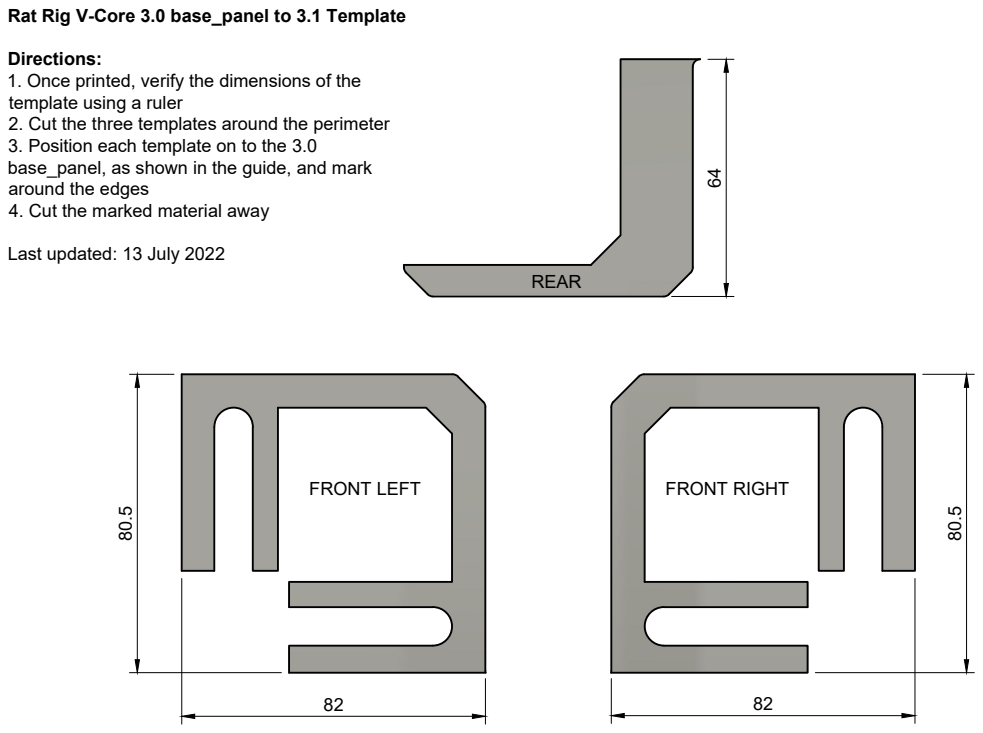
[picture p214: page 1]
FRONT LEFT; FRONT RIGHT

Rat Rig V-Core 3.0 base_panel to 3.1 Template

Directions:
1. Once printed, verify the dimensions of the
template using a ruler
2. Cut the three templates around the perimeter
3. Position each template on to the 3.0
base_panel, as shown in the guide, and mark
around the edges
4. Cut the marked material away

Last updated: 13 July 2022
