Rat-Rig/V-core-3/(commit log)

2021-02-28 Rename part filenames, add auto build for docs
    [Extras - bed_arm_back.stl, Extras - bed_arm_left.stl, Extras - bed_arm_right.stl, Extras - bed_cable_relief.stl, Extras - colar.stl, Extras - iec_socket_adapter.stl, Extras - lan_socket_adapter.stl, Extras - lead_screw_motor_cage_back.stl]
2021-02-28 add initial firmware
    [bed.g, config-override.g, config.g, homeall.g, homex.g, homey.g, homez.g, pause.g]
2021-02-28 remove cad.bak directory
    [Extras - bed_arm_back.stl, Extras - bed_arm_left.stl, Extras - bed_arm_right.stl, Extras - bed_cable_relief.stl, Extras - colar.stl, Extras - iec_socket_adapter.stl, Extras - lan_socket_adapter.stl, Extras - lead_screw_motor_cage_back.stl]
2021-02-28 Add licence and mains warning to wiring diagram
2021-03-09 Add bom
    [V-CORE 3.0 - pub.csv, printed_parts.csv]
2021-03-10 add v1.3 subpage, adjust verbiage, update wiring diagram
2021-03-11 add wiring.xcf, change title, add CNAME, bump 1.3
2021-03-11 add csv download buttons
2021-03-12 add docker compose, update BOM
    [V-CORE 3.0 - pub.csv]
2021-03-18 add spool holder, add MGN allignment tool, bump 1.3 docs
    [MGN12 3030 Centering Tool V1.0.step, MGN12 3030 Centering Tool V1.0.stl, printed_parts.csv, spool_holder_3030_arm_v2_rr.step, spool_holder_3030_arm_v2_rr.stl, spool_holder_guide.step, spool_holder_guide.stl, spool_holder_knob.step]
2021-03-18 move MGN tool
    [MGN12 3030 Centering Tool V1.0.step, MGN12 3030 Centering Tool V1.0.stl]
2021-03-30 Add links to EVA
    [V-CORE 3.0 - pub.csv]
2021-04-01 BOM: Change GT2 to 2GT
    I assume this is autogenerated from CAD? Either it should be fixed there, or if that's too difficult, we should pre process the CSV in the build process to replace GT2 with 2GT.
    [V-CORE 3.0 - pub.csv]
2021-04-09 reorder files, add panels, add target=_blank to nav links
    [300_panels.dxf, 400_panels.dxf, 500_panels.dxf, MGN12 3030 Centering Tool V1.0.step, MGN12 3030 Centering Tool V1.0.stl, Panes - DXF_export.dxf, V-CORE 3.0 - pub.csv, back_spine.step]
2021-04-09 upgrade wiring diagram
2021-04-10 split DXF files to separate the panels to individual files
    [DXF_export_back_300.dxf, DXF_export_back_400.dxf, DXF_export_back_500.dxf, DXF_export_left_300.dxf, DXF_export_left_400.dxf, DXF_export_left_500.dxf, DXF_export_right_300.dxf, DXF_export_right_400.dxf]
2021-04-10 Availability section removed
    [300_panels.dxf, 400_panels.dxf, 500_panels.dxf, Panes - DXF_export.dxf]
2021-04-10 rename dsf files, add blank electronics panels dxfs
    [electronics_panel_Duet3Mini_300.dxf, electronics_panel_Duet3Mini_400.dxf, electronics_panel_Duet3Mini_500.dxf, electronics_panel_blank_300.dxf, electronics_panel_blank_400.dxf, electronics_panel_blank_500.dxf, panel_iec_lan_300.dxf, panel_iec_lan_400.dxf]
2021-04-10 udpate 1.3, remove old dxf
    [300_panels.dxf, 400_panels.dxf, 500_panels.dxf]
2021-04-11 Add Duet/RRF page
    [bed.g, config-override.g, config.g, homeall.g, homex.g, homey.g, homez.g, pause.g]
2021-04-16 Update wiring diagram and electronics information, update firmware details
    [config.g]
2021-04-19 update wiring diagrams and descriptions
2021-04-22 Add Klipper guide
2021-04-23 Fix weak point on the M5 screw holes in the XY jointers
    [xy_joiner_left.step, xy_joiner_left.stl, xy_joiner_right.step, xy_joiner_right.stl]
2021-04-29 Add BLTouch files, reogranize the config.g file
    [config.g, deployprobe.g, homeall.g, homex.g, homey.g, homez.g, pause.g, resume.g]
2021-05-02 Add instructions to cut DIAG pins on SKR
2021-05-02 Make stepper driver pics smaller
2021-05-04 Fix mirrored SKR Pro stepper driver pins
2021-05-04 Add SKR Pro ADXL345 wiring
2021-05-09 refine RRF's config files
    [config-override.g, deployprobe.g]
2021-05-11 change of DXF files from 1 (Inches) to 4 (Millimeters)
    [electronics_panel_Duet3Mini_300.dxf, electronics_panel_Duet3Mini_400.dxf, electronics_panel_Duet3Mini_500.dxf, electronics_panel_blank_300.dxf, electronics_panel_blank_400.dxf, electronics_panel_blank_500.dxf, panel_iec_lan_300.dxf, panel_iec_lan_400.dxf]
2021-05-11 Add Duet3 6HC wiring diagram
2021-05-19 Add easy klipper z-offset guide
2021-05-19 Change e-steps to assume 0.9 degree LDO stepper from RR
    [config.g]
2021-05-23 Add model for 30x30 cable clip
    [cable_clip_30x30.step, cable_clip_30x30.stl]
2021-05-30 Word the link to the wiring diagram better
2021-06-03 video frame size
2021-06-03 Update lan_socket_adapter.step
    Modified width of latch area to allow for wider latches on RJ45 keystones. Adjusted the visible surfaces on the outside to more closely align to the face of the RJ45 connector.
    [lan_socket_adapter.step]
2021-06-03 Create 3030 Cable Clip.step
    A simple clip that twists into the 3030 extrusion allowing for cable management of the stepper motor cables and Y end stop cable.
    [3030 Cable Clip.step]
2021-06-03 Update iec_socket_adapter.step
    Added holes for IEC connectors with vertical holes. Added chamfers so IEC connector only fits one way round. Expanded outer faces to give more space for the nuts. increased hole diameter from 3.3mm to 3.5mm.
    [iec_socket_adapter.step]
2021-06-03 Clip, LAN and IEC changes
    [3030 Cable Clip.stl, iec_socket_adapter.step, iec_socket_adapter.stl, lan_socket_adapter.stl]
2021-06-11 RRF: Stay at home after homing
    Depending on the installed position of the X and Y endstops, X0, Y0 can actually be off the front corner of the bed. Further, this can cause a light collision between the BLTouch and the front left idler.
    As the end user will most likely perform a homing move as the first thing they do, this will avoid any issues as much as possible.
    [homeall.g, homex.g, homey.g]
2021-06-11 RRF: Remove G29 from G32
    Don't perform a G29 (mesh bed level) automatically after a G32 (3 point levelling). The end user can do this themselves and it un-necessarily complicates things.
    [bed.g]
2021-06-11 RRF: Reduce BLTouch probe speed
    500 mm/min is too fast for reliable BLTouch probing. It can lead to a situation where the probe hasn't fully deployed before the bed is moving back towards the probe.
    Cloned probes also cannot cope with higher speeds. Again, set a sane default and allow the user to tweak as desired.
    [config.g]
2021-06-11 RRF: Correct bed mesh grid
    Slightly reduce the bed mesh size. EVA probes cannot reach X300 or Y300 which leads to probing errors.
    [config.g]
2021-06-16 fix(docs): point BOM download links to the correct path
    [printed_parts.csv]
2021-06-16 fix(broken-links): remove endline from the .csv
    [printed_parts.csv]
2021-06-22 add a contrib dir and move contributions there
    [3030 Cable Clip.step, 3030 Cable Clip.stl, iec_socket_adapter.step, iec_socket_adapter.stl, lan_socket_adapter.step, lan_socket_adapter.stl]
2021-06-24 Add surface mount iec socket adapter
    Remove additional mount holes
    Move STL/STEP to separate folders
    [iec_socket_adapter_surface_mount.step, iec_socket_adapter_surface_mount.stl]
2021-07-01 Updated DXF files
    [300 Electronics Panel.dxf, 300 Side Panel Left.dxf, 300 Side Panel Right.dxf, 400 Electronics Panel.dxf, 400 Side Panel Left.dxf, 400 Side Panel Right.dxf, 500 Electronics Panel.dxf, 500 Side Panel Left.dxf]
2021-07-01 DXF imperial and metric
    [300 Electronics Panel.dxf, 300 Side Panel Left.dxf, 300 Side Panel Right.dxf, 400 Electronics Panel.dxf, 400 Side Panel Left.dxf, 400 Side Panel Right.dxf, 500 Electronics Panel.dxf, 500 Side Panel Left.dxf]
2021-07-02 Add teaching Tech custom Rat Rig parts.
    Add teaching Tech custom Rat Rig parts.
    [PSU plug holder - front.step, PSU plug holder - front.stl, PSU plug holder -rear cap.step, PSU plug holder -rear cap.stl, corner webcam mount.step, corner webcam mount.stl, electronics_panel_BTTSKRPro_raspi4_300.dxf, grommet drilling jig.step]
2021-07-02 move contrib files to the contrib folder
    [cable_clip_30x30.step, cable_clip_30x30.stl]
2021-07-02 move files to the new contrib directory
    [PSU plug holder - front.step, PSU plug holder - front.stl, PSU plug holder -rear cap.step, PSU plug holder -rear cap.stl, corner webcam mount.step, corner webcam mount.stl, electronics_panel_BTTSKRPro_raspi4_300.dxf, grommet drilling jig.step]
2021-08-03 Update V-CORE 3.0 - pub.csv
    @SonatRatRig per your ask I'm updating the belt sizes. Please merge when ready.
    [V-CORE 3.0 - pub.csv]
2021-08-12 updated wiring diagrams with warnings
2021-08-12 Add previews of the new wiring images
2021-09-12 added SuperSlicer profile 0.3
    First published version of the Superslicer profile, V-Core-3-300, 400/500 later on
    [ratrig-vcore-bed-300x300.stl]
2021-09-14 DXF: Remove all existing files
    Clear out the existing DXF files in preparation for a new full set.
    [300 Electronics Panel.dxf, 300 Side Panel Left.dxf, 300 Side Panel Right.dxf, 400 Electronics Panel.dxf, 400 Side Panel Left.dxf, 400 Side Panel Right.dxf, 500 Electronics Panel.dxf, 500 Side Panel Left.dxf]
2021-09-14 DXF: Add all enclosure panels (metric)
    Add DXF files of all of the panels used for the full enclosure, in metric format.
    This includes a plain electronics panel which only features the required mounting holes to fasten it to the frame. The user is then free to drill their own mounting holes as they see fit.
    [panel_base_300.dxf, panel_base_400.dxf, panel_base_500.dxf, panel_door_300.dxf, panel_door_400.dxf, panel_door_500.dxf, panel_electronics_plain_300.dxf, panel_electronics_plain_400.dxf]
2021-09-14 DXF: Add all enclosure panels (imperial)
    Add DXF files of all of the panels used for the full enclosure, in imperial format.
    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
    [panel_base_300.dxf, panel_base_400.dxf, panel_base_500.dxf, panel_door_300.dxf, panel_door_400.dxf, panel_door_500.dxf, panel_electronics_plain_300.dxf, panel_electronics_plain_400.dxf]
2021-09-14 DXF: Add electronics panel variants (metric)
    These files introduce metric electronics panel DXF files for all machine sizes, with the following variants:
    - BTT Octopus & Raspberry Pi 3/4
    - BTT SKR Pro v1.2 & Raspberry Pi 3/4
    - Duet3D Duet 3 MB6HC
    - Duet3D Duet 3 MB6HC & Raspberry Pi 3/4 (for SBC mode)
    - Duet3D Duet 3 Mini 5+
    - Duet3D Duet 3 Mini 5+ & Raspberry Pi 3/4 (for SBC mode, or for Klipper)
    All panel variants include mounting positions for the Weho 350W PSU, and the C-Lin SSR sold by RatRig.
    [panel_electronics_btt_octopus_rpi_300.dxf, panel_electronics_btt_octopus_rpi_400.dxf, panel_electronics_btt_octopus_rpi_500.dxf, panel_electronics_btt_skr_pro_1_2_rpi_300.dxf, panel_electronics_btt_skr_pro_1_2_rpi_400.dxf, panel_electronics_btt_skr_pro_1_2_rpi_500.dxf, panel_electronics_duet3_mb6hc_300.dxf, panel_electronics_duet3_mb6hc_400.dxf]
2021-09-14 DXF: Add electronics panel variants (imperial)
    These files introduce imperial electronics panel DXF files for all machine sizes, with the following variants:
    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
    [panel_electronics_btt_octopus_rpi_300.dxf, panel_electronics_btt_octopus_rpi_400.dxf, panel_electronics_btt_octopus_rpi_500.dxf, panel_electronics_btt_skr_pro_1_2_rpi_300.dxf, panel_electronics_btt_skr_pro_1_2_rpi_400.dxf, panel_electronics_btt_skr_pro_1_2_rpi_500.dxf, panel_electronics_duet3_mb6hc_300.dxf, panel_electronics_duet3_mb6hc_400.dxf]
2021-09-14 Added bed files for SuperSlicer
    [ratrig-vcore-bed-400x400.stl, ratrig-vcore-bed-500x500.stl]
2021-09-16 Add config for larger printers
    The V-Core-3 400 and 500mm are now selectable as printer profiles.
2021-09-19 Fix explanation of input shaper and adxl wiring
2021-09-19 version 0.5.1
    Reduced maximum volumetric flow to 12mm/s to better accomodate for the V6 flow restrictions
    changed seam position to "aligned" for overall better appearance
    redzced anchor size to 2mm
    increased top and bottom layers in 0.15-profile to 8 for better strength
    increased infill speed in 0.15 profile
2021-09-21 profile 0.6
    New PETG profiles: V6 and High-Flow
    PETG V6 is now printing at 245°, capped at 11mm^3/s
    PETG HF is priting at 235° and capped at 25mm°3/s
2021-09-21 Update SuperSlicer 0.6
    profile 0.6
    ABS layer time 8s
    First version of HF print profiles - use only with High Flow hotends.
    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
2021-09-25 DXF: Move DXF files into a subdirectory
    Both DXF and STEP files are being offered, so move the existing DXF files into a DXF subdirectory.
    [panel_base_300.dxf, panel_base_400.dxf, panel_base_500.dxf, panel_door_300.dxf, panel_door_400.dxf, panel_door_500.dxf, panel_electronics_btt_octopus_rpi_300.dxf, panel_electronics_btt_octopus_rpi_400.dxf]
2021-09-25 DXF: Remove laser kerf from all files
    The panel DXFs were originally exported with a 0.15mm laser kerf allowance on all dimensions.
    There is no standard as to whether this should be included in the DXF dimensions, or whether an individual laser cutter operator will add it. Further, differing machines have differing kerf requirements.
    As such, all DXF files are now provided with zero laser kerf allowance.
    [panel_base_300.dxf, panel_base_400.dxf, panel_base_500.dxf, panel_door_300.dxf, panel_door_400.dxf, panel_door_500.dxf, panel_electronics_btt_octopus_rpi_300.dxf, panel_electronics_btt_octopus_rpi_400.dxf]
2021-09-25 STEP: Add STEP files for all panels
    Proving both STEP and DXF for all panels should cover all requirements for users wishing to have panels produced.
    [panel_base_300.step, panel_base_400.step, panel_base_500.step, panel_door_300.step, panel_door_400.step, panel_door_500.step, panel_electronics_btt_octopus_rpi_300.step, panel_electronics_btt_octopus_rpi_400.step]
2021-09-27 1.0.2 release changes
    [V-Core 3 Enclosure Kit Public BOM - spool holder.csv, V-Core 3 Enclosure Kit Public BOM.csv, enc_3030_end_cap.step, enc_3030_end_cap.stl, enc_3030_spool_holder_guide.step, enc_3030_spool_holder_guide.stl, enc_door_hinge_door.step, enc_door_hinge_door.stl]
2021-09-28 BOM: Corrections to enclosure BOM
    [V-Core 3 Enclosure Kit Public BOM - spool holder.csv, V-Core 3 Enclosure Kit Public BOM.csv, printed_parts.csv]
2021-09-28 add electronics enclosure shelves
    [V-Core 3 Enclosure Kit Public BOM.csv, printed_parts.csv, shelf_left_300.step, shelf_left_300.stl, shelf_left_400.step, shelf_left_400.stl, shelf_left_500.step, shelf_left_500.stl]
2021-09-30 Add missing sacrificail layers to the lead_screw_motor_cage_back part
    [lead_screw_motor_cage_back.step, lead_screw_motor_cage_back.stl]
2021-09-30 add Spollholder v2 parts
    [3030 Spool Holder Mount.step, 3030 Spool Holder Mount.stl, 3030_end_cap.step, 3030_end_cap.stl, printed_parts.csv, printed_parts_accessories.csv, printed_parts_essentials.csv, printed_parts_extras.csv]
2021-09-30 move old spool holder to the directory
    [printed_parts_extras.csv, spool_holder_3030_arm_v2_rr.step, spool_holder_3030_arm_v2_rr.stl, spool_holder_guide.step, spool_holder_guide.stl, spool_holder_knob.step, spool_holder_knob.stl, spool_holder_screw_80mm.step]
2021-10-05 Update spool holder mount v2
    Reduce PTFE holes to 4.3mm
    [3030 Spool Holder Mount.step, 3030 Spool Holder Mount.stl]
2021-10-05 CAD: Upload all size variants of back_spine
    [back_spine.step, back_spine_300.step, back_spine_300.stl, back_spine_400.step, back_spine_400.stl, back_spine_500.step, back_spine_500.stl, printed_parts_extras.csv]
2021-10-06 CAD: Correct all size variants of back_spine
    onShape STEP files are exported with the units set to meters for some reason. The exported STLs therefore were 1000 times too small. Update the STEPs for millimetres and re-export the STLs.
    [back_spine_300.step, back_spine_300.stl, back_spine_400.step, back_spine_400.stl, back_spine_500.step, back_spine_500.stl]
2021-10-08 SuperSlicer 0.6.1
    Optimizations for v-core-os (relative extrusion mode)
2021-10-16 0.6.2: Improved bridge handling
    Optimised the handling of sacrificial layers (pokey-holes)
2021-11-06 add the modified Z back motor mount
    [lead_screw_motor_cage_back.step, lead_screw_motor_cage_back.stl]
2021-11-23 change BOM to Compressible idlers
    [V-CORE 3.0 - pub.csv]
2021-11-27 Update firmware.md
    Add a warning that both the guide, and the provided configuration, are designed for use with the Duet 3 Mini 5+ only. Changes are required for other RRF supported boards due to differences in pin names, IO capabilities, and several other factors.
2021-12-19 Fix Duet3 6HC wiring and firmware guides, upgrade deps
    [config.g]
2021-12-22 Update index.md
    Provide details and links to the VC3 enclosure and spool holder
2021-12-29 Fix minor BOM issue
    [V-Core 3 Enclosure Kit Public BOM.csv]
2021-12-30 improve 3030 endcaps
    [enc_3030_end_cap.step, enc_3030_end_cap.stl]
2022-01-05 RRF: Remove M404 from config.g
    This gcode is not required, is being deprecated, and is known to cause issues on RRF 3.3.
    [config.g]
2022-01-12 Update sample print images
2022-01-16 Update BTT Octopus wiring diagram
2022-01-24 RRF: Update homing routines
    Update all home*.g to adjust accelerations during the homing move.
    Also remove unnecessary M574 from config.g
    [config.g, homeall.g, homex.g, homey.g, homez.g]
2022-02-09 Update Octopus wiring diagram
2022-02-17 Update V-Core 3 BOM
    [V-CORE 3.0 - pub.csv, vcore3_17022022_1046.csv]
2022-03-28 Update CAD URLs to new Fusion Team viewer
2022-04-05 Update config.g
    Fix config.g start -- G29 S1 loads a mesh if it is available and doesn't set the units to mm. Fixed so the command matches the comment
    [config.g]
2022-05-16 fix M552 command; create updated zip archive
    [config.g]
2022-05-16 L255 on the M106 means fans can only go on or off, with no partial fan control possible. This is especially unwanted on the part cooling fan
    [config.g]
2022-06-03 Update EVA Version on BOM
2022-06-19 Assign fans according to convention
    [config.g]
2022-06-24 Remove D3 setting from motor definitions to allow RRF default to be applied (changed in 3.4 for 2209 drivers); add heater-fault.g and stop.g to re-instate proper heater fault handling (changed in 3.4)
    [config.g, heater-fault.g, stop.g]
2022-06-30 Remove V-Core 3.0 CAD data
    [3030 Cable Clip.step, 3030 Cable Clip.stl, 3030 Spool Holder Mount.step, 3030 Spool Holder Mount.stl, 3030_end_cap.step, 3030_end_cap.stl, MGN12 3030 Centering Tool V1.0.step, MGN12 3030 Centering Tool V1.0.stl]
2022-06-30 Add V-Core 3.1 panels
    - New electronics panel
    - New base panel
    [panel_base_200_3.1.dxf, panel_base_200_3.1.step, panel_base_300_3.1.dxf, panel_base_300_3.1.step, panel_base_400_3.1.dxf, panel_base_400_3.1.step, panel_base_500_3.1.dxf, panel_base_500_3.1.step]
2022-06-30 Add V-Core 3.1 Printed Parts
    STL and STEP included. Layout has changed (core, electronics, enclosure, spoolholder)
    [3030_end_cap.step, 3030_end_cap.stl, 3030_spool_holder.step, 3030_spool_holder.stl, 3030_spool_holder_guide.step, 3030_spool_holder_guide.stl, MGN12-3030-Centering-Tool-V1.0.stl, bed_arm_back_3.1.step]
2022-06-30 Update bom.md
    Add new printed parts
    Update BOM for V-Core 3.1
    [printed_parts_accessories.csv, printed_parts_core.csv, printed_parts_electronics.csv, printed_parts_enclosure.csv, printed_parts_essentials.csv, printed_parts_extras.csv, vcore31_06272022_2240.csv]
2022-06-30 Update bom.md
    Clean up BOM page, remove all printed part lists (moving to printed_parts.md)
2022-06-30 Update plugin.py
    Add new printed_parts_bom_31 function for new printed_parts.md layout.
    We add a new function rather than modify the original to prevent breaking the Legacy V-Core BOM
2022-06-30 Update printed_parts.md
    - Update title
    - Move printed part BOMs to this page
    - Remove print orientation imagery, all parts are provided in the correct orientation
2022-06-30 Update printed part BOMs
    [printed_parts_core.csv, printed_parts_electronics.csv, printed_parts_enclosure.csv]
2022-06-30 Update upgrade.md
    Add upgrade kit BOM and required printed parts list
    [printed_parts_30_upgrade.csv, vcore30_upgrade_06262022_1036.csv]
2022-06-30 Add EVA 3.0.1 Printed Parts
    [40mm_fan_inlet.step, 40mm_fan_inlet.stl, back_core_xy.step, back_core_xy.stl, bottom_horns_volcano.step, cable_guide.step, cable_guide.stl, cable_guide_mount.step]
2022-06-30 Add EVA3 printed parts BOM
    [printed_parts_eva3_0_1.csv]
2022-06-30 Add Rat Rig EVA3 Shroud
    [printed_parts_eva3_0_1.csv, ratrig_eva3_shroud.step, ratrig_eva3_shroud.stl]
2022-06-30 Add ZIP files for STEP, STL and DXF
2022-06-30 Add EVA3 regular duct & hotend_mosquito
    [bottom_horns.step, hotend_mosquito.step, hotend_mosquito.stl, printed_parts_eva3_0_1.csv]
2022-06-30 Update CAD links for 3.1
2022-06-30 Fix V-Core 3.0 BOM & links
    [V-Core 3 Enclosure Kit Public BOM - spool holder.csv, V-Core 3 Enclosure Kit Public BOM.csv, printed_parts_accessories.csv, printed_parts_essentials.csv, printed_parts_extras.csv, vcore3_05042022_1602.csv]
2022-07-01 Add EVA3 BOM to upgrade.md
    [eva3_0_1_hardware_07012022_0937.csv]
2022-07-01 Update landing page for V-Core 3.1
2022-07-04 Add split electronics panel source files
    [panel_electronics_split_300_plain_bottom_left.dxf, panel_electronics_split_300_plain_bottom_left.step, panel_electronics_split_300_plain_bottom_right.dxf, panel_electronics_split_300_plain_bottom_right.step, panel_electronics_split_300_plain_right_left.dxf, panel_electronics_split_300_plain_top_left.dxf, panel_electronics_split_300_plain_top_left.step, panel_electronics_split_300_plain_top_right.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]
2022-07-05 Update imagery on landing page
2022-07-05 Update STL & STEP files
    Fix a print orientation error in xy_joiner_left_3.1 and xy_joiner_right_3.1
    [xy_joiner_left_3.1.step, xy_joiner_left_3.1.stl, xy_joiner_right_3.1.step, xy_joiner_right_3.1.stl]
2022-07-06 Update EVA3 to 3.0.2
    - Add BLTouch mounts
    - Update CAD archives
    - Update BOM CSV data
    [bl_touch_mount.step, bl_touch_mount.stl, bl_touch_mount_volcano.step, bl_touch_mount_volcano.stl, eva3_0_1_hardware_07012022_0937.csv, eva3_0_2_hardware_07062022_0928.csv, printed_parts_eva3_0_1.csv, printed_parts_eva3_0_2.csv]
2022-07-06 Add EVA3 printed parts to upgrade.md
2022-07-07 Update index.md
    Correct 220V to 120.220V
2022-07-11 Fix homing sequences -- H2 parameter not used for backoff moves in Core kinematics, see https://forum.duet3d.com/topic/29180/possible-bug-observed-after-v3-3-to-3-4-1-update. Also, lower initial homi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
    [homeall.g, homex.g, homey.g]
2022-07-11 Update config.g to have more appropriate current settings. Keeping them a bit low for use with Duet3 mini 5+ board. Better settings would require a more thorough refactoring. Also change name to be c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
    [config.g]
2022-07-12 reduce switching frequency on SSR
    [config.g]
2022-07-12 Update 3.1 Upgrade BOM
    [vcore31_upgrade_07122022_1039.csv]
2022-07-12 Add wiring / firmware details for 4028 fans
2022-07-13 Add base_panel 3.0 to 3.1 data
    [lead_screw_motor_cage_back_trim_30_to_31.step, lead_screw_motor_cage_back_trim_30_to_31.stl]
2022-07-27 Add 4028 voltage warning
2022-07-28 Update CAD archives
    Add missing split electronics panel CAD data
2022-08-01 Update Y-axis end-stop CAD files
    [y_max_endstop_block_3.1.step, y_max_endstop_block_3.1.stl, y_max_endstop_slider_3.1.step, y_max_endstop_slider_3.1.stl]
2022-08-02 Correct panels.md
    Currently only a single, plain, version of the electronics panel is provided
2022-08-26 Update community.md
    Swap out material icons due to occasional rendering issue
2022-08-30 Update lead_screw_constraint_front CAD parts
    Added missing L & R markings. No other changes.
    [lead_screw_constraint_front_left_3.1.step, lead_screw_constraint_front_left_3.1.stl, lead_screw_constraint_front_right_3.1.step, lead_screw_constraint_front_right_3.1.stl]
2022-09-23 Enclosure 2.0: Add CAD links
2022-09-23 Enclosure 2.0: Add CAD links for Split Panel Designs
2022-09-23 Enclosure 1.0: Remove CAD data
    [3030_end_cap.step, 3030_end_cap.stl, door_hinge_door.step, door_hinge_door.stl, door_hinge_frame.step, door_hinge_frame.stl, enclosure_filler.step, enclosure_filler.stl]
2022-09-23 Enclosure 2.0: Update base panel design
    [panel_base_200_3.1.dxf, panel_base_200_3.1.step, panel_base_300_3.1.dxf, panel_base_300_3.1.step, panel_base_400_3.1.dxf, panel_base_400_3.1.step, panel_base_500_3.1.dxf, panel_base_500_3.1.step]
2022-09-23 Enclosure 2.0: Add panel DXF & STEP data
    [panel_enc2_back_200.dxf, panel_enc2_back_200.step, panel_enc2_back_300.dxf, panel_enc2_back_300.step, panel_enc2_back_400.dxf, panel_enc2_back_400.step, panel_enc2_back_500.dxf, panel_enc2_back_500.step]
2022-09-23 Enclosure 2.0: Add printed parts
    [3030_panel_mount_horizontal.step, 3030_panel_mount_horizontal.stl, 3030_panel_mount_vertical.step, 3030_panel_mount_vertical.stl, enclosure2_corner_trim_3mm.step, enclosure2_corner_trim_3mm.stl, enclosure2_corner_trim_4mm.step, enclosure2_corner_trim_4mm.stl]
2022-09-23 Add new electronics_wire_guide
    [electronics_wire_guide.step, electronics_wire_guide.stl, electronics_wire_guide_clip.step, electronics_wire_guide_clip.stl, printed_parts_electronics.csv]
2022-09-23 Update CAD archives
2022-09-23 Enclosure 2.0: Split Panel 200 & 300 CAD links
2022-09-23 Enclosure 2.0: Add BOM
    [V-Core 3 Enclosure Kit Public BOM - spool holder.csv, V-Core 3 Enclosure Kit Public BOM.csv, enclosure2_09232022_1551.csv]
2022-09-23 Enclosure 2.0: Project page update
2022-09-26 Add missing holes to 300,400 & 500 enclosure 2 door panel
    [panel_enc2_door_300.dxf, panel_enc2_door_300.step, panel_enc2_door_400.dxf, panel_enc2_door_400.step, panel_enc2_door_500.dxf, panel_enc2_door_500.step]
2022-09-26 Add filler for pre-enclosure 2 base panel
    [enclosure2_base_panel_filler.step, enclosure2_base_panel_filler.stl, printed_parts_enclosure_optional.csv]
2022-09-26 Update CAD archive
2022-09-26 BOM: Remove RPi from standard kits & add sourcing information
    [vcore31_09262022_1855.csv]
2022-10-10 Update Enclosure 2.0 spool holder design
    Small change to improve printability
    [enclosure2_spool_holder_3mm.step, enclosure2_spool_holder_3mm.stl, enclosure2_spool_holder_4mm.step, enclosure2_spool_holder_4mm.stl, enclosure2_spool_holder_5mm.step, enclosure2_spool_holder_5mm.stl]
2022-10-10 Update V-Core 3.1 BOM
    [vcore31_10102022_1732.csv]
2022-10-13 Update Enclosure 2.0 magnet mounts
    Increase magnet recesses from a depth of 4mm to 5mm
    [panel_magnet_holder.step, panel_magnet_holder.stl, panel_magnet_mount.step, panel_magnet_mount.stl]
2022-10-13 Add suggested filament route for Enclosure
2022-10-21 Update EVA3 BOM
    Correct M3x6 to M3x8 for LGX Lite
    [eva3_0_2_hardware_21102022_1548.csv, vcore31_21102022_1550.csv]
2022-11-29 Add sacrificial layers to ratrig_eva3_shroud
    [ratrig_eva3_shroud.step, ratrig_eva3_shroud.stl]
2022-12-05 Update VC3 BOM
    Minor SKU update
    [vcore31_1205022_11331.csv]
2022-12-12 Update RPi information on BOM.md
2023-01-12 Update printed_parts.md
    - Clarify that the CAD archive contains all printed parts and panels
    - Add direct link to panel data on GitHub
2023-01-12 Add spool holder & PTFE guide
    [enclosure2_bowden_clamp.step, enclosure2_bowden_clamp.stl, enclosure2_spool_holder_4mm.step, enclosure2_spool_holder_4mm.stl, printed_parts_core.csv]
2023-01-12 Update VC3 BOM
    Spool holder & PTFE holder, plus internal changes
    [vcore31_12012023_1703.csv]
2023-03-22 Add electronics panel variants for all sizes
    These panels are designed for mounting the default V-Core 3.1 electronics, and match the electronics / wiring guide.
    [panel_electronics_300.dxf, panel_electronics_300.step, panel_electronics_400.dxf, panel_electronics_400.step, panel_electronics_500.dxf, panel_electronics_500.step, panel_electronics_split_300_bottom_left.dxf, panel_electronics_split_300_bottom_left.step]
2023-03-22 Remove mkdocs-material-insiders
2023-03-23 Update CAD archives with new panels
2023-03-23 Add link to wiring guide on electronics page
2023-04-03 Add warning regarding enclosed printed parts
2023-04-26 Add missing electronics panel files for 200
    [panel_electronics_200.dxf, panel_electronics_200.step]
2023-07-13 Update Enclosure 2.0 BOM
    Remove split panel additions, the base BOM includes them now
    [enclosure2_07132023_1041.csv]
2023-07-17 Increase clearances on electronics_panel_200
    When using the 3D printed panel collar, the position of the passthrough hole for the heated bed cabling caused the printed part to partially interfere with the 3030 cast bracket.
    Both the passthrough hole, and the mounting for the Raspberry Pi, have been raised by 5mm to ensure clearance.
    [panel_electronics_200.dxf, panel_electronics_200.step]
2023-07-18 Remove deprecated BOM data
    [enclosure2_07132023_1041.csv, eva3_0_2_hardware_07062022_0928.csv, vcore31_06272022_2240.csv, vcore31_09262022_1855.csv, vcore31_10102022_1732.csv, vcore31_1205022_11331.csv, vcore31_21102022_1550.csv]
2023-07-18 Remove dates from BOM filenames
    [enclosure2_bom.csv, eva3_0_2_hardware.csv, vcore31_bom.csv, vcore31_upgrade.csv]
2023-07-18 Update VC3 BOM
    Add 8x missing "Washer Simple M6 - Black 12.9 Steel"
    [vcore31_bom.csv]
2023-07-25 IDEX: Add panel DXF & STEP data
    [panel_enc2_idex_back_300.dxf, panel_enc2_idex_back_300.step, panel_enc2_idex_back_400.dxf, panel_enc2_idex_back_400.step, panel_enc2_idex_back_500.dxf, panel_enc2_idex_back_500.step, panel_enc2_idex_base_300.dxf, panel_enc2_idex_base_300.step]
2023-07-25 IDEX: Update CAD archive with panels
